KatsukiOishi/HikkiKomori/DOC/電子回路.png

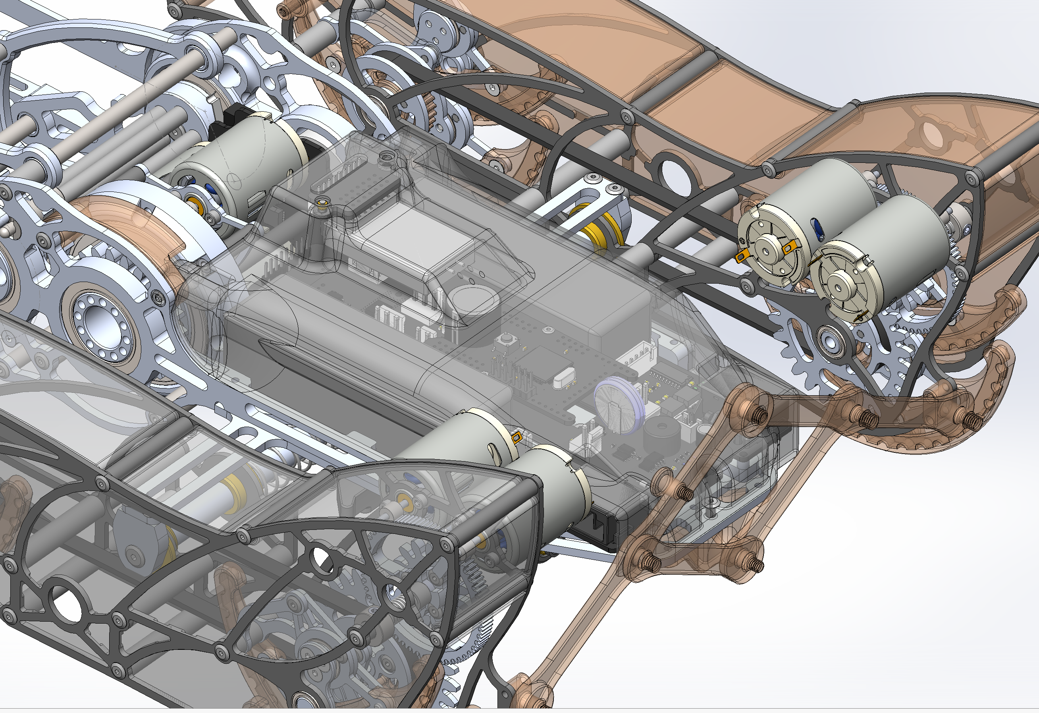
DOC/電子回路.png
