KatsukiOishi/HikkiKomori/DOC/裏面.png

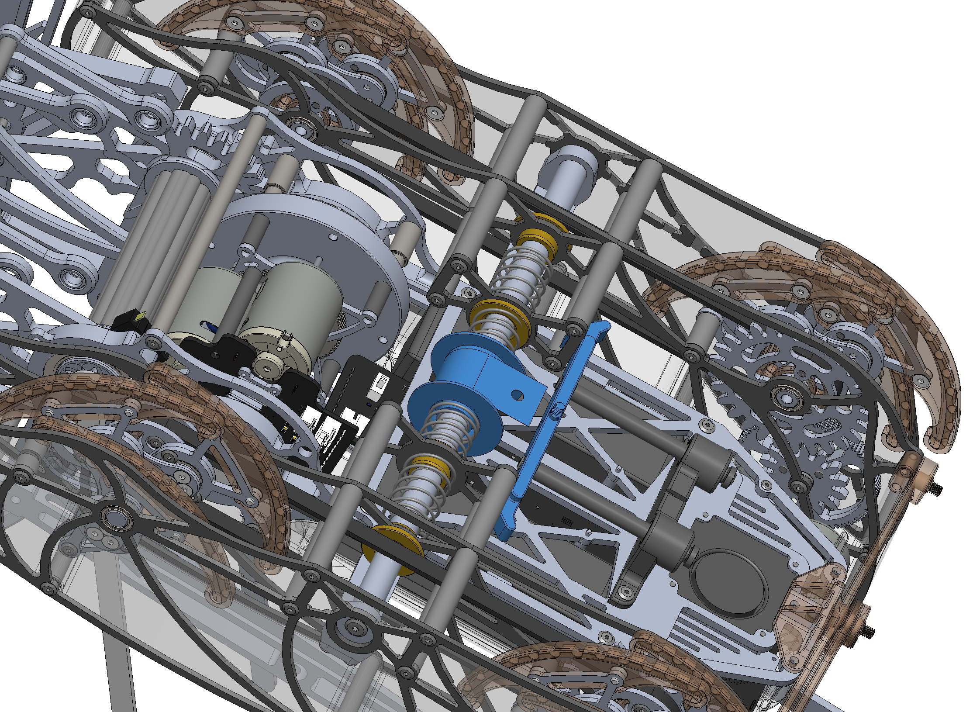
DOC/裏面.png
