KatsukiOishi/HikkiKomori/DOC/1.docx

1.ロボットの構造

ロボットは、”腕”を備えた「腕機構」、”動力源”たるバッテリー及び”通信機器”たる受信機及び制御回路を備えた「電装部」で構成される「中央ユニット」と、前記ユニットの左右それぞれに、移動のための”脚”が前後２つに搭載された「脚機構ユニット」が接続される構成となっている。“腕”の”駆動源”たるモーターは「腕機構」に３つ、”脚”の”駆動源”たるモーターは両側の「脚機構ユニット」にそれぞれ２つ搭載されており、ロボット全体では計７つ搭載される。モーターはいずれもタミヤ製「380スポーツチューンモーター」である。

2.ロボットの展開機構の動作概要

本機はスタート操作により、自動的に展開動作を開始する構造となっている。

1. 腕機構の作動 スタート時、「腕機構」に備えられた“アーム作動面”（ロングロッド）は、折りたたまれた状態で収納されている。スタート後に「腕機構」が作動することで、ロッド内に内蔵されたバネの反力によってロングロッドが前方へ大きく伸長する。
2. 脚機構ユニットの展開 「脚機構ユニット」の取付部には、「腕機構」と連動するワイヤが接続されており、このワイヤによりロック部品が解除される仕組みとなっている。ロック解除により、「脚機構ユニット」に内蔵された展開用バネが作動し、左右両側のユニットがそれぞれ外側に向かって展開される。

3.ロボットのサイズ

ロボットの初期状態は幅245mm、全長340mm、高さ200mmに収納されており、展開動作後は幅310mm、全長800mm、高さ560mm(最大アーム高さ)へと展開する。また、重量は3200gとなっている（設計時シュミレート）。

4.独自の動力電装系の実装

本機では、専用に開発された動力制御回路を電装部に搭載し、バッテリーの監視や、受信機からの信号を元に適切なモーターコントロールを行っている。
　バッテリーには近藤科学のLiFeバッテリーが２つ搭載されており、バッテリー及び回路保護のためのアクリルカバーが設けられている。
　”通信機器”たる受信機および送信機は双葉電子工業製のヘリ向けプロポを採用している。

5.脚機構

「脚機構ユニット」については1章にて述べた通り左右に２ユニット搭載されている。１ユニットにつき前後１つずつ”脚”が搭載されており、前後の”脚”はタイミングベルトによって同期駆動する。”駆動源”たるモーターは「脚機構ユニット」の後方上部に２つ搭載されており、前後の”脚”へ動力を供給する。

“脚”の構造にはヘッケンリンクを応用した四節リンク機構を採用しており、クランク軸を介して”駆動源”の動力が伝えられることで、120度ずつ位相をずらした３脚分の”脚機構”が駆動される。脚機構と床面の接触部となる”足裏”にはシリコンゴム製のパーツが取り付けられ、床面とのグリップ力を発揮する。

6.腕機構

「腕機構ユニット」については1章にて述べた通りスタート後に展開されるロングロッドを”アーム作動面”に有したリンク機構が”腕機構” として採用されている。

“腕機構”の構成としては、動力源となる「駆動節」と、敵機と接触する”アーム作動面”としての「従動節」、リンク機構を正しく動作させるために「従動節」の駆動を制限する「中間節」によって構成されており、「駆動節」を回転駆動させる回転動力は、”駆動源”たるモーター３基からの動力を、減速機を介して一つにまとめて供給する。

「駆動節」へ伝達された動力は、緑線にて示される「中間節」によって動きを制限されつつ、紫線によって図示される「従動節」へ伝達され、最終的に”アーム作動面”は左下図に示すような軌道を描きながら動作する。

回転動力となる「駆動節」は100度程度の角度範囲で動作し、無限回転はしない。

腕機構には随所に樹脂製のカバーを取り付け、駆動時の指巻き込みや機体巻き込みによる事故に配慮する構造となっている。
