KatsukiOishi/HikkiKomori/DOC/収納サイズ.png

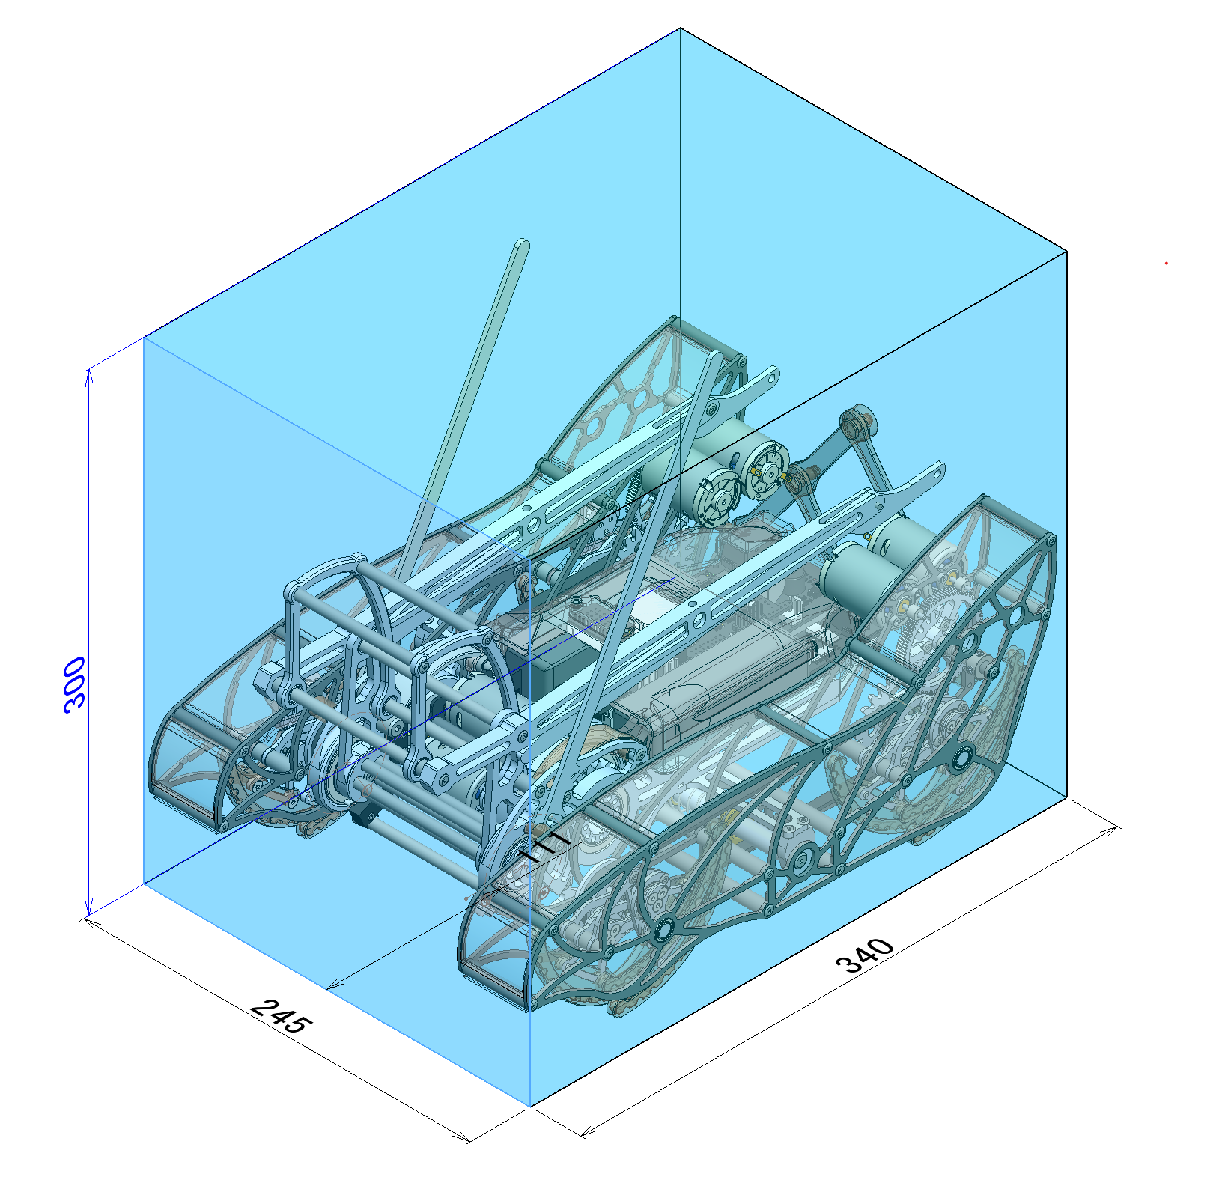
DOC/収納サイズ.png
