KatsukiOishi/HikkiKomori/DOC/展開サイズ.png

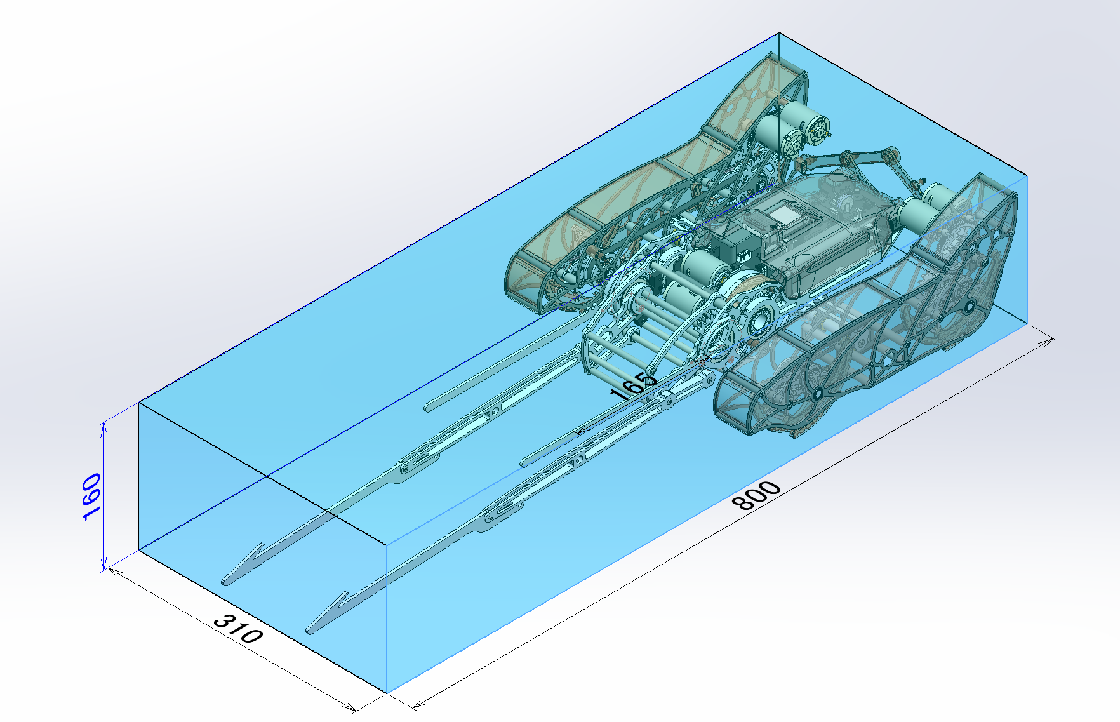
DOC/展開サイズ.png
