KatsukiOishi/HikkiKomori/DOC/腕機構１.png

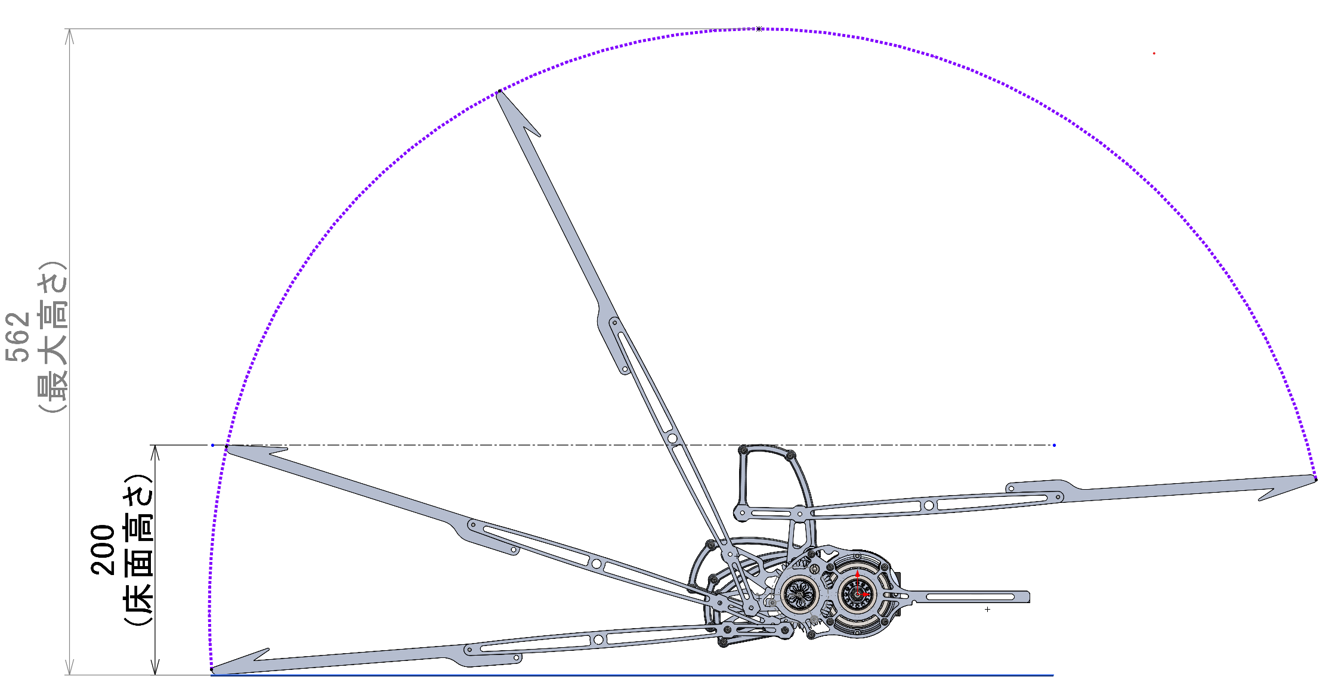
DOC/腕機構１.png
