KatsukiOishi/HikkiKomori/DOC/腕機構2.png

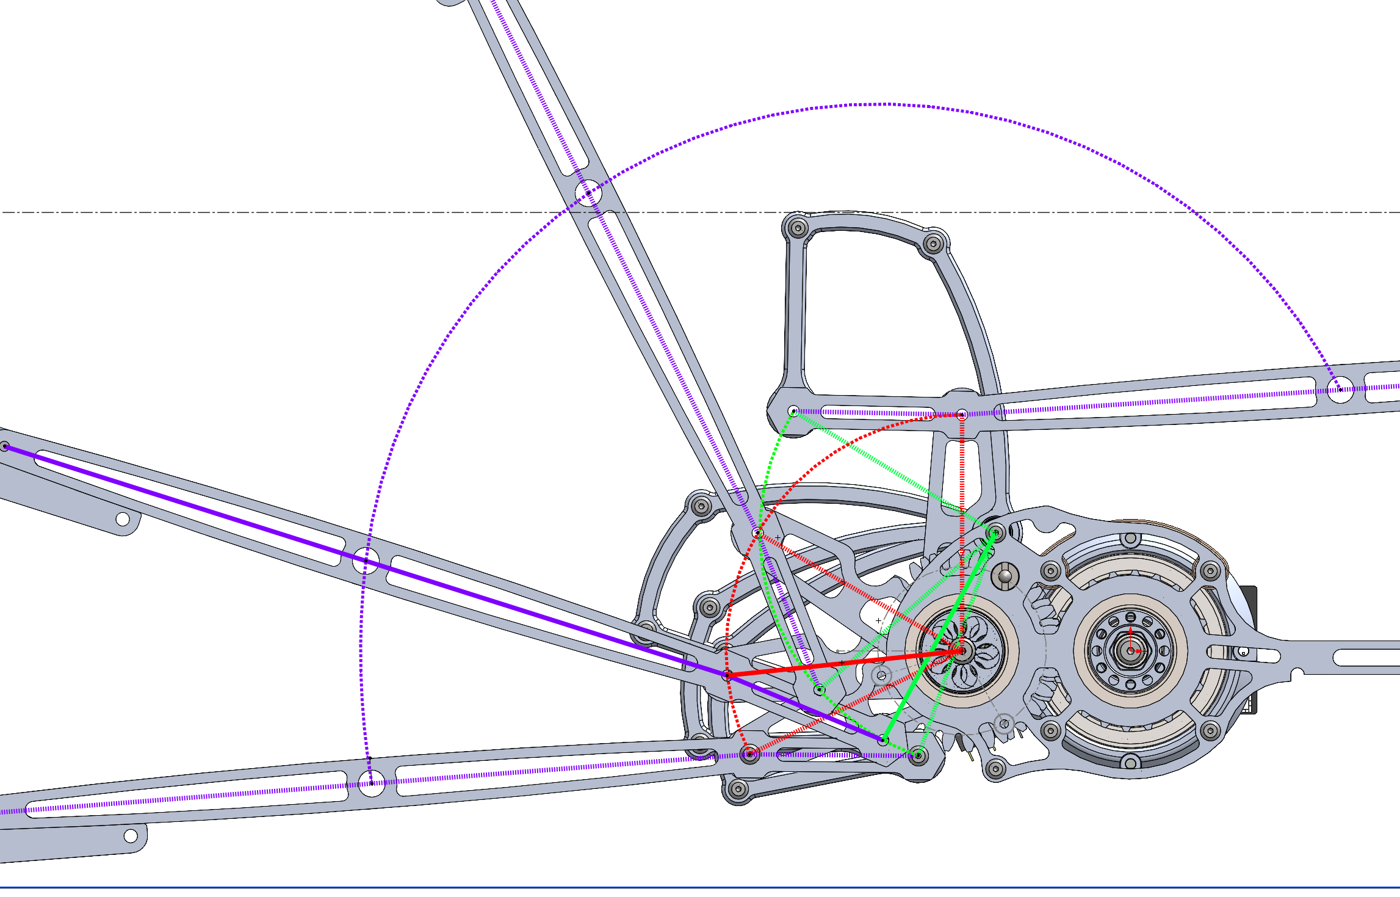
DOC/腕機構2.png
