KatsukiOishi/HikkiKomori/DOC/足機構.png

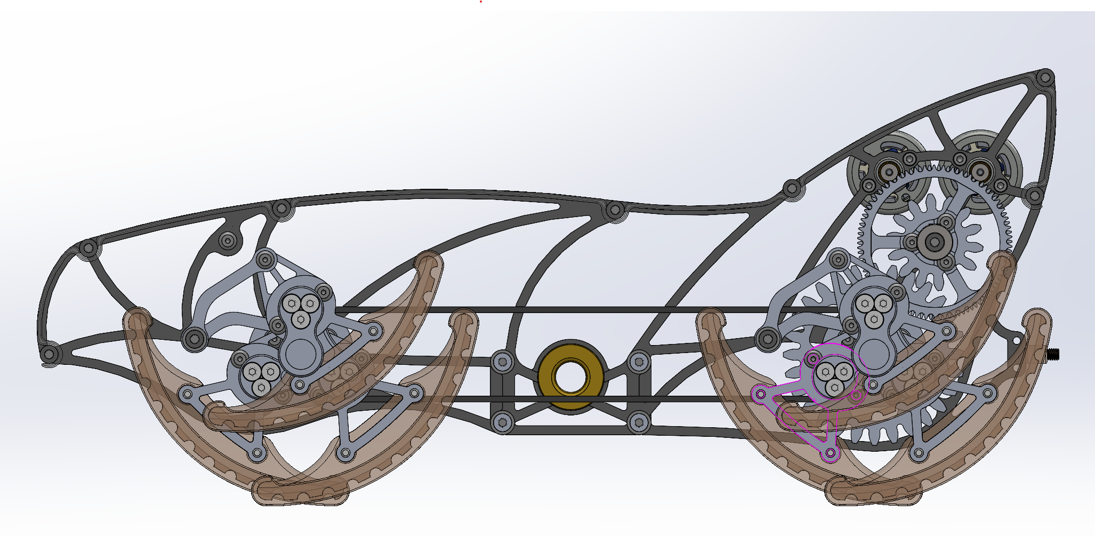
DOC/足機構.png
