KatsukiOishi/HikkiKomori/機械設計/_BOM/BOM.xlsx

Sheet: Sheet1
種類 | 部分 | 品番 | 手配先 | メーカー | 部品名 | 材料 | 個数 | 式 | 総個数 | 記 事 | 分類 | 出荷日 | 単価 | 表面処理 | 表面処理法 | 表面処理法補足 | 熱処理 | 熱処理法 | 硬度
組立品 | 0 | CU001 |  |  | 中央ユニット |  | 1 | 1 | 1 | 組立品(組図を参照) |  |  |  | 無 |  |  | 無
組立品 | 0 | RL001 |  |  | 左半身機構 |  | 1 | 1 | 1 | 組立品(組図を参照) |  |  |  | 無 |  |  | 無
組立品 | 0 | RR001 |  |  | 右半身機構 |  | 1 | 1 | 1 | 組立品(組図を参照) |  |  |  | 無 |  |  | 無
組立品 | CU001 | CU-SAS001 |  |  | 中央躯体 |  | 1 | 1 | 1 | 組立品(組図を参照) |  |  |  | 無 |  |  | 無
組立品 | CU001 | CU-SAS002 |  |  | 腕機構 |  | 1 | 1 | 1 | 組立品(組図を参照) |  |  |  | 無 |  |  | 無
組立品 | CU-SAS001 | CU-SAS003 |  |  | 展開機構 |  | 1 | 1 | 1 | 組立品(組図を参照) |  |  |  | 無 |  |  | 無
組立品 | CU-SAS002 | CGA75-RS380-4 |  |  | 腕機構減速機 |  | 1 | 1 | 1 | 組立品(組図を参照) |  |  |  | 無 |  |  | 無
組立品 | CU-SAS002 | CU-AAS001 |  |  | アームリンク中関節 |  | 1 | 1 | 1 | 組立品(組図を参照) |  |  |  | 無 |  |  | 無
組立品 | CU-SAS002 | CU-AAS002 |  |  | アームリンク駆動節 |  | 1 | 1 | 1 | 組立品(組図を参照) |  |  |  | 無 |  |  | 無
組立品 | CU-SAS002 | CU-AAS003L |  |  | ロングロッド左 |  | 1 | 1 | 1 | 組立品(組図を参照) |  |  |  | 無 |  |  | 無
組立品 | CU-SAS002 | CU-AAS003R |  |  | ロングロッド右 |  | 1 | 1 | 1 | 組立品(組図を参照) |  |  |  | 無 |  |  | 無
組立品 | RL001 | R-SA001 |  |  | 足中間歯車 |  | 1 | 1 | 1 | 組立品(組図を参照) |  |  |  | 無 |  |  | 無
組立品 | RL001 | RL-HL001 |  |  | ヘッケンリンク左半身後方 |  | 1 | 1 | 1 | 組立品(組図を参照) |  |  |  | 無 |  |  | 無
組立品 | RL001 | RL-HL002 |  |  | ヘッケンリンク左半身前方 |  | 1 | 1 | 1 | 組立品(組図を参照) |  |  |  | 無 |  |  | 無
組立品 | RL-HL001 | RL-HL-RAS001 |  |  | 足単体左半身側 |  | 3 | 1 | 3 | 組立品(組図を参照) |  |  |  | 無 |  |  | 無
組立品 | RL-HL002 | RL-HL-RAS001 |  |  | 足単体左半身側 |  | 3 | 1 | 3 | 組立品(組図を参照) |  |  |  | 無 |  |  | 無
組立品 | RR001 | R-SA001 |  |  | 足中間歯車 |  | 1 | 1 | 1 | 組立品(組図を参照) |  |  |  | 無 |  |  | 無
組立品 | RR001 | RR-HL001 |  |  | ヘッケンリンク右半身後方 |  | 1 | 1 | 1 | 組立品(組図を参照) |  |  |  | 無 |  |  | 無
組立品 | RR001 | RR-HL002 |  |  | ヘッケンリンク右半身前方 |  | 1 | 1 | 1 | 組立品(組図を参照) |  |  |  | 無 |  |  | 無
組立品 | RR-HL001 | RR-HL-RAS001 |  |  | 足単体右半身側 |  | 3 | 1 | 3 | 組立品(組図を参照) |  |  |  | 無 |  |  | 無
組立品 | RR-HL002 | RR-HL-RAS001 |  |  | 足単体右半身側 |  | 3 | 1 | 3 | 組立品(組図を参照) |  |  |  | 無 |  |  | 無
組立品 | R-SA001 | R-SA-GAS001 |  |  | 足中間歯車1 |  | 1 | 2 | 2 | 組立品(組図を参照) |  |  |  | 無 |  |  | 無
組立品 | CGA75-RS380-4 | CGA75 |  |  | 内接減速機構 |  | 1 | 1 | 1 | 組立品(組図を参照) |  |  |  | 無 |  |  | 無
社内加工品 | 0 | LS-P003 |  |  | リンクサス短辺 | AR-M2 | 2 | 1 | 2 |  |  |  |  | 無 |  |  | 無
社内加工品 | 0 | LS-P002 |  |  | リンクサス長辺 | AR-M2 | 2 | 1 | 2 |  |  |  |  | 無 |  |  | 無
社内加工品 | 0 | LS-P004 |  |  | リンクサス中央軸部 | AR-M2 | 1 | 1 | 1 |  |  |  |  | 無 | - | - | 無 | - | -
社内加工品 | 0 | LS-P005 |  |  | リンクサス節軸 | AR-M2 | 3 | 1 | 3 |  |  |  |  | 無 | - | - | 無 | - | -
社内加工品 | CU001 | CU-P001 |  |  | 中央ユニット後方カバー | AR-M2 | 1 | 1 | 1 |  |  |  |  | 無 | - | - | 無 | - | -
社内加工品 | CU-SAS001 | CU-P002 |  |  | 足駆動回路放熱板 | A2017 | 1 | 1 | 1 |  |  |  |  | 無 | - | - | 無 | - | -
社内加工品 | CU-SAS001 | CU-SAS001-P001 |  |  | 中央フレーム | A2017 | 1 | 1 | 1 |  |  |  |  | 無 |  |  | 無
社内加工品 | CU-SAS001 | CU-SAS001-P002 |  |  | 横展開抜止め | A2017 | 2 | 1 | 2 |  |  |  |  | 無 |  |  | 無
社内加工品 | CU-SAS001 | CU-SAS001-P003 |  |  | 中央ユニット主軸 | A2017 | 1 | 1 | 1 |  |  |  |  | 無 |  |  | 無
社内加工品 | CU-SAS002 | CU-AAS-P001 |  |  | カウンターアーム | A2017 | 1 | 1 | 1 |  |  |  |  | 無 | - | - | 無
社内加工品 | CU-SAS002 | CU-AAS-P002 |  |  | ﾐﾗｰカウンターアーム | A2017 | 1 | 1 | 1 |  |  |  |  | 無 | - | - | 無
社内加工品 | CU-SAS002 | CU-AAS-P003 |  |  | 腕機構カバー | AR-M2 | 1 | 1 | 1 |  |  |  |  | 無 | - | - | 無
社内加工品 | CU-SAS002 | CU-AAS-P004 |  |  | ﾐﾗｰ腕機構カバー | AR-M2 | 1 | 1 | 1 |  |  |  |  | 無 | - | - | 無
社内加工品 | CU-SAS002 | CU-SAS002-P001 |  |  | 最集段ピニオン | A2017 | 1 | 1 | 1 |  |  |  |  | 無 | - | - | 無
社内加工品 | CU-SAS002 | CU-SAS002-P002 |  |  | 腕機構内壁 | A2017 | 1 | 1 | 1 |  |  |  |  | 無 | - | - | 無
社内加工品 | CU-SAS002 | CU-SAS002-P003 |  |  | 腕機構内壁 | A2017 | 1 | 1 | 1 |  |  |  |  | 無 | - | - | 無
社内加工品 | CU-SAS003 | CU-SAS003-P001 |  |  | 抑制鍵 | AR-M2 | 1 | 1 | 1 |  |  |  |  | 無 |  |  | 無 | - | -
社内加工品 | CU-SAS003 | CU-SAS003-P002 |  |  | 展開機構ブロック | AR-M2 | 1 | 1 | 1 |  |  |  |  | 無 |  |  | 無 | - | -
社内加工品 | CU-AAS001 | CU-AAS001-P001 |  |  | 中関節 | A2017 | 2 | 1 | 2 |  |  |  |  | 無 |  |  | 無
社内加工品 | CU-AAS002 | CU-AAS002-P001 |  |  | 従動節根本軸 | A2017 | 2 | 1 | 2 |  |  |  |  | 無 |  |  | 無
社内加工品 | CU-AAS002 | CU-AAS002-P002 |  |  | 駆動節歯車付き | A2017 | 1 | 1 | 1 |  |  |  |  | 無 |  |  | 無
社内加工品 | CU-AAS002 | CU-AAS002-P003 |  |  | 駆動節 | A2017 | 1 | 1 | 1 |  |  |  |  | 無 |  |  | 無
社内加工品 | CU-AAS003L | CU-AAS003-P001 |  |  | ロッド先端 | A2017 | 1 | 1 | 1 |  |  |  |  | 無 | - | - | 無 | - | -
社内加工品 | CU-AAS003L | CU-AAS003L-P001 |  |  | 従動節左 | A2017 | 1 | 1 | 1 |  |  |  |  | 無 | - | - | 無 | - | -
社内加工品 | CU-AAS003R | CU-AAS003-P001 |  |  | ロッド先端 | A2017 | 1 | 1 | 1 |  |  |  |  | 無 | - | - | 無 | - | -
社内加工品 | CU-AAS003R | CU-AAS003R-P001 |  |  | 従動節右 | A2017 | 1 | 1 | 1 |  |  |  |  | 無 | - | - | 無 | - | -
社内加工品 | LS001 | LS001-P001 |  |  | リンクサス足側軸部 | AR-M2 | 1 | 0 | 0 |  |  |  |  | 無 | - | - | 無 | - | -
社内加工品 | RL001 | R-P001 |  |  | 足側板内側 | A2017 | 1 | 1 | 1 |  |  |  |  | 無 | - | - | 無 | - | -
社内加工品 | RL001 | R-P002 |  |  | 足機構固定板 | A2017 | 1 | 1 | 1 |  |  |  |  | 有 | アルマイト | 黒 | 無 | - | -
社内加工品 | RL001 | R-P003 |  |  | 足機構上面カバー | AR-M2 | 1 | 1 | 1 |  |  |  |  | 無 | - | - | 無 | - | -
社内加工品 | RL001 | R-P004 |  |  | 足機構主柱 | A2017 | 4 | 1 | 4 |  |  |  |  | 無 | - | - | 無 | - | -
社内加工品 | RL001 | R-P005 |  |  | カウンターアームロック | AR-M2 | 1 | 1 | 1 |  |  |  |  | 無 | - | - | 無 | - | -
社内加工品 | RL001 | RL-P001 |  |  | 足側板左外側 | A2017 | 1 | 1 | 1 |  |  |  |  | 無 | - | - | 無 | - | -
社内加工品 | RL001 | RL-P002 |  |  | 左足機構側面充填樹脂 | AR-M2 | 1 | 1 | 1 |  |  |  |  | 無 | - | - | 無 | - | -
社内加工品 | RL-HL001 | R-HL-P001 |  |  | 足曲軸長偏心体 | A2017 | 2 | 1 | 2 |  |  |  |  | 無 |  |  | 無
社内加工品 | RL-HL001 | R-HL-P002 |  |  | 足曲軸短偏心体 | A2017 | 1 | 1 | 1 |  |  |  |  | 無 |  |  | 無
社内加工品 | RL-HL001 | R-HL-P003 |  |  | 足プーリー中心軸 | A2017 | 1 | 1 | 1 |  |  |  |  | 無 | - | - | 無 | - | -
社内加工品 | RL-HL001 | R-HL-P004 |  |  | 足機構曲軸結合部 | A2017 | 1 | 1 | 1 |  |  |  |  | 無 |  |  | 無
社内加工品 | RL-HL001 | R-HL-P005 |  |  | ヘッケンリンク駆動プーリー | AR-M2 | 1 | 1 | 1 |  |  |  |  | 無 | - | - | 無 | - | -
社内加工品 | RL-HL001 | R-HL-P006 |  |  | 足プーリーフランジ | A2017 | 1 | 1 | 1 |  |  |  |  | 無 | - | - | 無 | - | -
社内加工品 | RL-HL001 | R-HL-P007 |  |  | 足レバー | A2017 | 3 | 1 | 3 |  |  |  |  | 無 | - | - | 無 | - | -
社内加工品 | RL-HL002 | R-HL-P001 |  |  | 足曲軸長偏心体 | A2017 | 2 | 1 | 2 |  |  |  |  | 無 |  |  | 無
社内加工品 | RL-HL002 | R-HL-P002 |  |  | 足曲軸短偏心体 | A2017 | 1 | 1 | 1 |  |  |  |  | 無 |  |  | 無
社内加工品 | RL-HL002 | R-HL-P003 |  |  | 足プーリー中心軸 | A2017 | 1 | 1 | 1 |  |  |  |  | 無 | - | - | 無 | - | -
社内加工品 | RL-HL002 | R-HL-P004 |  |  | 足機構曲軸結合部 | A2017 | 1 | 1 | 1 |  |  |  |  | 無 |  |  | 無
社内加工品 | RL-HL002 | R-HL-P005 |  |  | ヘッケンリンク駆動プーリー | AR-M2 | 1 | 1 | 1 |  |  |  |  | 無 | - | - | 無 | - | -
社内加工品 | RL-HL002 | R-HL-P006 |  |  | 足プーリーフランジ | A2017 | 1 | 1 | 1 |  |  |  |  | 無 | - | - | 無 | - | -
社内加工品 | RL-HL001 | R-HL-P007 |  |  | 足レバー | A2017 | 3 | 1 | 3 |  |  |  |  | 無 | - | - | 無 | - | -
社内加工品 | RL-HL-RAS001 | R-HL-RAS-P001 |  |  | 足上部 | A2017 | 1 | 6 | 6 |  |  |  |  | 無 |  |  | 無
社内加工品 | RL-HL-RAS001 | R-HL-RAS-P002 |  |  | 足下部 | A2017 | 1 | 6 | 6 |  |  |  |  | 無 |  |  | 無
社内加工品 | RL-HL-RAS001 | R-HL-RAS-P003 |  |  | 足ゴム | AR-M2 | 1 | 6 | 6 |  |  |  |  | 無 |  |  | 無
社内加工品 | RL-HL-RAS001 | RR-HL-RAS-P001 |  |  | 前足底左半身側 | AR-M2 | 1 | 6 | 6 |  |  |  |  | 無 |  |  | 無
社内加工品 | RR001 | LS001-P001 |  |  | リンクサス足側軸部 | AR-M2 | 1 | 1 | 1 |  |  |  |  | 無 | - | - | 無 | - | -
社内加工品 | RR001 | R-P001 |  |  | 足側板内側 | A2017 | 1 | 1 | 1 |  |  |  |  | 無 | - | - | 無 | - | -
社内加工品 | RR001 | R-P002 |  |  | 足機構固定板 | A2017 | 1 | 1 | 1 |  |  |  |  | 有 | アルマイト | 黒 | 無 | - | -
社内加工品 | RR001 | R-P003 |  |  | 足機構上面カバー | AR-M2 | 1 | 1 | 1 |  |  |  |  | 無 | - | - | 無 | - | -
社内加工品 | RR001 | R-P004 |  |  | 足機構主柱 | A2017 | 4 | 1 | 4 |  |  |  |  | 無 | - | - | 無 | - | -
社内加工品 | RR001 | R-P005 |  |  | カウンターアームロック | AR-M2 | 1 | 1 | 1 |  |  |  |  | 無 | - | - | 無 | - | -
社内加工品 | RR001 | RR-P001 |  |  | 足側板右外側 | A2017 | 1 | 1 | 1 |  |  |  |  | 無 | - | - | 無 | - | -
社内加工品 | RR001 | RR-P002 |  |  | 右足機構側面充填樹脂 | ｴﾎﾟｷｼ樹脂(充填剤なし) | 1 | 1 | 1 |  |  |  |  | 無 | - | - | 無 | - | -
社内加工品 | RR-HL001 | R-HL-P001 |  |  | 足曲軸長偏心体 | A2017 | 2 | 1 | 2 |  |  |  |  | 無 |  |  | 無
社内加工品 | RR-HL001 | R-HL-P002 |  |  | 足曲軸短偏心体 | A2017 | 1 | 1 | 1 |  |  |  |  | 無 |  |  | 無
社内加工品 | RR-HL001 | R-HL-P003 |  |  | 足プーリー中心軸 | A2017 | 1 | 1 | 1 |  |  |  |  | 無 | - | - | 無 | - | -
社内加工品 | RR-HL001 | R-HL-P004 |  |  | 足機構曲軸結合部 | A2017 | 1 | 1 | 1 |  |  |  |  | 無 |  |  | 無
社内加工品 | RR-HL001 | R-HL-P005 |  |  | ヘッケンリンク駆動プーリー | AR-M2 | 1 | 1 | 1 |  |  |  |  | 無 | - | - | 無 | - | -
社内加工品 | RR-HL001 | R-HL-P006 |  |  | 足プーリーフランジ | A2017 | 1 | 1 | 1 |  |  |  |  | 無 | - | - | 無 | - | -
社内加工品 | RR-HL001 | R-HL-P007 |  |  | 足レバー | A2017 | 3 | 1 | 3 |  |  |  |  | 無 | - | - | 無 | - | -
社内加工品 | RR-HL002 | R-HL-P001 |  |  | 足曲軸長偏心体 | A2017 | 2 | 1 | 2 |  |  |  |  | 無 |  |  | 無
社内加工品 | RR-HL002 | R-HL-P002 |  |  | 足曲軸短偏心体 | A2017 | 1 | 1 | 1 |  |  |  |  | 無 |  |  | 無
社内加工品 | RR-HL002 | R-HL-P003 |  |  | 足プーリー中心軸 | A2017 | 1 | 1 | 1 |  |  |  |  | 無 | - | - | 無 | - | -
社内加工品 | RR-HL002 | R-HL-P004 |  |  | 足機構曲軸結合部 | A2017 | 1 | 1 | 1 |  |  |  |  | 無 |  |  | 無
社内加工品 | RR-HL002 | R-HL-P005 |  |  | ヘッケンリンク駆動プーリー | AR-M2 | 1 | 1 | 1 |  |  |  |  | 無 | - | - | 無 | - | -
社内加工品 | RR-HL002 | R-HL-P006 |  |  | 足プーリーフランジ | A2017 | 1 | 1 | 1 |  |  |  |  | 無 | - | - | 無 | - | -
社内加工品 | RR-HL002 | R-HL-P007 |  |  | 足レバー | A2017 | 3 | 1 | 3 |  |  |  |  | 無 | - | - | 無 | - | -
社内加工品 | RR-HL-RAS001 | R-HL-RAS-P001 |  |  | 足上部 | A2017 | 1 | 6 | 6 |  |  |  |  | 無 |  |  | 無
社内加工品 | RR-HL-RAS001 | R-HL-RAS-P002 |  |  | 足下部 | A2017 | 1 | 6 | 6 |  |  |  |  | 無 |  |  | 無
社内加工品 | RR-HL-RAS001 | R-HL-RAS-P003 |  |  | 足ゴム | AR-M2 | 1 | 6 | 6 |  |  |  |  | 無 |  |  | 無
社内加工品 | RR-HL-RAS001 | RR-HL-RAS-P001 |  |  | 前足底右半身側 | AR-M2 | 1 | 6 | 6 |  |  |  |  | 無 |  |  | 無
社内加工品 | R-SA001 | R-SA001-P003 |  |  | 足中間歯車2 | A2017 | 1 | 2 | 2 |  |  |  |  | 無 | - | - | 無 | - | -
社内加工品 | R-SA001 | R-SA001-P001 |  |  | 足中間歯車1A | A2017 | 1 | 2 | 2 |  |  |  |  | 無 | - | - | 無 | - | -
社内加工品 | R-SA001 | R-SA001-P002 |  |  | 足中間歯車1B | A2017 | 1 | 2 | 2 |  |  |  |  | 無 | - | - | 無 | - | -
社内加工品 | CGA75-RS380-4 | CGA75-RS380-4-P001 |  |  | 腕電動機取付板 | A2017 | 1 | 1 | 1 |  |  |  |  | 無 | - | - | 無 | - | -
社内加工品 | CGA75-RS380-4 | CGA75-RS380-4-P002 |  |  | 腕機構回路放熱板 | A2017 | 1 | 1 | 1 |  |  |  |  | 無 | - | - | 無 | - | -
社内加工品 | CGA75 | CGA75-P001 |  |  | 内接歯車機構躯体 | A2017 | 1 | 1 | 1 | A2017 |  |  |  | 無 |  |  | 無
社内加工品 | CGA75 | CGA75-P002 |  |  | 出力板 | A2017 | 1 | 1 | 1 | A2017 |  |  |  | 無 |  |  | 無
社内加工品 | CGA75 | CGA75-P003 |  |  | 内歯車 | A2017 | 1 | 1 | 1 | A2017 |  |  |  | 無 |  |  | 無
社内加工品 | CGA75 | CGA75-P004 |  |  | 曲軸(歯車付き) | S45C | 1 | 1 | 1 | S50C |  |  |  | 有 | 黒染 |  | 無
自社製品 | CU001 | レシーバ v1 |  |  | レシーバ v1 |  | 1 | 1 | 1 |  |  |  |  | 無 | - | - | 無 | - | -
自社製品 | CU-SAS001 | 右足駆動回路v2 |  |  | 右足駆動回路v2 |  | 1 | 1 | 1 |  |  |  |  | 無 | - | - | 無 | - | -
自社製品 | CU-SAS001 | 左足駆動回路v2 |  |  | 左足駆動回路v2 |  | 1 | 1 | 1 |  |  |  |  | 無 | - | - | 無 | - | -
自社製品 | CU-SAS001 | 電子回路ユニット |  |  | 電子回路ユニット |  | 1 | 1 | 1 | 組立品(組図を参照) |  |  |  | 無 |  |  | 無
自社製品 | CGA75-RS380-4 | 腕駆動回路v2 |  |  | 腕駆動回路v2 | 電力回路基板 | 1 | 1 | 1 |  |  |  |  | 無 | - | - | 無 | - | -
購入品 | CU001 | F3-2100 | 近藤科学 | 近藤科学 | F3-2100 |  | 2 | 1 | 2 |  | バッテリー |  |  | 無 |  |  | 無
購入品 | CU001 | MBIS2-3-2 |  | MISUMI | MBIS2-3-2 | 黄銅 | 2 | 1 | 2 |  | ﾈｼﾞｲﾝｻｰﾄ | 1日目 | 64 | 無 |  |  | 無
購入品 | CU001 | CBSTBR2-5 |  | MISUMI | CBSTBR2-5 | SCM435 | 2 | 1 | 2 |  | 超極低頭ﾎﾞﾙﾄ | 1日目 | 260 | 無 |  |  | 無
購入品 | CU001 | CBSTBR3-10 |  | MISUMI | CBSTBR3-10 | SCM435 | 5 | 1 | 5 |  | 超極低頭ﾎﾞﾙﾄ | 1日目 | 280 | 無 |  |  | 無
購入品 | CU-SAS001 | BRL-2011SBE | 廣杉計器 | 廣杉計器 | BRL-2011SBE | A2017 | 4 | 1 | 4 |  | スペーサー |  |  | 無 | - | - | 無 | - | -
購入品 | CU-SAS001 | BRL-311SBE | 廣杉計器 | 廣杉計器 | BRL-311SBE | A2017 | 1 | 1 | 1 |  | スペーサー |  |  | 無 | - | - | 無 | - | -
購入品 | CU-SAS001 | VUY10-55 |  | MISUMI | VUY10-55 | SUS304-WPB | 2 | 1 | 2 |  | 丸線ｺｲﾙｽﾌﾟﾘﾝｸﾞ | 1日目 | 899 | 無 |  |  | 無
購入品 | CU-SAS001 | VUR16-55 |  | MISUMI | VUR16-55 | SUS304-WPB | 2 | 1 | 2 |  | 丸線ｺｲﾙｽﾌﾟﾘﾝｸﾞ | 1日目 | 535 | 無 |  |  | 無
購入品 | CU-SAS001 | 小型ファン | Amazon | Amazon | 小型ファン | ABS | 1 | 1 | 1 |  | 小型ファン |  |  | 無 | - | - | 無 | - | -
購入品 | CU-SAS001 | CFS0.4 |  | MISUMI | CFS0.4 |  | 1 | 1 | 1 |  | 定荷重ばね | 1日目 | 1880 | 無 |  |  | 無
購入品 | CU-SAS001 | CBSTBR3-6 |  | MISUMI | CBSTBR3-6 | SCM435 | 6 | 1 | 6 |  | 超極低頭ﾎﾞﾙﾄ | 1日目 | 280 | 無 |  |  | 無
購入品 | CU-SAS001 | CBSTBR2-5 |  | MISUMI | CBSTBR2-5 | SCM435 | 8 | 1 | 8 |  | 超極低頭ﾎﾞﾙﾄ | 1日目 | 260 | 無 |  |  | 無
購入品 | CU-SAS001 | CBSTBR3-10 |  | MISUMI | CBSTBR3-10 | SCM435 | 2 | 1 | 2 |  | 超極低頭ﾎﾞﾙﾄ | 1日目 | 280 | 無 |  |  | 無
購入品 | CU-SAS001 | CBSTSR4-8 |  | MISUMI | CBSTSR4-8 | SUS304相当 | 2 | 1 | 2 |  | 超極低頭ﾎﾞﾙﾄ | 1日目 | 280 | 無 |  |  | 無
購入品 | CU-SAS002 | DP-C3X20 | MISUMI | 大喜多 | DP-C3X20 | ダウエルピン | 6 | 1 | 6 | ダウエルピン 大喜多A種 (φ3 x 20) | ダウエルピン
購入品 | CU-SAS002 | SS_10GL13 | 秋月電子 | 秋月電子 | SS_10GL13 | スイッチ | 2 | 1 | 2 |  | スイッチ |  |  | 無 |  |  | 無
購入品 | CU-SAS002 | PJLS10-5 | MISUMI | MISUMI | PJLS10-5 | S45C | 2 | 1 | 2 | PART--DESC | プランジャ |  |  | 無 | - | - | 無
購入品 | CU-SAS002 | CLJW6-8-12.0 |  | MISUMI | CLJW6-8-12.0 | MCナイロン | 2 | 1 | 2 |  | 樹脂ｶﾗｰ | 2日目 | 260 | 無 |  |  | 無
購入品 | CU-SAS002 | YDH3007C05F | 秋月電子 | 秋月電子 | YDH3007C05F |  | 1 | 1 | 1 |  | 小型ファン |  |  | 無 | - | - | 無
購入品 | CU-SAS002 | FWSJW-D8-V6-T6.0 |  | MISUMI | FWSJW-D8-V6-T6.0 | MCナイロン | 2 | 1 | 2 |  | 樹脂ﾜｯｼｬ | 2日目 | 330 | 無 |  |  | 無
購入品 | CU-SAS002 | B6805ZZ |  | MISUMI | B6805ZZ | SUJ2 | 3 | 1 | 3 |  | 玉軸受 | 1日目 | 510 | 無 |  |  | 無
購入品 | CU-SAS002 | CBSTBR3-10 |  | MISUMI | CBSTBR3-10 | SCM435 | 4 | 1 | 4 |  | 超極低頭ﾎﾞﾙﾄ | 1日目 | 280 | 無 |  |  | 無
購入品 | CU-SAS002 | CBSTBR3-6 |  | MISUMI | CBSTBR3-6 | SCM435 | 10 | 1 | 10 |  | 超極低頭ﾎﾞﾙﾄ | 1日目 | 280 | 無 |  |  | 無
購入品 | CU-SAS002 | CBSTBR2-10 |  | MISUMI | CBSTBR2-10 | SCM435 | 4 | 1 | 4 |  | 超極低頭ﾎﾞﾙﾄ | 1日目 | 260 | 無 |  |  | 無
購入品 | CU-SAS002 | SFHRW6-103.0-M3-N3 |  |  | SFHRW6-103.0-M3-N3 |  | 2 | 1 | 2 |  | 回転軸 |  |  | 無 |  |  | 無
購入品 | CU-SAS002 | SFRHH6-109.0-F2.5-P5-T2.5-M3 |  |  | SFRHH6-109.0-F2.5-P5-T2.5-M3 |  | 2 | 1 | 2 |  | 回転軸 |  |  | 無 |  |  | 無
購入品 | CU-SAS002 | SFRMGH8-15.0-F2.8-P6-T4.9-M3 |  | MISUMI | SFRMGH8-15.0-F2.8-P6-T4.9-M3 |  | 6 | 1 | 6 |  | 回転軸 | 2日目 | 580 | 無 |  |  | 無
購入品 | CU-SAS003 | ARL-360BE | 廣杉計器 | 廣杉計器 | ARL-360BE | KS26 | 2 | 1 | 2 |  | スペーサー |  |  | 有 | アルマイト | 黒 | 無 | - | -
購入品 | CU-SAS003 | WSJK8-3-2 |  | MISUMI | WSJK8-3-2 | ポリアセタール | 2 | 1 | 2 |  | 樹脂ﾜｯｼｬ | 1日目 | 80 | 無 |  |  | 無
購入品 | CU-SAS003 | CBSTBR3-10 |  | MISUMI | CBSTBR3-10 | SCM435 | 2 | 1 | 2 |  | 超極低頭ﾎﾞﾙﾄ | 1日目 | 280 | 無 |  |  | 無
購入品 | CU-SAS003 | CBSTBR3-6 |  | MISUMI | CBSTBR3-6 | SCM435 | 2 | 1 | 2 |  | 超極低頭ﾎﾞﾙﾄ | 1日目 | 280 | 無 |  |  | 無
購入品 | CU-SAS003 | MPBZ6-15 |  | MISUMI | MPBZ6-15 | 黄銅 | 2 | 1 | 2 |  | 無給油ﾌﾞｯｼｭ | 1日目 | 490 | 無 |  |  | 無
購入品 | CU-AAS001 | ABETTF6-75.0-M3-N3 | MISUMI | MISUMI | ABETTF6-75.0-M3-N3 | A2017-T4 | 2 | 1 | 2 |  | 円形支柱 | 5日目 | 710 | 無 |  |  | 無
購入品 | CU-AAS001 | CBSTBR3-10 |  | MISUMI | CBSTBR3-10 | SCM435 | 4 | 1 | 4 |  | 超極低頭ﾎﾞﾙﾄ | 1日目 | 280 | 無 |  |  | 無
購入品 | CU-AAS001 | BFLB6-5 |  | MISUMI | BFLB6-5 | A2017 | 4 | 1 | 4 |  | 無給油ﾌﾞｯｼｭ | 1日目 | 1190 | 無 |  |  | 無
購入品 | CU-AAS002 | DPS-C6X20 | MISUMI | 大喜多 | DPS-C6X20 | S45C | 2 | 1 | 2 |  | ダウエルピン |  |  | 無 | - | - | 無 | - | -
購入品 | CU-AAS002 | ABETTF6-90.0-M3-N3 |  | MISUMI | ABETTF6-90.0-M3-N3 | A2017-T4 | 5 | 1 | 5 |  | 円形支柱 | 5日目 | 710 | 無 |  |  | 無
購入品 | CU-AAS002 | BFLB6-5 |  | MISUMI | BFLB6-5 | A2017 | 2 | 1 | 2 |  | 無給油ﾌﾞｯｼｭ | 1日目 | 1190 | 無 |  |  | 無
購入品 | CU-AAS002 | CBSTBR3-10 |  | MISUMI | CBSTBR3-10 | SCM435 | 10 | 1 | 10 |  | 超極低頭ﾎﾞﾙﾄ | 1日目 | 280 | 無 |  |  | 無
購入品 | CU-AAS002 | CBSTSR4-8 |  | MISUMI | CBSTSR4-8 | SUS304相当 | 4 | 1 | 4 |  | 超極低頭ﾎﾞﾙﾄ | 1日目 | 280 | 無 |  |  | 無
購入品 | CU-AAS003L | CL-306E | 廣杉計器 | 廣杉計器 | CL-306E | KS26 | 1 | 1 | 1 |  | スペーサー |  |  | 無 | - | - | 無 | - | -
購入品 | CU-AAS003L | CBSTBR3-10 |  | MISUMI | CBSTBR3-10 | SCM435 | 1 | 1 | 1 |  | 超極低頭ﾎﾞﾙﾄ | 1日目 | 280 | 無 |  |  | 無
購入品 | CU-AAS003R | CL-306E | 廣杉計器 | 廣杉計器 | CL-306E | KS26 | 1 | 1 | 1 |  | スペーサー |  |  | 無 | - | - | 無 | - | -
購入品 | CU-AAS003R | CBSTBR3-10 |  | MISUMI | CBSTBR3-10 | SCM435 | 1 | 1 | 1 |  | 超極低頭ﾎﾞﾙﾄ | 1日目 | 280 | 無 |  |  | 無
購入品 | RL001 | ARL-340BE | 廣杉計器 | 廣杉計器 | ARL-340BE | KS26 | 7 | 1 | 7 |  | スペーサー |  |  | 有 | アルマイト | 黒 | 無 | - | -
購入品 | RL001 | HTBN474S3M-60 | MISUMI | MISUMI | HTBN474S3M-60 | ﾆﾄﾘﾙｺﾞﾑ(NBR) | 1 | 1 | 1 |  | タイミングベルト |  |  | 無 | - | - | 無 | - | -
購入品 | RL001 | CBSTBR3-6 |  | MISUMI | CBSTBR3-6 | SCM435 | 28 | 1 | 28 |  | 超極低頭ﾎﾞﾙﾄ | 1日目 | 280 | 無 |  |  | 無
購入品 | RL001 | CBSTBR3-10 |  | MISUMI | CBSTBR3-10 | SCM435 | 1 | 1 | 1 |  | 超極低頭ﾎﾞﾙﾄ | 1日目 | 280 | 無 |  |  | 無
購入品 | RL001 | MPFZ10-8 |  | MISUMI | MPFZ10-8 | 黄銅 | 2 | 1 | 2 |  | 無給油ﾌﾞｯｼｭ | 1日目 | 500 | 無 |  |  | 無
購入品 | RL001 | CB2.6-5 |  | MISUMI | CB2.6-5 | SCM435 | 4 | 1 | 4 |  | 六角穴付ﾎﾞﾙﾄ | 1日目 | 642 | 無 |  |  | 無
購入品 | RL001 | RS380-PH | Amazon | マブチ | RS380-PH | 材料 <指定なし> | 2 | 1 | 2 | 馬渕モータ RS380PH | 電動機 |  |  | 無 |  |  | 無
購入品 | RL001 | SS0.5-10 | KHK | KHK | SS0.5-10 | S45C | 2 | 1 | 2 |  | 平歯車 |  | 150 | 無 | - | - | 無 | - | -
購入品 | RL001 | CLJW6-8-40.0 |  | MISUMI | CLJW6-8-40.0 | MCナイロン | 4 | 1 | 4 |  | 樹脂ｶﾗｰ | 2日目 | 300 | 無 |  |  | 無
購入品 | RL001 | CLJW6-8-38.0 |  | MISUMI | CLJW6-8-38.0 | MCナイロン | 4 | 1 | 4 |  | 樹脂ｶﾗｰ | 2日目 | 300 | 無 |  |  | 無
購入品 | RL-HL001 | ARL-340BE |  |  | ARL-340BE | KS26 | 1 | 1 | 1 |  | スペーサー |  |  | 有 | アルマイト | 黒 | 無 | - | -
購入品 | RL-HL001 | CLJW6-8-15.5 |  | MISUMI | CLJW6-8-15.5 | MCナイロン | 1 | 1 | 1 |  | 樹脂ｶﾗｰ | 2日目 | 260 | 無 |  |  | 無
購入品 | RL-HL001 | FWSJW-D8-V6-T6.0 |  | MISUMI | FWSJW-D8-V6-T6.0 | MCナイロン | 2 | 1 | 2 |  | 樹脂ﾜｯｼｬ | 2日目 | 330 | 無 |  |  | 無
購入品 | RL-HL001 | FWSJW-D8-V6-T5.5 |  | MISUMI | FWSJW-D8-V6-T5.5 | MCナイロン | 1 | 1 | 1 |  | 樹脂ﾜｯｼｬ | 2日目 | 330 | 無 |  |  | 無
購入品 | RL-HL001 | FL678ZZ |  | MISUMI | FL678ZZ | SUJ2 | 2 | 1 | 2 |  | 玉軸受 | 1日目 | 510 | 無 |  |  | 無
購入品 | RL-HL001 | SFB3-10 | MISUMI | MISUMI | SFB3-10 | SUS304相当 | 9 | 1 | 9 |  | 皿ねじ |  |  | 無 |  |  | 無
購入品 | RL-HL001 | CBSTBR3-10 |  | MISUMI | CBSTBR3-10 | SCM435 | 3 | 1 | 3 |  | 超極低頭ﾎﾞﾙﾄ | 1日目 | 280 | 無 |  |  | 無
購入品 | RL-HL002 | ARL-340BE |  |  | ARL-340BE | KS26 | 1 | 1 | 1 |  | スペーサー |  |  | 有 | アルマイト | 黒 | 無 | - | -
購入品 | RL-HL002 | CLJW6-8-15.5 |  | MISUMI | CLJW6-8-15.5 | MCナイロン | 1 | 1 | 1 |  | 樹脂ｶﾗｰ | 2日目 | 260 | 無 |  |  | 無
購入品 | RL-HL002 | FWSJW-D8-V6-T6.0 |  | MISUMI | FWSJW-D8-V6-T6.0 | MCナイロン | 2 | 1 | 2 |  | 樹脂ﾜｯｼｬ | 2日目 | 330 | 無 |  |  | 無
購入品 | RL-HL002 | FWSJW-D8-V6-T5.5 |  | MISUMI | FWSJW-D8-V6-T5.5 | MCナイロン | 1 | 1 | 1 |  | 樹脂ﾜｯｼｬ | 2日目 | 330 | 無 |  |  | 無
購入品 | RL-HL002 | FL678ZZ |  | MISUMI | FL678ZZ | SUJ2 | 2 | 1 | 2 |  | 玉軸受 | 1日目 | 510 | 無 |  |  | 無
購入品 | RL-HL002 | SFB3-10 | MISUMI | MISUMI | SFB3-10 | SUS304相当 | 9 | 1 | 9 |  | 皿ねじ |  |  | 無 |  |  | 無
購入品 | RL-HL002 | CBSTBR3-10 |  | MISUMI | CBSTBR3-10 | SCM435 | 3 | 1 | 3 |  | 超極低頭ﾎﾞﾙﾄ | 1日目 | 280 | 無 |  |  | 無
購入品 | RL-HL-RAS001 | B6700ZZ |  | MISUMI | B6700ZZ | SUJ2 | 1 | 6 | 6 |  | 玉軸受 | 1日目 | 710 | 無 |  |  | 無
購入品 | RL-HL-RAS001 | SFB3-5 | MISUMI | MISUMI | SFB3-5 | SUS304相当 | 2 | 6 | 12 |  | 皿ねじ |  |  | 無 |  |  | 無
購入品 | RL-HL-RAS001 | CBSTBR3-4 |  | MISUMI | CBSTBR3-4 | SCM435 | 3 | 6 | 18 |  | 超極低頭ﾎﾞﾙﾄ | 1日目 | 280 | 無 |  |  | 無
購入品 | RL-HL-RAS001 | WSSB5-3-2 |  | MISUMI | WSSB5-3-2 | S45C相当 | 1 | 6 | 6 |  | 金属ﾜｯｼｬ | 1日目 | 160 | 無 |  |  | 無
購入品 | RR001 | ARL-340BE | 廣杉計器 | 廣杉計器 | ARL-340BE | KS26 | 7 | 1 | 7 |  | スペーサー |  |  | 有 | アルマイト | 黒 | 無 | - | -
購入品 | RR001 | HTBN474S3M-60 | MISUMI | MISUMI | HTBN474S3M-60 | ﾆﾄﾘﾙｺﾞﾑ(NBR) | 1 | 1 | 1 |  | タイミングベルト |  |  | 無 | - | - | 無 | - | -
購入品 | RR001 | CBSTBR3-6 |  | MISUMI | CBSTBR3-6 | SCM435 | 28 | 1 | 28 |  | 超極低頭ﾎﾞﾙﾄ | 1日目 | 280 | 無 |  |  | 無
購入品 | RR001 | CBSTBR3-10 |  | MISUMI | CBSTBR3-10 | SCM435 | 1 | 1 | 1 |  | 超極低頭ﾎﾞﾙﾄ | 1日目 | 280 | 無 |  |  | 無
購入品 | RR001 | MPFZ10-8 |  | MISUMI | MPFZ10-8 | 黄銅 | 2 | 1 | 2 |  | 無給油ﾌﾞｯｼｭ | 1日目 | 500 | 無 |  |  | 無
購入品 | RR001 | CB2.6-5 |  | MISUMI | CB2.6-5 | SCM435 | 4 | 1 | 4 |  | 六角穴付ﾎﾞﾙﾄ | 1日目 | 642 | 無 |  |  | 無
購入品 | RR001 | CLJW6-8-40.0 |  | MISUMI | CLJW6-8-40.0 | MCナイロン | 4 | 1 | 4 |  | 樹脂ｶﾗｰ | 2日目 | 300 | 無 |  |  | 無
購入品 | RR001 | CLJW6-8-38.0 |  | MISUMI | CLJW6-8-38.0 | MCナイロン | 4 | 1 | 4 |  | 樹脂ｶﾗｰ | 2日目 | 300 | 無 |  |  | 無
購入品 | RR001 | RS380-PH | Amazon | マブチ | RS380-PH | 材料 <指定なし> | 2 | 1 | 2 | 馬渕モータ RS380PH | 電動機 |  |  | 無 |  |  | 無
購入品 | RR001 | SS0.5-10 | KHK | KHK | SS0.5-10 | S45C | 2 | 1 | 2 |  | 平歯車 |  | 150 | 無 | - | - | 無 | - | -
購入品 | RR-HL001 | ARL-340BE |  |  | ARL-340BE | KS26 | 1 | 1 | 1 |  |  |  |  | 有 | アルマイト | 黒 | 無 | - | -
購入品 | RR-HL001 | CLJW6-8-15.5 |  | MISUMI | CLJW6-8-15.5 | MCナイロン | 1 | 1 | 1 |  | 樹脂ｶﾗｰ | 2日目 | 260 | 無 |  |  | 無
購入品 | RR-HL001 | FWSJW-D8-V6-T6.0 |  | MISUMI | FWSJW-D8-V6-T6.0 | MCナイロン | 2 | 1 | 2 |  | 樹脂ﾜｯｼｬ | 2日目 | 330 | 無 |  |  | 無
購入品 | RR-HL001 | FWSJW-D8-V6-T5.5 |  | MISUMI | FWSJW-D8-V6-T5.5 | MCナイロン | 1 | 1 | 1 |  | 樹脂ﾜｯｼｬ | 2日目 | 330 | 無 |  |  | 無
購入品 | RR-HL001 | FL678ZZ |  | MISUMI | FL678ZZ | SUJ2 | 2 | 1 | 2 |  | 玉軸受 | 1日目 | 510 | 無 |  |  | 無
購入品 | RR-HL001 | SFB3-10 | MISUMI | MISUMI | SFB3-10 | SUS304相当 | 9 | 1 | 9 |  | 皿ねじ |  |  | 無 |  |  | 無
購入品 | RR-HL001 | CBSTBR3-10 |  | MISUMI | CBSTBR3-10 | SCM435 | 3 | 1 | 3 |  | 超極低頭ﾎﾞﾙﾄ | 1日目 | 280 | 無 |  |  | 無
購入品 | RR-HL002 | ARL-340BE |  |  | ARL-340BE | KS26 | 1 | 1 | 1 |  |  |  |  | 有 | アルマイト | 黒 | 無 | - | -
購入品 | RR-HL002 | CLJW6-8-15.5 |  | MISUMI | CLJW6-8-15.5 | MCナイロン | 1 | 1 | 1 |  | 樹脂ｶﾗｰ | 2日目 | 260 | 無 |  |  | 無
購入品 | RR-HL002 | FWSJW-D8-V6-T6.0 |  | MISUMI | FWSJW-D8-V6-T6.0 | MCナイロン | 2 | 1 | 2 |  | 樹脂ﾜｯｼｬ | 2日目 | 330 | 無 |  |  | 無
購入品 | RR-HL002 | FWSJW-D8-V6-T5.5 |  | MISUMI | FWSJW-D8-V6-T5.5 | MCナイロン | 1 | 1 | 1 |  | 樹脂ﾜｯｼｬ | 2日目 | 330 | 無 |  |  | 無
購入品 | RR-HL002 | FL678ZZ |  | MISUMI | FL678ZZ | SUJ2 | 2 | 1 | 2 |  | 玉軸受 | 1日目 | 510 | 無 |  |  | 無
購入品 | RR-HL002 | SFB3-10 | MISUMI | MISUMI | SFB3-10 | SUS304相当 | 9 | 1 | 9 |  | 皿ねじ |  |  | 無 |  |  | 無
購入品 | RR-HL002 | CBSTBR3-10 |  | MISUMI | CBSTBR3-10 | SCM435 | 3 | 1 | 3 |  | 超極低頭ﾎﾞﾙﾄ | 1日目 | 280 | 無 |  |  | 無
購入品 | RR-HL-RAS001 | B6700ZZ |  | MISUMI | B6700ZZ | SUJ2 | 1 | 6 | 6 |  | 玉軸受 | 1日目 | 710 | 無 |  |  | 無
購入品 | RR-HL-RAS001 | SFB3-5 | MISUMI | MISUMI | SFB3-5 | SUS304相当 | 2 | 6 | 12 |  | 皿ねじ |  |  | 無 |  |  | 無
購入品 | RR-HL-RAS001 | CBSTBR3-4 |  | MISUMI | CBSTBR3-4 | SCM435 | 3 | 6 | 18 |  | 超極低頭ﾎﾞﾙﾄ | 1日目 | 280 | 無 |  |  | 無
購入品 | RR-HL-RAS001 | WSSB5-3-2 |  | MISUMI | WSSB5-3-2 | S45C相当 | 1 | 6 | 6 |  | 金属ﾜｯｼｬ | 1日目 | 160 | 無 |  |  | 無
購入品 | R-SA001 | ARL-340BE | 廣杉計器 | 廣杉計器 | ARL-340BE | KS26 | 1 | 2 | 2 |  | スペーサー |  |  | 有 | アルマイト | 黒 | 無 | - | -
購入品 | R-SA001 | VUR6-20 |  | MISUMI | VUR6-20 | SUS304-WPB | 1 | 2 | 2 |  | 丸線ｺｲﾙｽﾌﾟﾘﾝｸﾞ | 1日目 | 268 | 無 |  |  | 無
購入品 | R-SA001 | CBSTBR3-6 |  | MISUMI | CBSTBR3-6 | SCM435 | 3 | 2 | 6 |  | 超極低頭ﾎﾞﾙﾄ | 1日目 | 280 | 無 |  |  | 無
購入品 | R-SA001 | SCCN6-6 |  | MISUMI | SCCN6-6 | 材料 <指定なし> | 1 | 2 | 2 |  | ｾｯﾄｶﾗｰ | 1日目 | 90 | 無 |  |  | 無
購入品 | R-SA001 | FWSJW-D8-V6-T5.5 |  | MISUMI | FWSJW-D8-V6-T5.5 | MCナイロン | 1 | 2 | 2 |  | 樹脂ﾜｯｼｬ | 2日目 | 330 | 無 |  |  | 無
購入品 | R-SA001 | MPBRU6-8 |  | MISUMI | MPBRU6-8 | 材料 <指定なし> | 1 | 2 | 2 |  | 無給油ﾌﾞｯｼｭ | 1日目 | 720 | 無 |  |  | 無
購入品 | R-SA001 | WSSB8-6-1.5 |  | MISUMI | WSSB8-6-1.5 | S45C相当 | 1 | 2 | 2 |  | 金属ﾜｯｼｬ | 1日目 | 160 | 無 |  |  | 無
購入品 | CGA75-RS380-4 | ARL-340BE | 廣杉計器 | 廣杉計器 | ARL-340BE | KS26 | 3 | 1 | 3 |  | スペーサー |  |  | 有 | アルマイト | 黒 | 無 | - | -
購入品 | CGA75-RS380-4 | CB2.6-5 |  | MISUMI | CB2.6-5 | SCM435 | 6 | 1 | 6 |  | 六角穴付ﾎﾞﾙﾄ | 1日目 | 642 | 無 |  |  | 無
購入品 | CGA75-RS380-4 | RS380-PH | Amazon | マブチ | RS380-PH | 材料 <指定なし> | 3 | 1 | 3 | 馬渕モータ RS380PH | 電動機 |  |  | 無 |  |  | 無
購入品 | CGA75-RS380-4 | SS0.5-10 | KHK | KHK | SS0.5-10 | S45C | 3 | 1 | 3 |  | 平歯車 |  | 150 | 無 | - | - | 無 | - | -
購入品 | CGA75-RS380-4 | CL-315BE | 廣杉計器 | 廣杉計器 | CL-315BE | KS26 | 4 | 1 | 4 |  | ｽﾍﾟｰｻｰ |  | 46 | 有 | アルマイト | 黒 | 無 | - | -
購入品 | CGA75 | DP-C4x12 | MISUMI | 大喜多 | DP-C4x12 | 炭素鋼(普通) | 8 | 1 | 8 | 大喜多規格ダウエルピンC型 | ダウエルピン |  |  | 無 |  |  | 無
購入品 | CGA75 | GEFHBB0.5-80-5-15-W0-LFC27-M6 |  | MISUMI | GEFHBB0.5-80-5-15-W0-LFC27-M6 | 材料 <指定なし> | 1 | 1 | 1 |  | 平歯車 | 5日目 | 3810 | 無 |  |  | 無
購入品 | CGA75 | BFLB4-5 |  | MISUMI | BFLB4-5 | 材料 <指定なし> | 8 | 1 | 8 |  | 無給油ﾌﾞｯｼｭ | 1日目 | 1280 | 無 |  |  | 無
購入品 | CGA75 | B6809ZZ |  | MISUMI | B6809ZZ | 炭素鋼(普通) | 1 | 1 | 1 |  | 玉軸受 | 1日目 | 1040 | 無 |  |  | 無
購入品 | CGA75 | B6700ZZ |  | MISUMI | B6700ZZ | SUJ2 | 1 | 1 | 1 |  | 玉軸受 | 1日目 | 710 | 無 |  |  | 無
購入品 | CGA75 | B676ZZ |  | MISUMI | B676ZZ | 炭素鋼(普通) | 1 | 1 | 1 |  | 玉軸受 | 1日目 | 280 | 無 |  |  | 無
購入品 | CGA75 | B6800ZZ |  | MISUMI | B6800ZZ | 炭素鋼(普通) | 1 | 1 | 1 |  | 玉軸受 | 1日目 | 380 | 無 |  |  | 無
購入品 | CGA75 | B6802ZZ |  | MISUMI | B6802ZZ | 炭素鋼(普通) | 1 | 1 | 1 |  | 玉軸受 | 1日目 | 430 | 無 |  |  | 無
購入品 | CGA75 | CBSTSR4-8 |  | MISUMI | CBSTSR4-8 | SUS304相当 | 1 | 1 | 1 |  | 超極低頭ﾎﾞﾙﾄ | 1日目 | 280 | 無 |  |  | 無
購入品 | CGA75-RS380-4 | PWF3 |  |  | PWF3 | スチール | 7 | 1 | 7 |  | 平座金
購入品 | CGA75-RS380-4 | SLW3 |  |  | SLW3 | スチール | 7 | 1 | 7 |  | ばね座金
購入品 | CGA75-RS380-4 | CB3-30 |  |  | CB3-30 | 材料 <指定なし> | 4 | 1 | 4 |  | 六角穴付きボルト
購入品 | CGA75-RS380-4 | CB3-45 |  |  | CB3-45 | 材料 <指定なし> | 3 | 1 | 3 |  | 六角穴付きボルト

Sheet: Sheet2
種類 | 品番 | 個数
組立品 | CU001 | 1
組立品 | RL001 | 1
組立品 | RR001 | 1
組立品 | CU-SAS001 | 1
組立品 | CU-SAS002 | 1
組立品 | CU-SAS003 | 1
組立品 | CGA75-RS380-4 | 1
組立品 | CU-AAS001 | 1
組立品 | CU-AAS002 | 1
組立品 | CU-AAS003L | 1
組立品 | CU-AAS003R | 1
組立品 | R-SA001 | 2
組立品 | RL-HL001 | 1
組立品 | RL-HL002 | 1
組立品 | RL-HL-RAS001 | 6
組立品 | RR-HL001 | 1
組立品 | RR-HL002 | 1
組立品 | RR-HL-RAS001 | 6
組立品 | R-SA-GAS001 | 2
組立品 | CGA75 | 1
社内加工品 | LS-P003 | 2
社内加工品 | LS-P002 | 2
社内加工品 | LS-P004 | 1
社内加工品 | LS-P005 | 3
社内加工品 | CU-P001 | 1
社内加工品 | CU-P002 | 1
社内加工品 | CU-SAS001-P001 | 1
社内加工品 | CU-SAS001-P002 | 2
社内加工品 | CU-SAS001-P003 | 1
社内加工品 | CU-AAS-P001 | 1
社内加工品 | CU-AAS-P002 | 1
社内加工品 | CU-AAS-P003 | 1
社内加工品 | CU-AAS-P004 | 1
社内加工品 | CU-SAS002-P001 | 1
社内加工品 | CU-SAS002-P002 | 1
社内加工品 | CU-SAS002-P003 | 1
社内加工品 | CU-SAS003-P001 | 1
社内加工品 | CU-SAS003-P002 | 1
社内加工品 | CU-AAS001-P001 | 2
社内加工品 | CU-AAS002-P001 | 2
社内加工品 | CU-AAS002-P002 | 1
社内加工品 | CU-AAS002-P003 | 1
社内加工品 | CU-AAS003-P001 | 2
社内加工品 | CU-AAS003L-P001 | 1
社内加工品 | CU-AAS003R-P001 | 1
社内加工品 | LS001-P001 | 1
社内加工品 | R-P001 | 2
社内加工品 | R-P002 | 2
社内加工品 | R-P003 | 2
社内加工品 | R-P004 | 8
社内加工品 | R-P005 | 2
社内加工品 | RL-P001 | 1
社内加工品 | RL-P002 | 1
社内加工品 | R-HL-P001 | 8
社内加工品 | R-HL-P002 | 4
社内加工品 | R-HL-P003 | 4
社内加工品 | R-HL-P004 | 4
社内加工品 | R-HL-P005 | 4
社内加工品 | R-HL-P006 | 4
社内加工品 | R-HL-P007 | 12
社内加工品 | R-HL-RAS-P001 | 12
社内加工品 | R-HL-RAS-P002 | 12
社内加工品 | R-HL-RAS-P003 | 12
社内加工品 | RR-HL-RAS-P001 | 12
社内加工品 | RR-P001 | 1
社内加工品 | RR-P002 | 1
社内加工品 | R-SA001-P003 | 2
社内加工品 | R-SA001-P001 | 2
社内加工品 | R-SA001-P002 | 2
社内加工品 | CGA75-RS380-4-P001 | 1
社内加工品 | CGA75-RS380-4-P002 | 1
社内加工品 | CGA75-P001 | 1
社内加工品 | CGA75-P002 | 1
社内加工品 | CGA75-P003 | 1
社内加工品 | CGA75-P004 | 1
自社製品 | レシーバ v1 | 1
自社製品 | 右足駆動回路v2 | 1
自社製品 | 左足駆動回路v2 | 1
自社製品 | 電子回路ユニット | 1
自社製品 | 腕駆動回路v2 | 1
購入品 | F3-2100 | 2
購入品 | MBIS2-3-2 | 2
購入品 | CBSTBR2-5 | 10
購入品 | CBSTBR3-10 | 43
購入品 | BRL-2011SBE | 4
購入品 | BRL-311SBE | 1
購入品 | VUY10-55 | 2
購入品 | VUR16-55 | 2
購入品 | 小型ファン | 1
購入品 | CFS0.4 | 1
購入品 | CBSTBR3-6 | 80
購入品 | CBSTSR4-8 | 7
購入品 | DP-C3X20 | 6
購入品 | SS_10GL13 | 2
購入品 | PJLS10-5 | 2
購入品 | CLJW6-8-12.0 | 2
購入品 | YDH3007C05F | 1
購入品 | FWSJW-D8-V6-T6.0 | 10
購入品 | B6805ZZ | 3
購入品 | CBSTBR2-10 | 4
購入品 | SFHRW6-103.0-M3-N3 | 2
購入品 | SFRHH6-109.0-F2.5-P5-T2.5-M3 | 2
購入品 | SFRMGH8-15.0-F2.8-P6-T4.9-M3 | 6
購入品 | ARL-360BE | 2
購入品 | WSJK8-3-2 | 2
購入品 | MPBZ6-15 | 2
購入品 | ABETTF6-75.0-M3-N3 | 2
購入品 | BFLB6-5 | 6
購入品 | DPS-C6X20 | 2
購入品 | ABETTF6-90.0-M3-N3 | 5
購入品 | CL-306E | 2
購入品 | ARL-340BE | 23
購入品 | HTBN474S3M-60 | 2
購入品 | MPFZ10-8 | 4
購入品 | CB2.6-5 | 14
購入品 | RS380-PH | 7
購入品 | SS0.5-10 | 7
購入品 | CLJW6-8-40.0 | 8
購入品 | CLJW6-8-38.0 | 8
購入品 | CLJW6-8-15.5 | 4
購入品 | FWSJW-D8-V6-T5.5 | 6
購入品 | FL678ZZ | 8
購入品 | SFB3-10 | 36
購入品 | B6700ZZ | 13
購入品 | SFB3-5 | 24
購入品 | CBSTBR3-4 | 36
購入品 | WSSB5-3-2 | 12
購入品 | VUR6-20 | 2
購入品 | SCCN6-6 | 2
購入品 | MPBRU6-8 | 2
購入品 | WSSB8-6-1.5 | 2
購入品 | CL-315BE | 4
購入品 | DP-C4x12 | 8
購入品 | GEFHBB0.5-80-5-15-W0-LFC27-M6 | 1
購入品 | BFLB4-5 | 8
購入品 | B6809ZZ | 1
購入品 | B676ZZ | 1
購入品 | B6800ZZ | 1
購入品 | B6802ZZ | 1
購入品 | PWF3 | 7
購入品 | SLW3 | 7
購入品 | CB3-30 | 4
 | CB3-45

Sheet: Sheet3
ABETTF6-75.0-M3-N3 | 円形支柱 | 2
ABETTF6-90.0-M3-N3 | 円形支柱 | 5
ARL-340BE | スペーサー | 23
ARL-360BE | スペーサー | 2
B6700ZZ | 玉軸受 | 13
B676ZZ | 玉軸受 | 1
B6800ZZ | 玉軸受 | 1
B6802ZZ | 玉軸受 | 1
B6805ZZ | 玉軸受 | 3
B6809ZZ | 玉軸受 | 1
BFLB4-5 | 無給油ﾌﾞｯｼｭ | 8
BFLB6-5 | 無給油ﾌﾞｯｼｭ | 6
BRL-2011SBE | スペーサー | 4
BRL-311SBE | スペーサー | 1
CB2.6-5 | 六角穴付ﾎﾞﾙﾄ | 14
CB3-30 | 六角穴付きボルト | 4
CBSTBR2-10 | 超極低頭ﾎﾞﾙﾄ | 4
CBSTBR2-5 | 超極低頭ﾎﾞﾙﾄ | 10
CBSTBR3-10 | 超極低頭ﾎﾞﾙﾄ | 43
CBSTBR3-4 | 超極低頭ﾎﾞﾙﾄ | 36
CBSTBR3-6 | 超極低頭ﾎﾞﾙﾄ | 80
CBSTSR4-8 | 超極低頭ﾎﾞﾙﾄ | 7
CFS0.4 | 定荷重ばね | 1
CL-306E | スペーサー | 2
CL-315BE | ｽﾍﾟｰｻｰ | 4
CLJW6-8-12.0 | 樹脂ｶﾗｰ | 2
CLJW6-8-15.5 | 樹脂ｶﾗｰ | 4
CLJW6-8-38.0 | 樹脂ｶﾗｰ | 8
CLJW6-8-40.0 | 樹脂ｶﾗｰ | 8
DP-C3X20 | ダウエルピン | 6
DP-C4x12 | ダウエルピン | 8
DPS-C6X20 | ダウエルピン | 2
F3-2100 | バッテリー | 2
FL678ZZ | 玉軸受 | 8
FWSJW-D8-V6-T5.5 | 樹脂ﾜｯｼｬ | 6
FWSJW-D8-V6-T6.0 | 樹脂ﾜｯｼｬ | 10
GEFHBB0.5-80-5-15-W0-LFC27-M6 | 平歯車 | 1
HTBN474S3M-60 | タイミングベルト | 2
MBIS2-3-2 | ﾈｼﾞｲﾝｻｰﾄ | 2
MPBRU6-8 | 無給油ﾌﾞｯｼｭ | 2
MPBZ6-15 | 無給油ﾌﾞｯｼｭ | 2
MPFZ10-8 | 無給油ﾌﾞｯｼｭ | 4
PJLS10-5 | プランジャ | 2
PWF3 | 平座金 | 7
RS380-PH | 電動機 | 7
SCCN6-6 | ｾｯﾄｶﾗｰ | 2
SFB3-10 | 皿ねじ | 36
SFB3-5 | 皿ねじ | 24
SFHRW6-103.0-M3-N3 | 回転軸 | 2
SFRHH6-109.0-F2.5-P5-T2.5-M3 | 回転軸 | 2
SFRMGH8-15.0-F2.8-P6-T4.9-M3 | 回転軸 | 6
SLW3 | ばね座金 | 7
SS_10GL13 | スイッチ | 2
SS0.5-10 | 平歯車 | 7
VUR16-55 | 丸線ｺｲﾙｽﾌﾟﾘﾝｸﾞ | 2
VUR6-20 | 丸線ｺｲﾙｽﾌﾟﾘﾝｸﾞ | 2
VUY10-55 | 丸線ｺｲﾙｽﾌﾟﾘﾝｸﾞ | 2
WSJK8-3-2 | 樹脂ﾜｯｼｬ | 2
WSSB5-3-2 | 金属ﾜｯｼｬ | 12
WSSB8-6-1.5 | 金属ﾜｯｼｬ | 2
YDH3007C05F | 小型ファン | 1
小型ファン | 小型ファン | 1
電子回路ユニット | 0 | 1
腕駆動回路v2 | 0 | 1

Sheet: Sheet4
品番 | 部品名 | 個数 | 材質 | 材料型式 | 主材 | CAM | 材料発注 | 加工
CGA75-P001 | 内接歯車機構躯体 | 1 | A2017 |  | φ75 t19 | CAM_CGA75-P001
CGA75-P002 | 出力板 | 1 | A2017 |  | φ45 t7 | CAM_T8_1
CGA75-P003 | 内歯車 | 1 | A2017 |  | φ27.5 t5 | CAM_T5_1
CGA75-P004 | 曲軸(歯車付き) | 1 | S45C
CGA75-RS380-4-P001 | 腕電動機取付板 | 1 | A2017 |  | 60x60xt2 | CAM_T2_1
CGA75-RS380-4-P002 | 腕機構回路放熱板 | 1 | A2017 |  | 16x40xt8 | CAM_T8_1
CU-AAS001-P001 | 中関節 | 2 | A2017 |  | t5 | CAM_T5_1
CU-AAS002-P001 | 従動節根本軸 | 2 | A2017 |  | φ27.5 t10 | CAM_CU-AAS002-P001
CU-AAS002-P002 | 駆動節歯車付き | 1 | A2017 |  | 110x50xt7 | CAM_T8_1
CU-AAS002-P003 | 駆動節 | 1 | A2017 |  | 110x50xt7 | CAM_T8_1
CU-AAS003L-P001 | 従動節左 | 1 | A2017 |  | 110x50xt7 | CAM_T8_1
CU-AAS003-P001 | ロッド先端 | 2 | A2017 |  | t3 | CAM_T3_1
CU-AAS003R-P001 | 従動節右 | 1 | A2017 |  | 110x50xt7 | CAM_T8_1
CU-AAS-P001 | カウンターアーム | 1 | A2017 |  | t5 | CAM_T5_1
CU-AAS-P002 | ﾐﾗｰカウンターアーム | 1 | A2017 |  | t5 | CAM_T5_1
CU-AAS-P003 | 腕機構カバー | 1 | AR-M2 |  |  | AGILISTA
CU-AAS-P004 | ﾐﾗｰ腕機構カバー | 1 | AR-M2 |  |  | AGILISTA
CU-P001 | 中央ユニット後方カバー | 1 | AR-M2 |  |  | AGILISTA
CU-P002 | 足駆動回路放熱板 | 1 | A2017 |  | t8 | CAM_T8_1
CU-SAS001-P001 | 中央フレーム | 1 | A2017 | A2017P-KQ3-240-170-3 | t3 | CAM_T3_2
CU-SAS001-P002 | 横展開抜止め | 2 | A2017 |  | t5 | CAM_T5_1
CU-SAS001-P003 | 中央ユニット主軸 | 1 | A2017 |  |  | 手加工
CU-SAS002-P001 | 最集段ピニオン | 1 | A2017 | A2017-BP-50-100 | φ48 t17 | CAM_CU-SAS002-P001
CU-SAS002-P002 | 腕機構内壁 | 1 | A2017 |  | t8 | CAM_T8_1
CU-SAS002-P003 | 腕機構内壁 | 1 | A2017 |  | t8 | CAM_T8_1
CU-SAS003-P001 | 抑制鍵 | 1 | AR-M2 |  |  | AGILISTA
CU-SAS003-P002 | 展開機構ブロック | 1 | AR-M2 |  |  | AGILISTA
LS001-P001 | リンクサス足側軸部 | 1 | AR-M2 |  |  | AGILISTA
LS-P002 | リンクサス長辺 | 2 | AR-M2 |  |  | AGILISTA
LS-P003 | リンクサス短辺 | 2 | AR-M2 |  |  | AGILISTA
LS-P004 | リンクサス中央軸部 | 1 | AR-M2 |  |  | AGILISTA
LS-P005 | リンクサス節軸 | 3 | AR-M2 |  |  | AGILISTA
R-HL-P001 | 足曲軸長偏心体 | 8 | A2017 |  | t10 | CAM_T12_1
R-HL-P002 | 足曲軸短偏心体 | 4 | A2017 |  | t12 | CAM_T12_1
R-HL-P003 | 足プーリー中心軸 | 4 | A2017 |  |  | 手加工
R-HL-P004 | 足機構曲軸結合部 | 4 | A2017 |  | t3 | CAM_T3_2
R-HL-P005 | ヘッケンリンク駆動プーリー | 4 | AR-M2 |  |  | AGILISTA
R-HL-P006 | 足プーリーフランジ | 4 | A2017 | A2017P-KQ3-240-170-3 | t3 | CAM_T3_2
R-HL-P007 | 足レバー | 12 | A2017 |  | t2 | CAM_T2_1
R-HL-RAS-P001 | 足上部 | 12 | A2017 |  | t2 | CAM_T2_1
R-HL-RAS-P002 | 足下部 | 12 | A2017 |  | t2 | CAM_T2_1
R-HL-RAS-P003 | 足ゴム | 12 | AR-M2 |  |  | AGILISTA
RL-P001 | 足側板左外側 | 1 | A2017 | A5052P-KQ2-350-200-2 | 340x130xt2 | CAM_T2_2
RL-P002 | 左足機構側面充填樹脂 | 1 | AR-M2 |  |  | AGILISTA
R-P001 | 足側板内側 | 2 | A2017 | A5052P-KQ2-350-200-2 | 340x130xt2 | CAM_T2_3
R-P002 | 足機構固定板 | 2 | A2017 |  |  | CAM_T2_1
R-P003 | 足機構上面カバー | 2 | AR-M2 |  |  | AGILISTA
R-P004 | 足機構主柱 | 8 | A2017 |  |  | 手加工
R-P005 | カウンターアームロック | 2 | AR-M2 |  |  | AGILISTA
RR-HL-RAS-P001 | 前足底左半身側 | 12 | AR-M2 |  |  | AGILISTA
RR-P001 | 足側板右外側 | 1 | A2017 | A5052P-KQ2-350-200-2 | 340x130xt2 | CAM_T2_2
RR-P002 | 右足機構側面充填樹脂 | 1 | ｴﾎﾟｷｼ樹脂(充填剤なし) |  |  | AGILISTA
R-SA001-P001 | 足中間歯車1A | 2 | A2017 |  |  | CAM_T5_1
R-SA001-P002 | 足中間歯車1B | 2 | A2017 |  |  | CAM_T5_1
R-SA001-P003 | 足中間歯車2 | 2 | A2017 | A2017P-KQ3-240-170-3 | t3 | CAM_T3_2
レシーバ v1 | レシーバ v1 | 1 | 0
右足駆動回路v2 | 右足駆動回路v2 | 1 | 0
左足駆動回路v2 | 左足駆動回路v2 | 1 | 0

Sheet: Sheet5
CAM_CGA75-P001 | A2017-BP-80-25 | A2017-BP-46-20 | 1
CAM_CU-AAS002-P001 | A2017-BP-46-20 | A2017P-KQ12-150-100-12 | 1
CAM_CU-SAS002-P001 | A2017-BP-50-100 | A2017P-KQ5-300-180-5 | 1
CAM_T2_1 | A5052P-KQ2-200-200-2 | A2017P-KQ8-400-200-8 | 1
CAM_T2_2 | A5052P-KQ2-350-200-2 | A5052P-KQ2-200-200-2 | 1
CAM_T2_3 | A5052P-KQ2-350-200-2 | A5052P-KQ2-350-200-2 | 2
CAM_T3_2 | A2017P-KQ3-240-170-3 | A2017-BP-50-100 | 1
CAM_T5_1 | A2017P-KQ5-300-180-5 | A2017-BP-80-25 | 1
CAM_T8_1 | A2017P-KQ8-400-200-8 | A2017P-KQ3-240-170-3 | 1
CAM_T12_1 | A2017P-KQ12-150-100-12
