KatsukiOishi/HikkiKomori/機械設計/_BOM/CGA75-RS380-4.xlsx

種類 | 部分 | 品番 | 手配先 | メーカー | 部品名 | 材料 | 個数 | 個数 | 記 事 | 分類 | 出荷日 | 単価 | 表面処理 | 表面処理法 | 表面処理法補足 | 熱処理 | 熱処理法 | 硬度
社内加工品 | CGA75-RS380 | CGA75-RS380-4-P001 |  |  | 腕電動機取付板 | A2017 | 1 | 1 |  |  |  |  | 無 | - | - | 無 | - | -
社内加工品 | CGA75-RS380-4 | CGA75-RS380-4-P002 |  |  | 腕機構回路放熱板 | A2017 | 1 | 1 |  |  |  |  | 無 | - | - | 無 | - | -
組立品 | CGA75-RS380-4 | CGA75 |  |  | 内接減速機構 | 材料 <指定なし> | 1 | 1 |  |  |  |  | 無 |  |  | 無
自社製品 |  |  |  |  | 腕駆動回路v2 | 電力回路基板 | 1 |  |  |  |  |  | 無 | - | - | 無 | - | -
購入品 |  |  | 廣杉計器 | 廣杉計器 | ARL-340BE | KS26 | 3 |  |  | スペーサー |  |  | 有 | アルマイト | 黒 | 無 | - | -
購入品 |  |  |  | MISUMI | CB2.6-5 | SCM435 | 6 |  |  | 六角穴付ﾎﾞﾙﾄ | 1日目 | 642 | 無 |  |  | 無
購入品 |  |  | Amazon | マブチ | RS380-PH | 材料 <指定なし> | 3 |  | 馬渕モータ RS380PH | 電動機 |  |  | 無 |  |  | 無
購入品 |  |  | KHK | KHK | SS0.5-10 | S45C | 3 |  |  | 平歯車 |  | 150 | 無 | - | - | 無 | - | -
購入品 |  |  | 廣杉計器 | 廣杉計器 | CL-315BE | KS26 | 4 |  |  | ｽﾍﾟｰｻｰ |  | 46 | 有 | アルマイト | 黒 | 無 | - | -
ボルト類 |  |  |  |  | 六角穴付きボルト M3x30 | 材料 <指定なし> | 4
ボルト類 |  |  |  |  | 六角穴付きボルト M3x45(ネジ部20) | 材料 <指定なし> | 3
ワッシャ類 |  |  |  |  | 平座金 M3 | スチール | 7
ワッシャ類 |  |  |  |  | ばね座金 M3 | スチール | 7
