KatsukiOishi/HikkiKomori/機械設計/_BOM/CU-AAS001.xlsx

種類 | 部分 | 品番 | 手配先 | メーカー | 部品名 | 材料 | 個数 | 個数 | 記 事 | 分類 | 出荷日 | 単価 | 表面処理 | 表面処理法 | 表面処理法補足 | 熱処理 | 熱処理法 | 硬度
社内加工品 | CU-AAS001 | CU-AAS001-P001 |  |  | 中関節 | A2017 | 2 | 2 |  |  |  |  | 無 |  |  | 無
購入品 |  |  | MISUMI | MISUMI | ABETTF6-75.0-M3-N3 | A2017-T4 | 2 |  |  | 円形支柱 | 5日目 | 710 | 無 |  |  | 無
購入品 |  |  |  | MISUMI | CBSTBR3-10 | SCM435 | 4 |  |  | 超極低頭ﾎﾞﾙﾄ | 1日目 | 280 | 無 |  |  | 無
購入品 |  |  |  | MISUMI | BFLB6-5 | A2017 | 4 |  |  | 無給油ﾌﾞｯｼｭ | 1日目 | 1190 | 無 |  |  | 無
