KatsukiOishi/HikkiKomori/機械設計/_BOM/CU-AAS003L.xlsx

種類 | 部分 | 品番 | 手配先 | メーカー | 部品名 | 材料 | 個数 | 個数 | 記 事 | 分類 | 出荷日 | 単価 | 表面処理 | 表面処理法 | 表面処理法補足 | 熱処理 | 熱処理法 | 硬度
社内加工品 | CU-AAS003L/R | CU-AAS003-P001 |  |  | ロッド先端 | A2017 | 1 | 1 |  |  |  |  | 無 | - | - | 無 | - | -
社内加工品 | CU-AAS003L | CU-AAS003L-P001 |  |  | 従動節左 | A2017 | 1 | 1 |  |  |  |  | 無 | - | - | 無 | - | -
購入品 |  |  | 廣杉計器 | 廣杉計器 | CL-306E | KS26 | 1 |  |  | スペーサー |  |  | 無 | - | - | 無 | - | -
購入品 |  |  |  | MISUMI | CBSTBR3-10 | SCM435 | 1 |  |  | 超極低頭ﾎﾞﾙﾄ | 1日目 | 280 | 無 |  |  | 無
