KatsukiOishi/HikkiKomori/機械設計/_BOM/CU-SAS001.xlsx

種類 | 部分 | 品番 | 手配先 | メーカー | 部品名 | 材料 | 個数 | 個数 | 記 事 | 分類 | 出荷日 | 単価 | 表面処理 | 表面処理法 | 表面処理法補足 | 熱処理 | 熱処理法 | 硬度
社内加工品 | CU | CU-P002 |  |  | 足駆動回路放熱板 | A2017 | 1 | 1 |  |  |  |  | 無 | - | - | 無 | - | -
社内加工品 | CU-SAS001 | CU-SAS001-P001 |  |  | 中央フレーム | A2017 | 1 | 1 |  |  |  |  | 無 |  |  | 無
社内加工品 | CU-SAS001 | CU-SAS001-P002 |  |  | 横展開抜止め | A2017 | 2 | 2 |  |  |  |  | 無 |  |  | 無
社内加工品 | CU-SAS001 | CU-SAS001-P003 |  |  | 中央ユニット主軸 | A2017 | 1 | 1 |  |  |  |  | 無 |  |  | 無
自社製品 |  |  |  |  | 右足駆動回路v2 | 未指定 | 1 | 1 |  |  |  |  | 無 | - | - | 無 | - | -
自社製品 |  |  |  |  | 左足駆動回路v2 | 未指定 | 1 | 1 |  |  |  |  | 無 | - | - | 無 | - | -
自社製品 |  |  |  |  | 電子回路ユニット | 材料 <指定なし> | 1 |  | 組立品(組図を参照) |  |  |  | 無 |  |  | 無
購入品 |  |  | 廣杉計器 | 廣杉計器 | BRL-2011SBE | A2017 | 4 |  |  | スペーサー |  |  | 無 | - | - | 無 | - | -
購入品 |  |  | 廣杉計器 | 廣杉計器 | BRL-311SBE | A2017 | 1 |  |  | スペーサー |  |  | 無 | - | - | 無 | - | -
購入品 |  |  |  | MISUMI | VUY10-55 | SUS304-WPB | 2 |  |  | 丸線ｺｲﾙｽﾌﾟﾘﾝｸﾞ | 1日目 | 899 | 無 |  |  | 無
購入品 |  |  |  | MISUMI | VUR16-55 | SUS304-WPB | 2 | 2 |  | 丸線ｺｲﾙｽﾌﾟﾘﾝｸﾞ | 1日目 | 535 | 無 |  |  | 無
購入品 |  |  | Amazon | Amazon | 小型ファン | ABS | 1 |  |  | 小型ファン |  |  | 無 | - | - | 無 | - | -
購入品 |  |  |  | MISUMI | CFS0.4 | 材料 <指定なし> | 1 |  |  | 定荷重ばね | 1日目 | 1880 | 無 |  |  | 無
購入品 |  |  |  | MISUMI | CBSTBR3-6 | SCM435 | 6 |  |  | 超極低頭ﾎﾞﾙﾄ | 1日目 | 280 | 無 |  |  | 無
購入品 |  |  |  | MISUMI | CBSTBR2-5 | SCM435 | 8 |  |  | 超極低頭ﾎﾞﾙﾄ | 1日目 | 260 | 無 |  |  | 無
購入品 |  |  |  | MISUMI | CBSTBR3-10 | SCM435 | 2 |  |  | 超極低頭ﾎﾞﾙﾄ | 1日目 | 280 | 無 |  |  | 無
購入品 |  |  |  | MISUMI | CBSTSR4-8 | SUS304相当 | 2 |  |  | 超極低頭ﾎﾞﾙﾄ | 1日目 | 280 | 無 |  |  | 無
組立品 | CU001 | CU-SAS003 |  |  | 展開機構 | 材料 <指定なし> | 1 | 1 | 組立品(組図を参照) |  |  |  | 無 |  |  | 無
