KatsukiOishi/HikkiKomori/機械設計/_BOM/CU-SAS002.xlsx

種類 | 部分 | 品番 | 手配先 | メーカー | 部品名 | 材料 | 個数 | 個数 | 記 事 | 分類 | 出荷日 | 単価 | 表面処理 | 表面処理法 | 表面処理法補足 | 熱処理 | 熱処理法 | 硬度
社内加工品 | CU-AAS | CU-AAS-P001 |  |  | カウンターアーム | A2017 | 2 | 2 |  |  |  |  | 無 | - | - | 無 | - | -
社内加工品 | CU-AAS | CU-AAS-P002 |  |  | ﾐﾗｰカウンターアーム | A2017 | 1 | 1 |  |  |  |  | 無 | - | - | 無 | - | -
社内加工品 | CU-AAS | CU-AAS-P003 |  |  | 腕機構カバー | AR-M2 | 1 | 1 |  |  |  |  | 無 | - | - | 無 | - | -
社内加工品 | CU-AAS | CU-AAS-P004 |  |  | ﾐﾗｰ腕機構カバー | AR-M2 | 1 | 1 |  |  |  |  | 無 | - | - | 無 | - | -
社内加工品 | CU-SAS002 | CU-SAS002-P001 |  |  | 最集段ピニオン | A2017 | 1 | 1 |  |  |  |  | 無 | - | - | 無 | - | -
社内加工品 | CU-SAS002 | CU-SAS002-P002 |  |  | 腕機構内壁 | A2017 | 1 | 1 |  |  |  |  | 無 | - | - | 無 | - | -
社内加工品 | CU-SAS002 | CU-SAS002-P003 |  |  | 腕機構内壁 | A2017 | 1 | 1 |  |  |  |  | 無 | - | - | 無 | - | -
購入品 |  |  | MISUMI | 大喜多 | DP-A3X20 |  | 6 |  | ダウエルピン 大喜多A種 (φ3 x 20)
購入品 |  |  | 秋月電子 | 秋月電子 | SS_10GL13 | 材料 <指定なし> | 2 |  |  | スイッチ |  |  | 無 |  |  | 無
購入品 |  |  | MISUMI | MISUMI | PJLS10-5 | S45C | 2 |  | PART--DESC | プランジャ |  |  | 無 | - | - | 無 | - | -
購入品 |  |  |  | MISUMI | CLJW6-8-12.0 | MCナイロン | 2 |  |  | 樹脂ｶﾗｰ | 2日目 | 260 | 無 |  |  | 無
購入品 |  |  | 秋月電子 | 秋月電子 | YDH3007C05F | 未指定 | 1 |  |  | 小型ファン |  |  | 無 | - | - | 無 | - | -
購入品 |  |  |  | MISUMI | FWSJW-D8-V6-T6.0 | MCナイロン | 2 |  |  | 樹脂ﾜｯｼｬ | 2日目 | 330 | 無 |  |  | 無
購入品 |  |  |  | MISUMI | B6805ZZ | SUJ2 | 3 |  |  | 玉軸受 | 1日目 | 510 | 無 |  |  | 無
購入品 |  |  |  | MISUMI | CBSTBR3-10 | SCM435 | 4 |  |  | 超極低頭ﾎﾞﾙﾄ | 1日目 | 280 | 無 |  |  | 無
購入品 |  |  |  | MISUMI | CBSTBR3-6 | SCM435 | 10 |  |  | 超極低頭ﾎﾞﾙﾄ | 1日目 | 280 | 無 |  |  | 無
購入品 |  |  |  | MISUMI | CBSTBR2-10 | SCM435 | 4 |  |  | 超極低頭ﾎﾞﾙﾄ | 1日目 | 260 | 無 |  |  | 無
購入品 | CU-AAS |  |  |  | SFHRW6-103.0-M3-N3 | 材料 <指定なし> | 2 | 2 |  |  |  |  | 無 |  |  | 無
購入品 | CU-AAS |  |  |  | SFRHH6-109.0-F2.5-P5-T2.5-M3 | 材料 <指定なし> | 2 | 2 |  |  |  |  | 無 |  |  | 無
購入品 |  |  |  | MISUMI | SFRMGH8-15.0-F2.8-P6-T4.9-M3 | 材料 <指定なし> | 6 | 4 |  | 回転軸 | 2日目 | 580 | 無 |  |  | 無
組立品 |  |  |  |  | 腕機構減速機 | 材料 <指定なし> | 1 | 1 |  |  |  |  | 無 |  |  | 無
組立品 |  |  |  |  | アームリンク中関節 | 材料 <指定なし> | 1 | 1 | 組立品(組図を参照) |  |  |  | 無 |  |  | 無
組立品 |  |  |  |  | アームリンク駆動節 | 材料 <指定なし> | 1 | 1 |  |  |  |  | 無 |  |  | 無
組立品 |  |  |  |  | ロングロッド左 | 材料 <指定なし> | 1 | 1 | 組立品(組図を参照) |  |  |  | 無 |  |  | 無
組立品 |  |  |  |  | ロングロッド右 | 材料 <指定なし> | 1 | 1 | 組立品(組図を参照) |  |  |  | 無 |  |  | 無
ボルト類 |  |  |  |  | 六角穴付きボルト M3x5 | スチール | 2
