KatsukiOishi/HikkiKomori/機械設計/_BOM/CU001.xlsx

種類 | 部分 | 品番 | 手配先 | メーカー | 部品名 | 材料 | 個数 | 個数 | 記 事 | 分類 | 出荷日 | 単価 | 表面処理 | 表面処理法 | 表面処理法補足 | 熱処理 | 熱処理法 | 硬度
社内加工品 | CU | CU-P001 |  |  | 中央ユニット後方カバー | AR-M2 | 1 | 1 |  |  |  |  | 無 | - | - | 無 | - | -
組立品 | CU001 | CU-SAS001 |  |  | 中央躯体 | 材料 <指定なし> | 1 | 1 | 組立品(組図を参照) |  |  |  | 無 |  |  | 無
組立品 | CU001 | CU-SAS002 |  |  | 腕機構 | 材料 <指定なし> | 1 | 1 | 組立品(組図を参照) |  |  |  | 無 |  |  | 無
自社製品 |  |  |  |  | レシーバ v1 | 未指定 | 1 |  |  |  |  |  | 無 | - | - | 無 | - | -
購入品 |  |  | 近藤科学 | 近藤科学 | F3-2100 | 材料 <指定なし> | 2 |  |  | バッテリー |  |  | 無 |  |  | 無
購入品 |  |  |  | MISUMI | MBIS2-3-2 | 黄銅 | 2 |  |  | ﾈｼﾞｲﾝｻｰﾄ | 1日目 | 64 | 無 |  |  | 無
購入品 |  |  |  | MISUMI | CBSTBR2-5 | SCM435 | 2 |  |  | 超極低頭ﾎﾞﾙﾄ | 1日目 | 260 | 無 |  |  | 無
購入品 |  |  |  | MISUMI | CBSTBR3-10 | SCM435 | 5 |  |  | 超極低頭ﾎﾞﾙﾄ | 1日目 | 280 | 無 |  |  | 無
