KatsukiOishi/HikkiKomori/機械設計/_BOM/R-SA-GAS001.xlsx

種類 | 部分 | 品番 | 手配先 | メーカー | 部品名 | 材料 | 個数 | 個数 | 記 事 | 分類 | 出荷日 | 単価 | 表面処理 | 表面処理法 | 表面処理法補足 | 熱処理 | 熱処理法 | 硬度
社内加工品 | R-SA001 | R-SA001-P001 |  |  | 足中間歯車1A | A2017 | 1 | 1 |  |  |  |  | 無 | - | - | 無 | - | -
社内加工品 | R-SA001 | R-SA001-P002 |  |  | 足中間歯車1B | A2017 | 1 | 1 |  |  |  |  | 無 | - | - | 無 | - | -
