KatsukiOishi/HikkiKomori/機械設計/00既製品/GEFHBB0.5-80-5-15-W0-LFC27-M6/GEFHBB0.5-80-5-15-W0-LFC27-M6.SLDASM

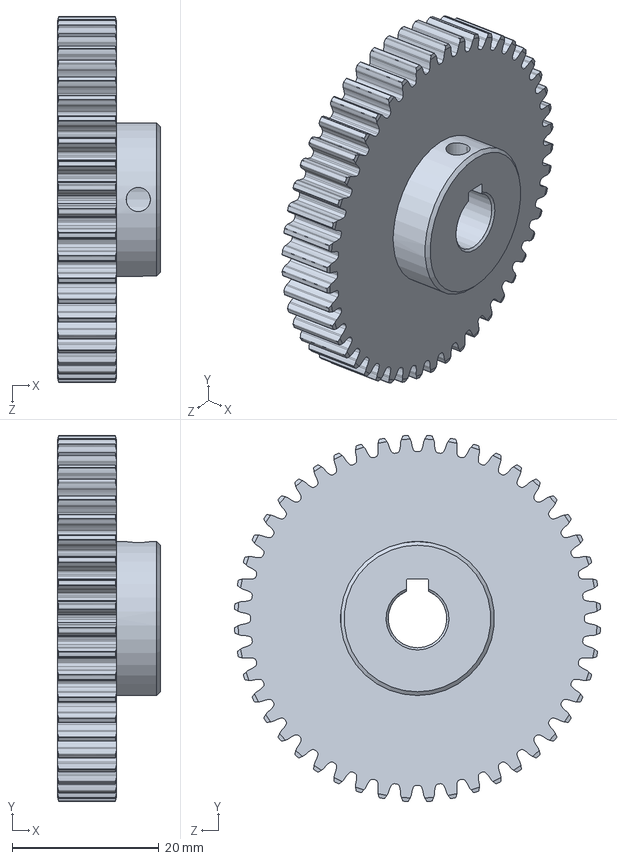
[picture p11: CAD file, 2025-05-29]
機械設計/00既製品/GEFHBB0.5-80-5-15-W0-LFC27-M6/GEFHBB0.5-80-5-15-W0-LFC27-M6.SLDASM
14.0 x 49.9 x 49.9 mm
