KatsukiOishi/HikkiKomori/機械設計/00既製品/RS380/RS380.SLDASM

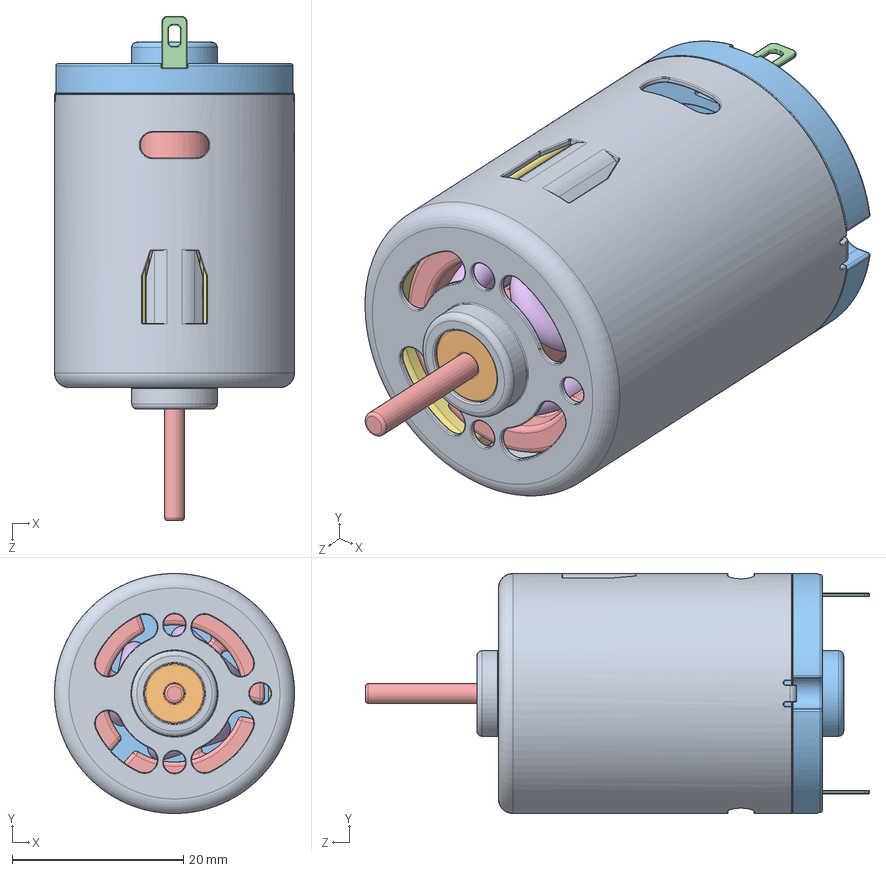
[picture p12: CAD file, 2025-05-29]
機械設計/00既製品/RS380/RS380.SLDASM
28.0 x 28.0 x 58.8 mm
ケース
Bucha12V
Mancal12V
Terminal12V x 2
Eixo12V
Enrolamento12V x 3
磁石 x 2
