KatsukiOishi/HikkiKomori/機械設計/00既製品/SFHRW6-103.0-M3-N3/SFHRW6-103.0-M3-N3.SLDASM

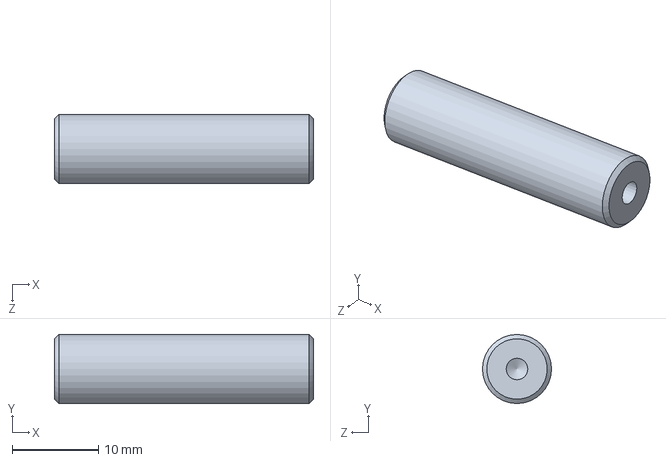
[picture p13: CAD file, 2025-05-29]
機械設計/00既製品/SFHRW6-103.0-M3-N3/SFHRW6-103.0-M3-N3.SLDASM
30.0 x 8.00 x 8.00 mm
