KatsukiOishi/HikkiKomori/機械設計/00既製品/SFRHH6-109.0-F2.5-P5-T2.5-M3/SFRHH6-109.0-F2.5-P5-T2.5-M3.SLDASM

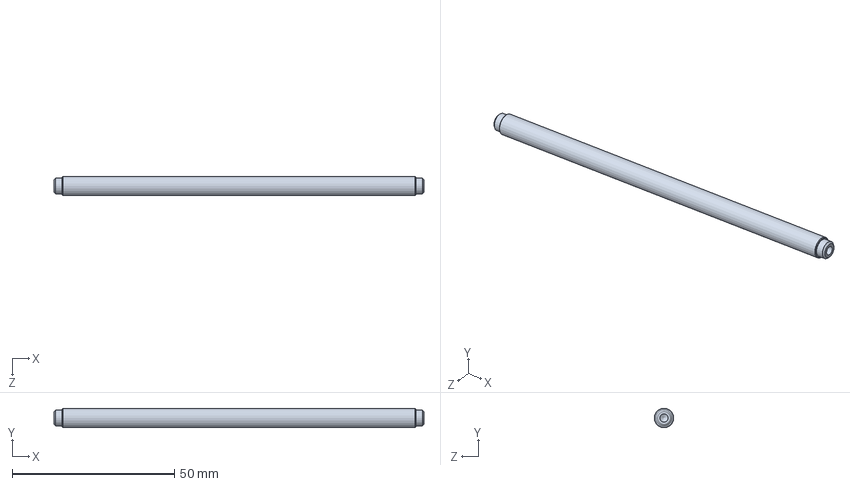
[picture p14: CAD file, 2025-05-29]
機械設計/00既製品/SFRHH6-109.0-F2.5-P5-T2.5-M3/SFRHH6-109.0-F2.5-P5-T2.5-M3.SLDASM
114.0 x 6.00 x 6.00 mm
