KatsukiOishi/HikkiKomori/機械設計/00既製品/SFRMGH8-15.0-F2.8-P6-T4.9-M3/SFRMGH8-15.0-F2.8-P6-T4.9-M3.SLDASM

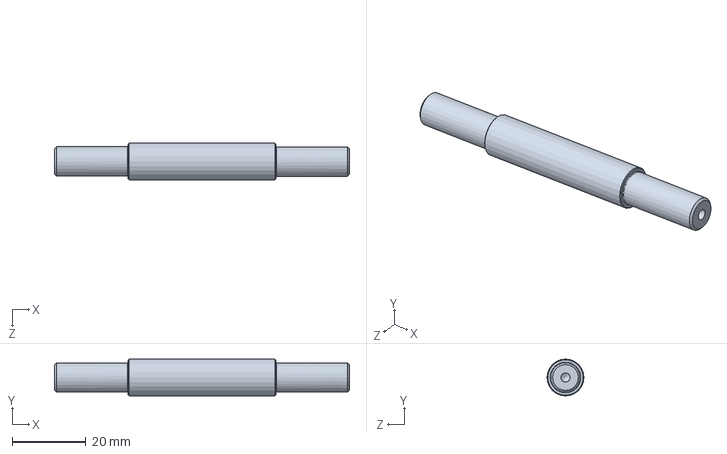
[picture p15: CAD file, 2025-05-29]
機械設計/00既製品/SFRMGH8-15.0-F2.8-P6-T4.9-M3/SFRMGH8-15.0-F2.8-P6-T4.9-M3.SLDASM
80.0 x 10.0 x 10.0 mm
