KatsukiOishi/HikkiKomori/機械設計/00既製品/SS-10GL13/SS_10GL13.SLDASM

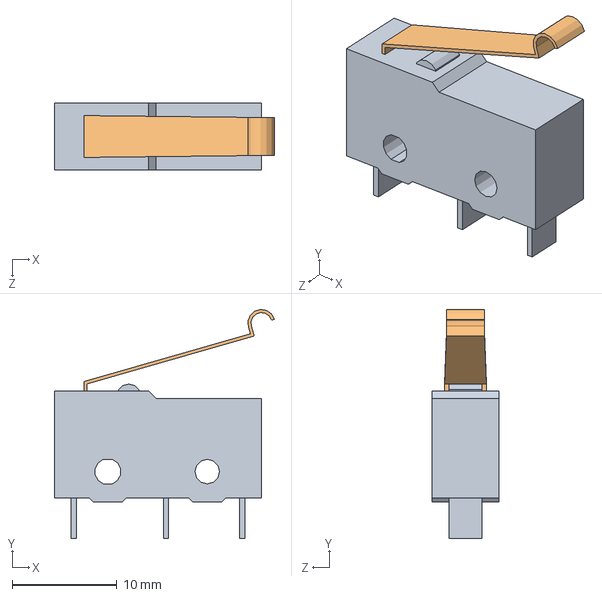
[picture p16: CAD file, 2025-05-29]
機械設計/00既製品/SS-10GL13/SS_10GL13.SLDASM
21.0 x 21.9 x 6.40 mm
SS_10GL13_BASE
SS_10GL13_ACTUATOR
