KatsukiOishi/HikkiKomori/電子回路設計/3D化/足駆動回路v2/右足駆動回路v2.SLDASM

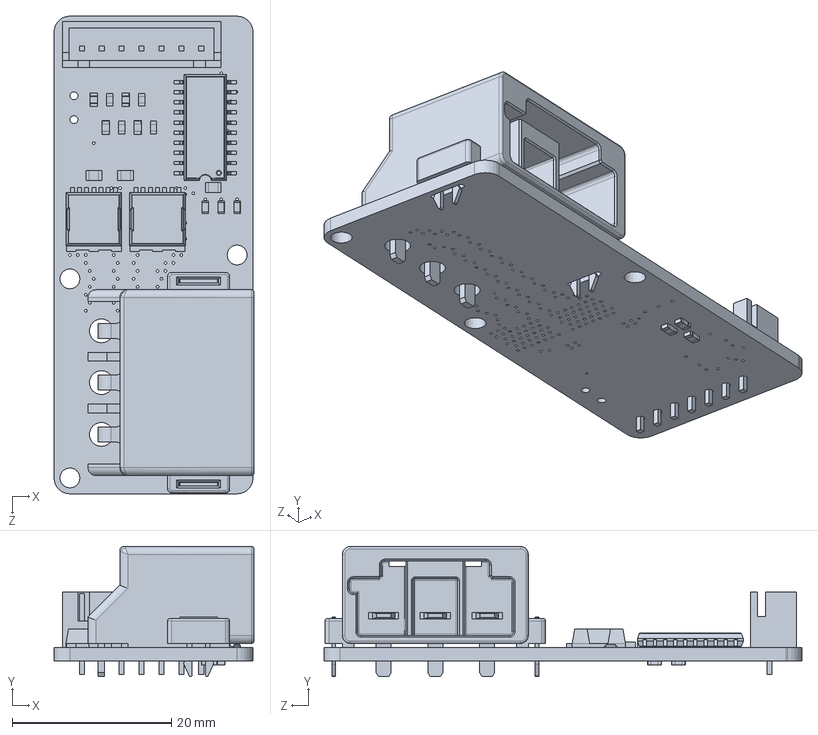
[picture p17: CAD file, 2022-06-14]
電子回路設計/3D化/足駆動回路v2/右足駆動回路v2.SLDASM
25.1 x 16.3 x 60.0 mm
