KatsukiOishi/HikkiKomori/機械設計/00既製品/CFS0.4/CFS0.4.SLDASM

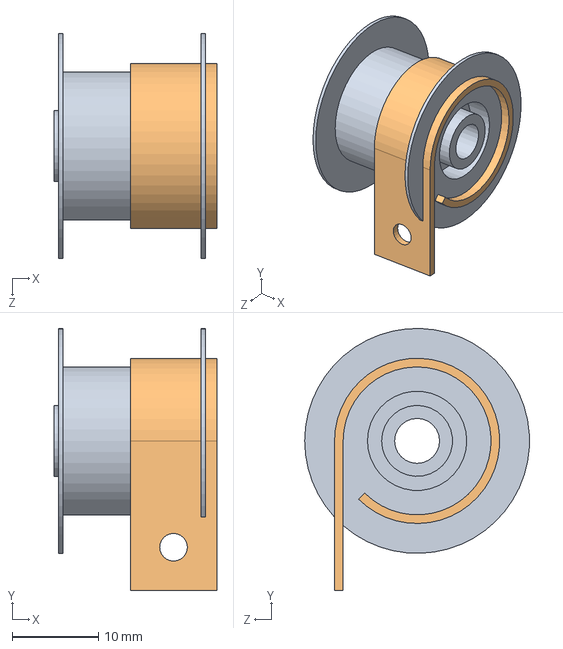
[picture p18: CAD file, 2025-05-29]
機械設計/00既製品/CFS0.4/CFS0.4.SLDASM
18.8 x 30.3 x 26.0 mm
MAIN BODY_CFS0.4
DRUM_CFS0.4
