KatsukiOishi/HikkiKomori/電子回路設計/3D化/足駆動回路v2/足駆動回路 v2.SLDASM

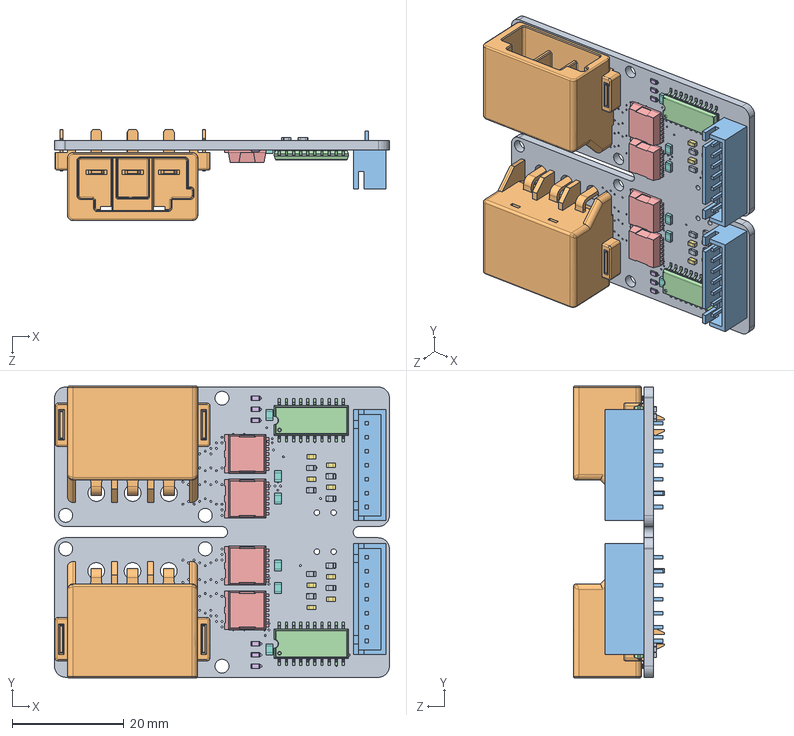
[picture p19: CAD file, 2022-06-14]
電子回路設計/3D化/足駆動回路v2/足駆動回路 v2.SLDASM
60.0 x 52.3 x 16.3 mm
Board
798-HVH-280-3P-6.5DS x 2
B7B-XH-A x 2
SOP20 x 2
BTN9990LV x 4
LEDC1608X39N_G x 6
C0603 x 8
C0805 x 6
R0603 x 14
