KatsukiOishi/HikkiKomori/機械設計/00既製品/CFS0.4/MAIN BODY_CFS0.4.SLDPRT

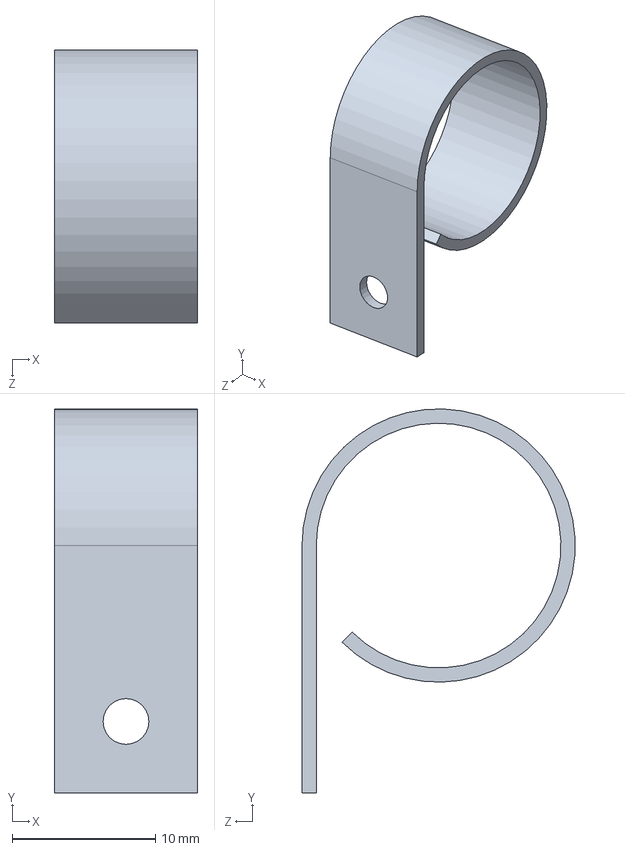
[picture p20: CAD file, 2025-05-29]
機械設計/00既製品/CFS0.4/MAIN BODY_CFS0.4.SLDPRT
10.0 x 26.8 x 19.1 mm
