KatsukiOishi/HikkiKomori/電子回路設計/3D化/レシーバv1/レシーバ v1.SLDASM

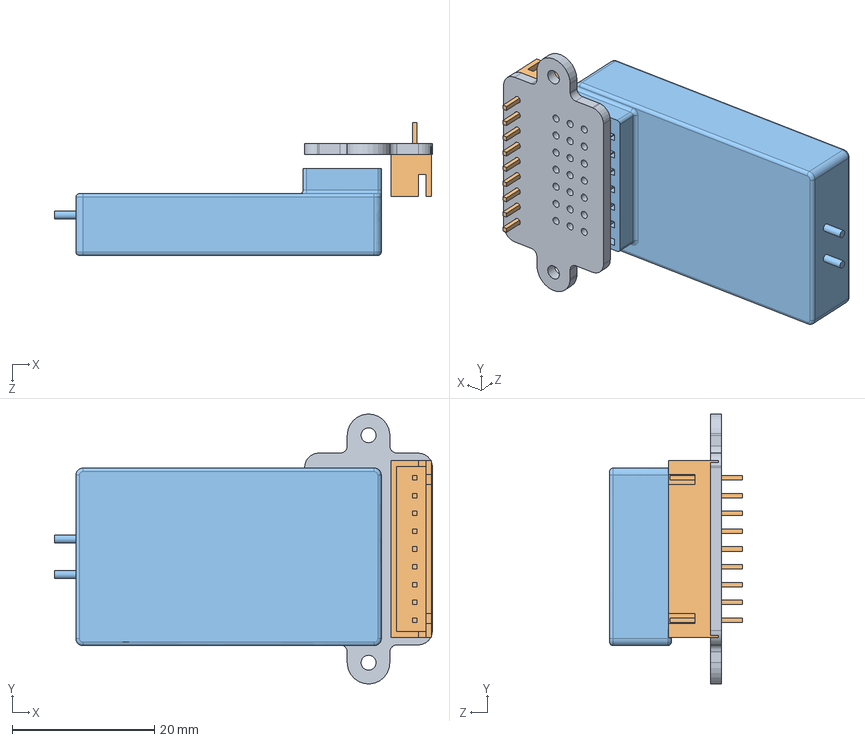
[picture p21: CAD file, 2023-07-12]
電子回路設計/3D化/レシーバv1/レシーバ v1.SLDASM
53.2 x 38.0 x 18.7 mm
Board
B9B-XH-A
R3006B
