KatsukiOishi/HikkiKomori/電子回路設計/3D化/電源基盤v1/電源基盤 v1.SLDASM

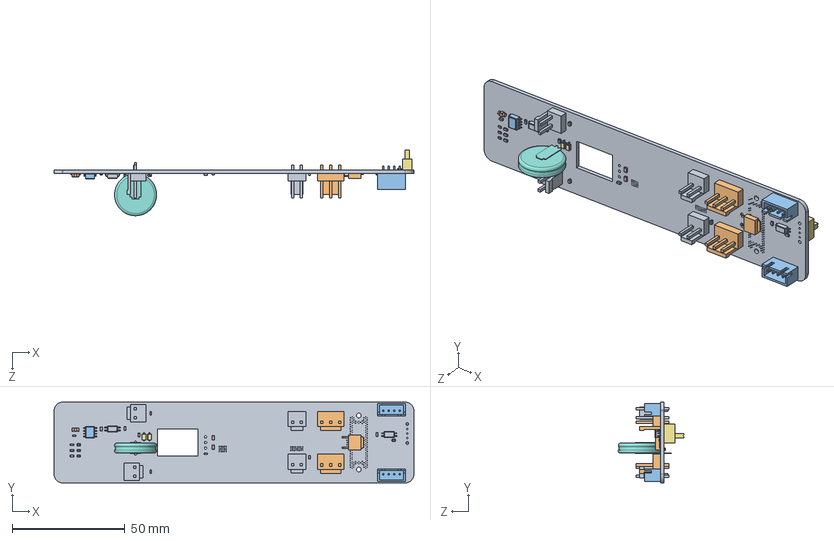
[picture p22: CAD file, 2023-07-12]
電子回路設計/3D化/電源基盤v1/電源基盤 v1.SLDASM
160.0 x 36.0 x 29.1 mm
Board
NFE31
SOIC127P600X250-8N
LEDC1608X39N_B x 4
pin x 2
pin(Mirror) x 2
icbody x 2
B2P-VH x 4
B3P-VH x 2
B4B-XH-A x 2
C0603 x 5
C0805 x 2
R0603 x 9
SS-12D01-VG4
SE-5R5-D105VYV
SOIC127P700X210-4N x 2
DPACK
