KatsukiOishi/HikkiKomori/電子回路設計/3D化/腕駆動回路v2/腕駆動回路 v2.SLDASM

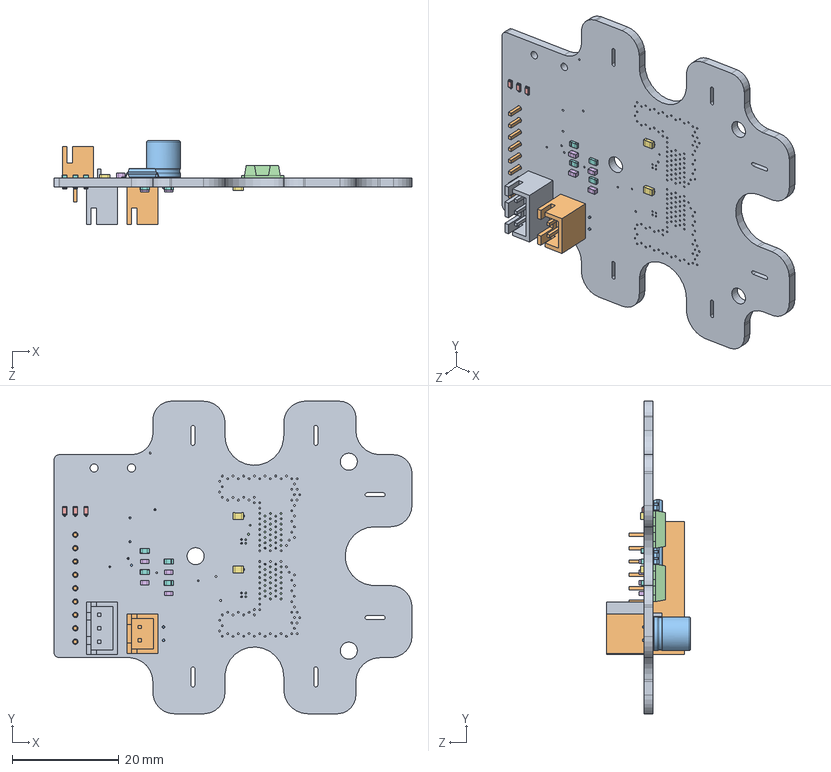
[picture p23: CAD file, 2023-07-12]
電子回路設計/3D化/腕駆動回路v2/腕駆動回路 v2.SLDASM
67.0 x 58.5 x 15.7 mm
Board
B2B-XH-A
SOP20
BTN9990LV x 2
LEDC1608X39N_G x 3
C0603 x 6
C0805 x 3
R0603 x 7
B3B-XH-A
B9B-XH-A
CPOL6.3-7_2.5
