KatsukiOishi/HikkiKomori/機械設計/_CAM/CAM_T8_1.SLDASM

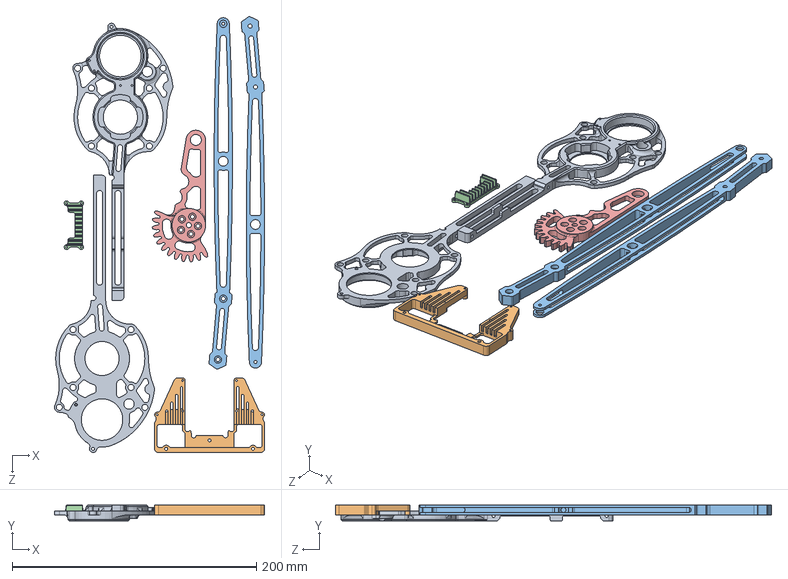
[picture p24: CAD file, 2023-07-30]
機械設計/_CAM/CAM_T8_1.SLDASM
172.0 x 13.0 x 356.8 mm
駆動節歯車付き
腕機構回路放熱板
従動節 x 2
足駆動回路放熱板
腕機構内壁 x 2
