KatsukiOishi/HikkiKomori/機械設計/01足機構/01ヘッケンリンク/左側足単体.SLDASM

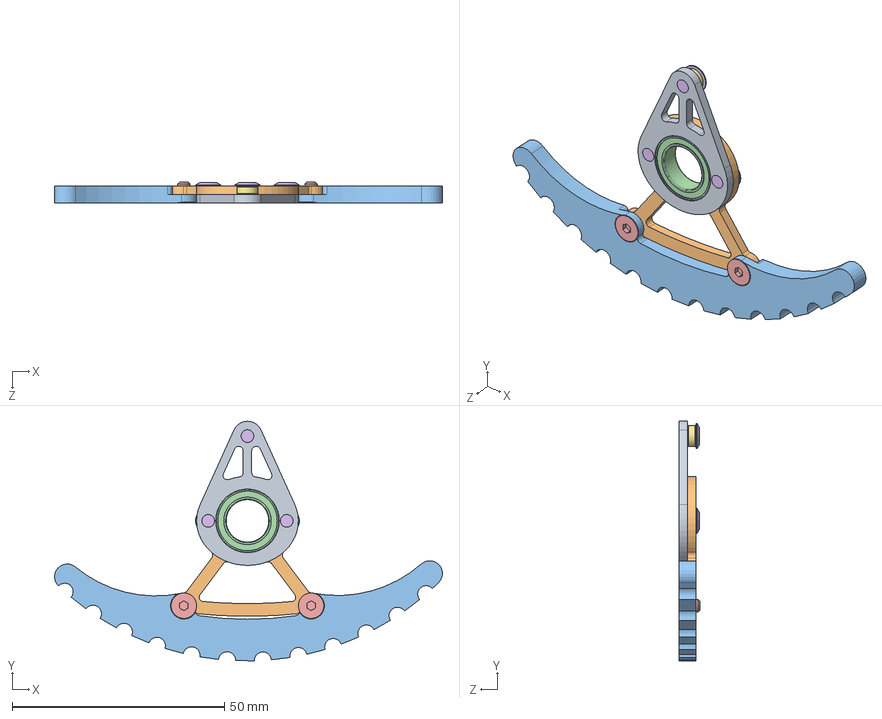
[picture p25: CAD file, 2022-06-01]
機械設計/01足機構/01ヘッケンリンク/左側足単体.SLDASM
91.5 x 56.5 x 5.00 mm
足上部
足下部
前足底
B6700ZZ
SFB3-5 x 2
CBSTBR3-4 x 3
WSSB5-3-2
