KatsukiOishi/HikkiKomori/前足底2.SLDPRT

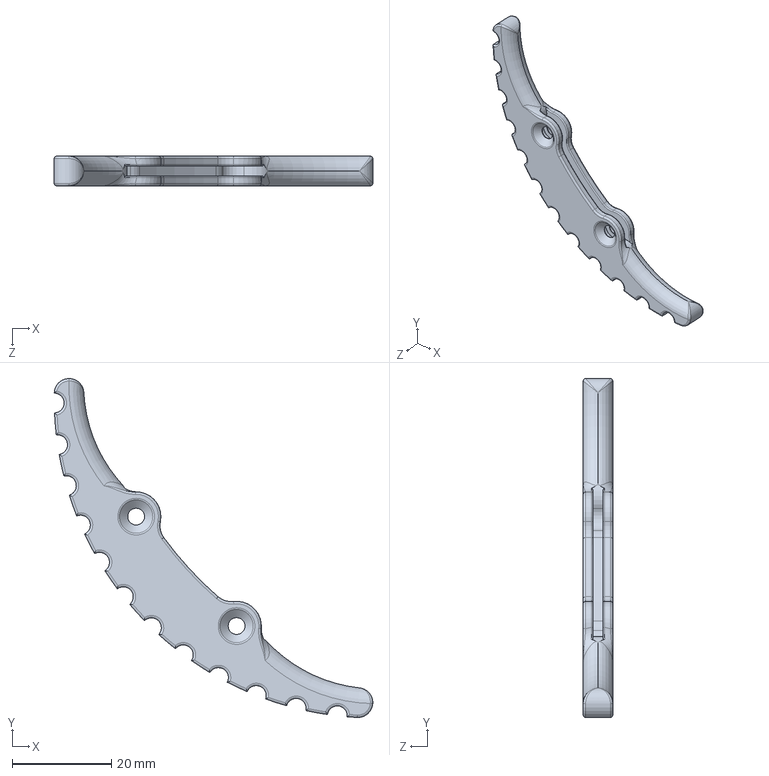
[picture p26: CAD file, 2023-08-26]
前足底2.SLDPRT
64.4 x 68.5 x 6.00 mm
