KatsukiOishi/HikkiKomori/機械設計/00既製品/CBE3-20.SLDPRT

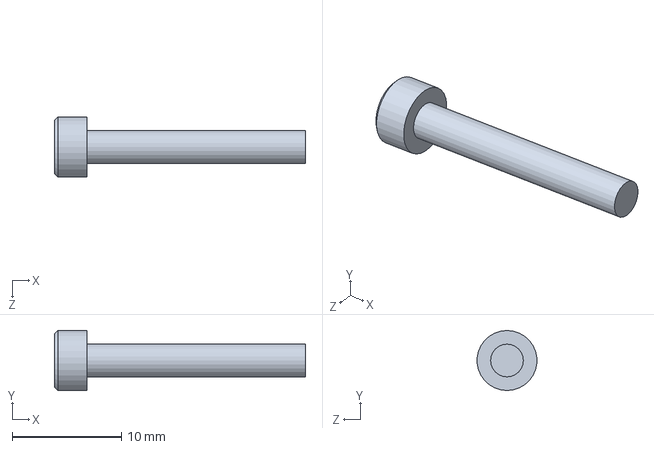
[picture p27: CAD file, 2025-05-29]
機械設計/00既製品/CBE3-20.SLDPRT
23.0 x 5.50 x 5.47 mm
