KatsukiOishi/HikkiKomori/機械設計/00既製品/CFS0.4/DRUM_CFS0.4.SLDPRT

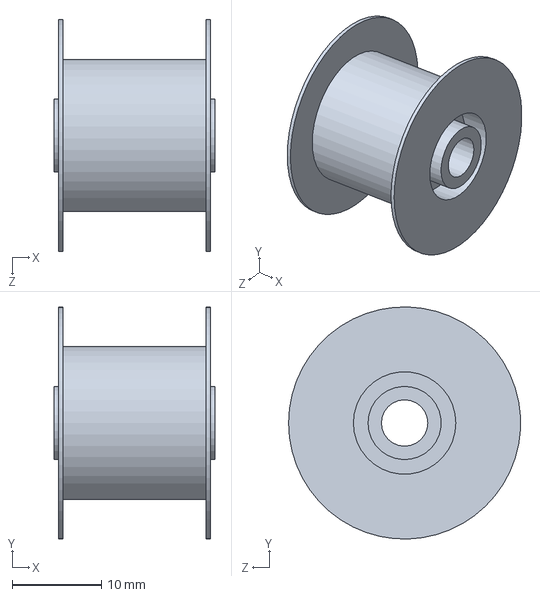
[picture p28: CAD file, 2025-05-29]
機械設計/00既製品/CFS0.4/DRUM_CFS0.4.SLDPRT
18.0 x 26.0 x 26.0 mm
