KatsukiOishi/HikkiKomori/機械設計/01足機構/01ヘッケンリンク/足レバー.SLDPRT

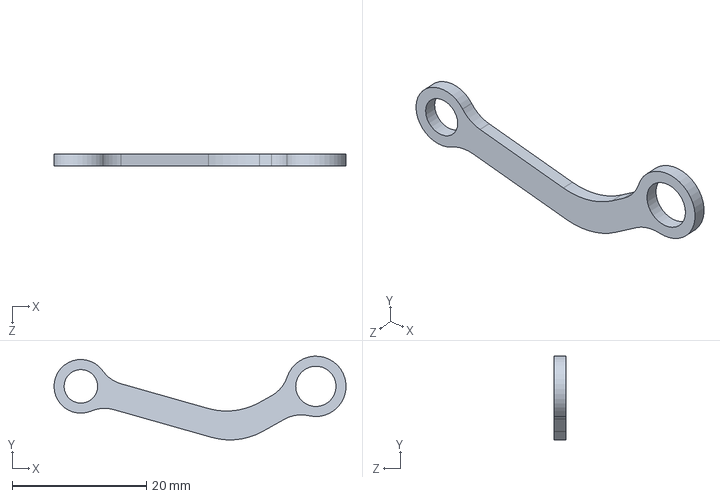
[picture p29: CAD file, 2025-05-29]
機械設計/01足機構/01ヘッケンリンク/足レバー.SLDPRT
43.5 x 12.5 x 1.80 mm
