KatsukiOishi/HikkiKomori/機械設計/01足機構/02足機構共通部品/カウンターアームロック.SLDPRT

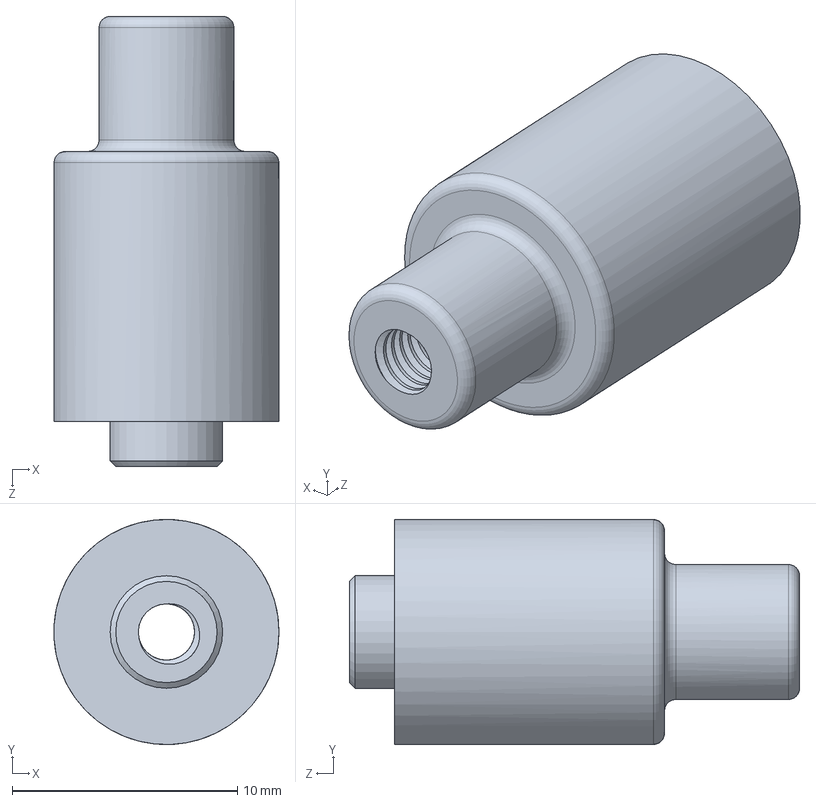
[picture p30: CAD file, 2025-05-29]
機械設計/01足機構/02足機構共通部品/カウンターアームロック.SLDPRT
9.99 x 10.00 x 20.0 mm
