KatsukiOishi/HikkiKomori/機械設計/01足機構/足機構上面カバー.sldprt

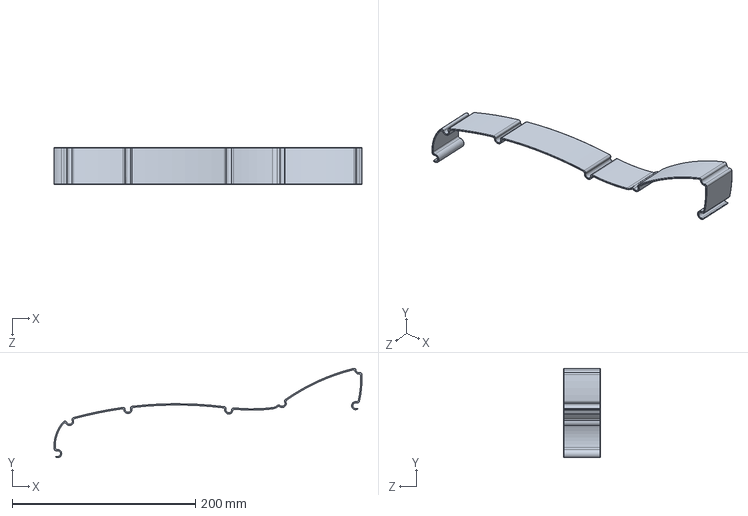
[picture p31: CAD file, 2025-05-29]
機械設計/01足機構/足機構上面カバー.sldprt
336.0 x 97.6 x 40.0 mm
