KatsukiOishi/HikkiKomori/機械設計/02中央ユニット/01展開機構/展開機構ブロック.sldprt

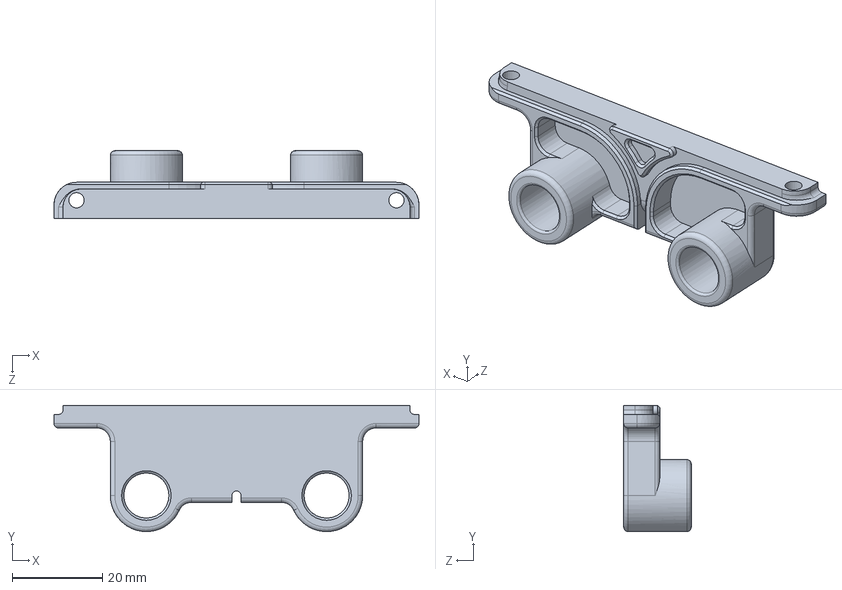
[picture p32: CAD file, 2025-05-29]
機械設計/02中央ユニット/01展開機構/展開機構ブロック.sldprt
81.0 x 28.0 x 15.0 mm
