KatsukiOishi/HikkiKomori/機械設計/03腕機構/01減速機構/入力減速部/腕電動機取付板.SLDPRT

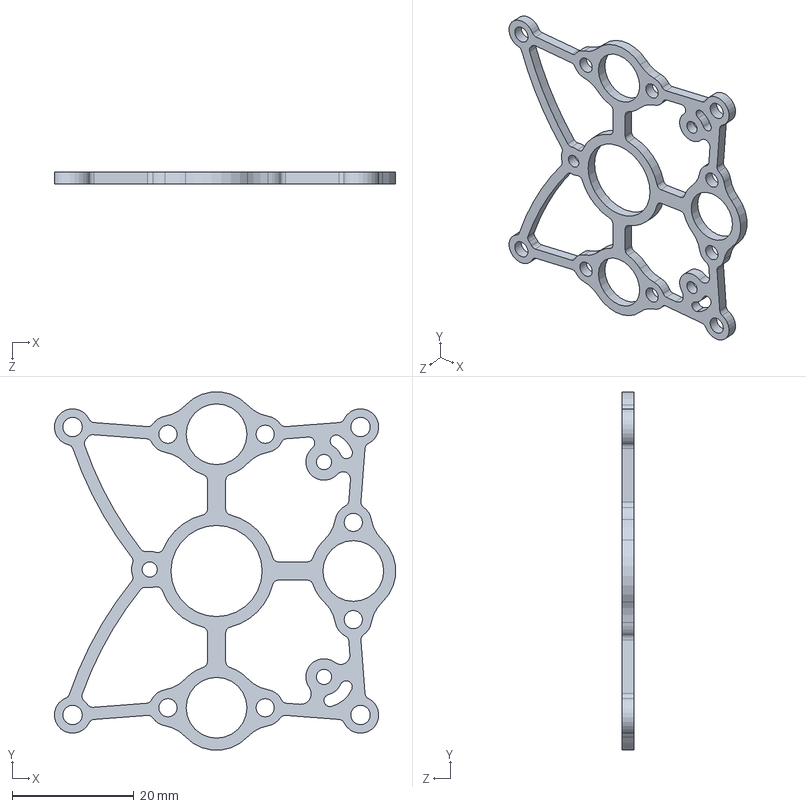
[picture p33: CAD file, 2025-05-29]
機械設計/03腕機構/01減速機構/入力減速部/腕電動機取付板.SLDPRT
56.1 x 58.9 x 2.00 mm
