KatsukiOishi/HikkiKomori/機械設計/03腕機構/01減速機構/内接減速機/内接歯車機構躯体.sldprt

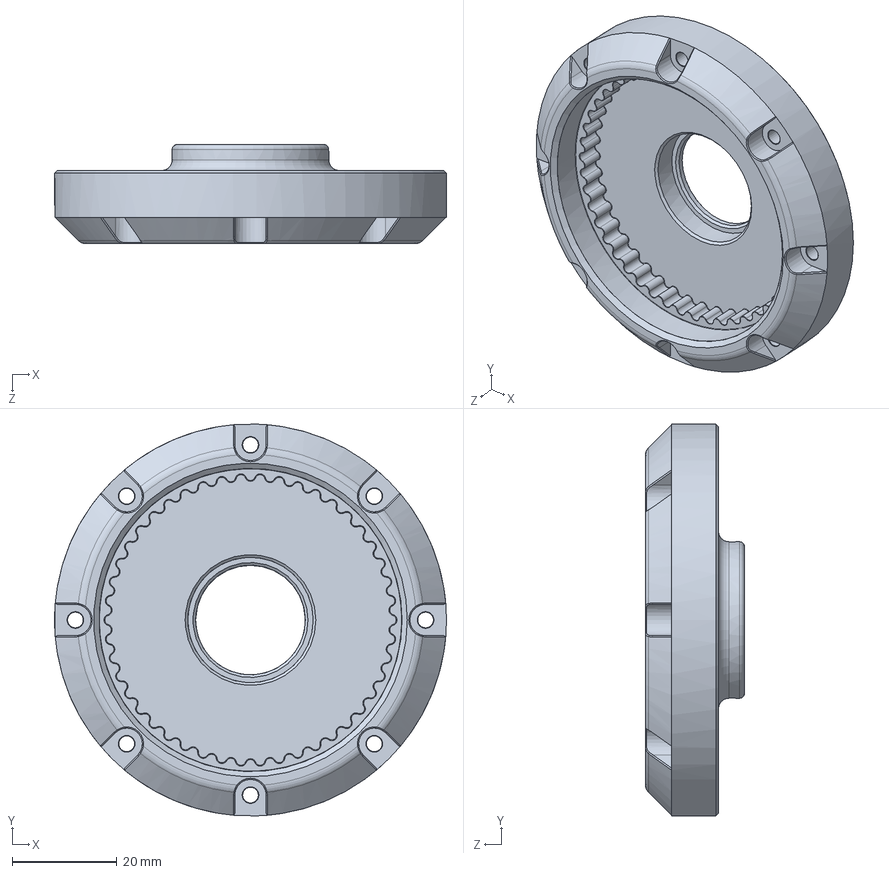
[picture p34: CAD file, 2025-05-29]
機械設計/03腕機構/01減速機構/内接減速機/内接歯車機構躯体.sldprt
75.0 x 75.0 x 19.0 mm
