KatsukiOishi/HikkiKomori/機械設計/03腕機構/02アームリンク/駆動節歯車付き.SLDPRT

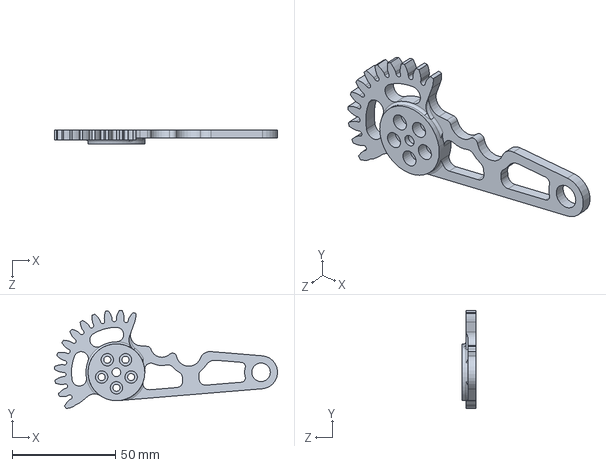
[picture p35: CAD file, 2025-05-29]
機械設計/03腕機構/02アームリンク/駆動節歯車付き.SLDPRT
107.9 x 47.6 x 7.00 mm
