KatsukiOishi/HikkiKomori/機械設計/03腕機構/腕機構内壁.sldprt

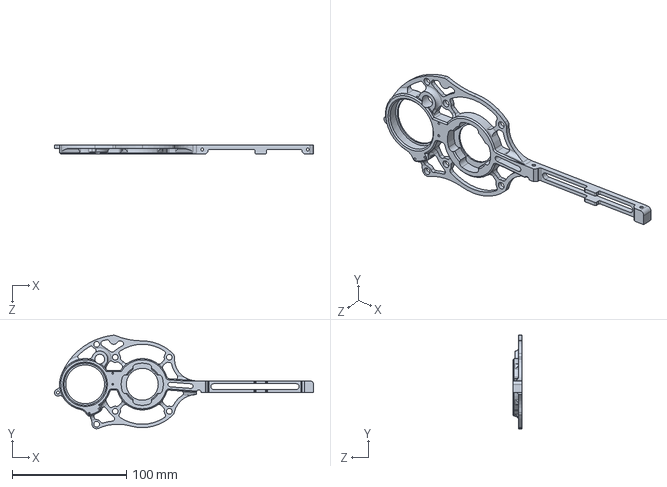
[picture p36: CAD file, 2025-05-29]
機械設計/03腕機構/腕機構内壁.sldprt
226.9 x 82.0 x 8.00 mm
