KatsukiOishi/HikkiKomori/機械設計/04電子回路/足駆動回路放熱板.SLDPRT

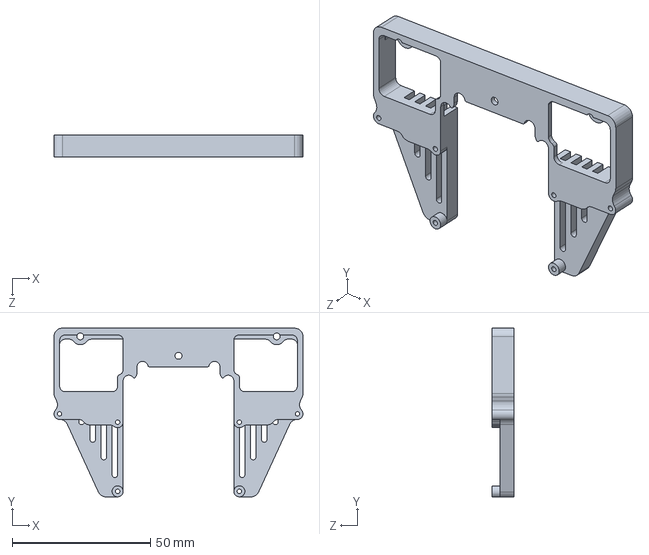
[picture p37: CAD file, 2025-05-29]
機械設計/04電子回路/足駆動回路放熱板.SLDPRT
90.0 x 61.0 x 8.00 mm
