KatsukiOishi/HikkiKomori/機械設計/05リンクサス/リンクサス節軸.SLDPRT

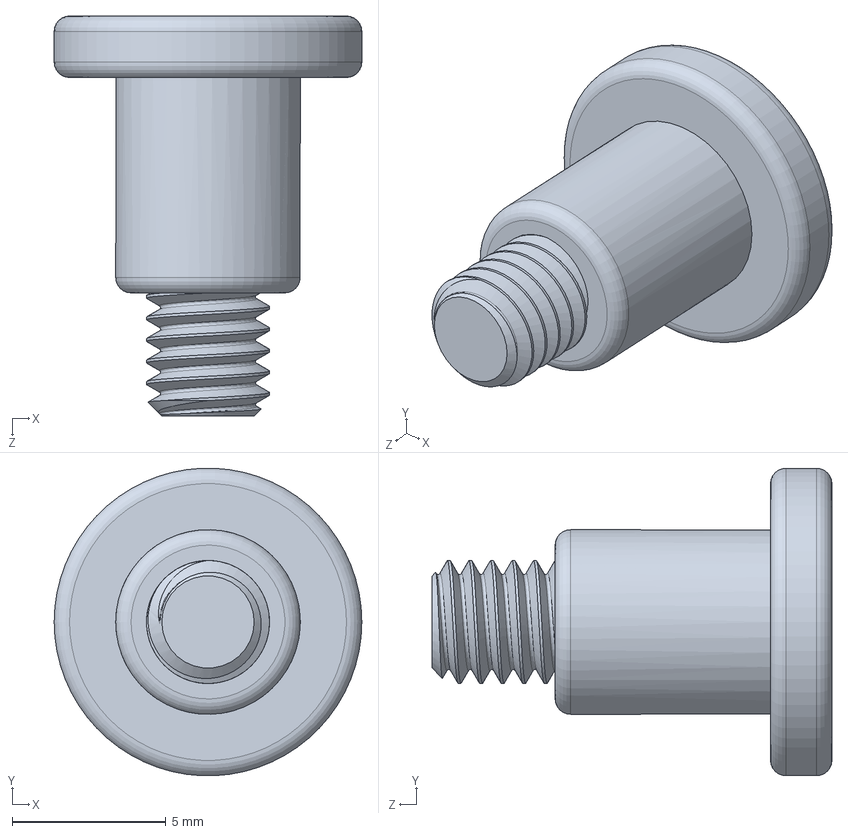
[picture p38: CAD file, 2025-05-29]
機械設計/05リンクサス/リンクサス節軸.SLDPRT
10.0 x 9.99 x 13.0 mm
