KatsukiOishi/HikkiKomori/電子回路設計/腕駆動回路/腕駆動回路.dxf

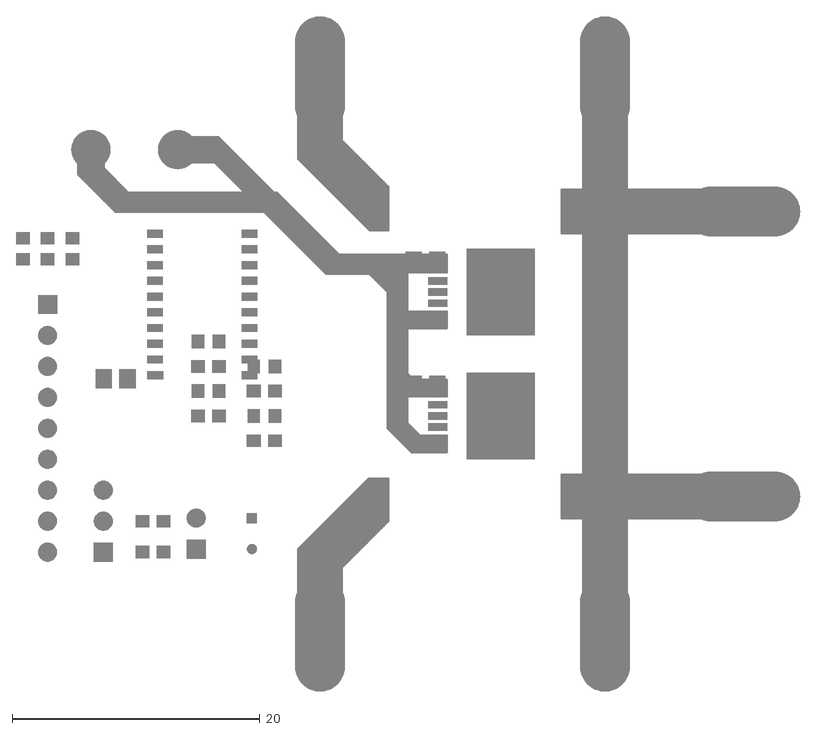
[picture p39: CAD file, 2023-07-12]
電子回路設計/腕駆動回路/腕駆動回路.dxf
63.3 x 54.5
