KatsukiOishi/HikkiKomori/機械設計/00既製品/ARL-400BE.SLDPRT

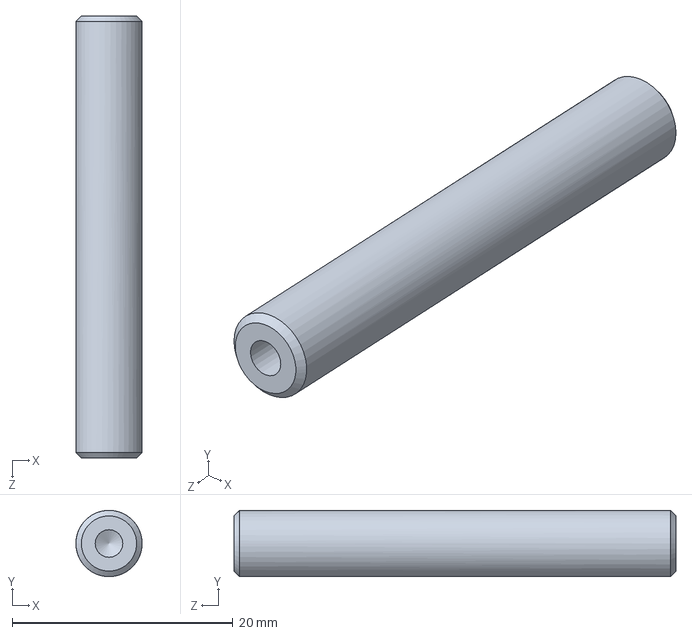
[picture p40: CAD file, 2025-05-29]
機械設計/00既製品/ARL-400BE.SLDPRT
6.00 x 5.99 x 40.0 mm
