KatsukiOishi/HikkiKomori/機械設計/00既製品/RS380/Terminal12V.SLDPRT

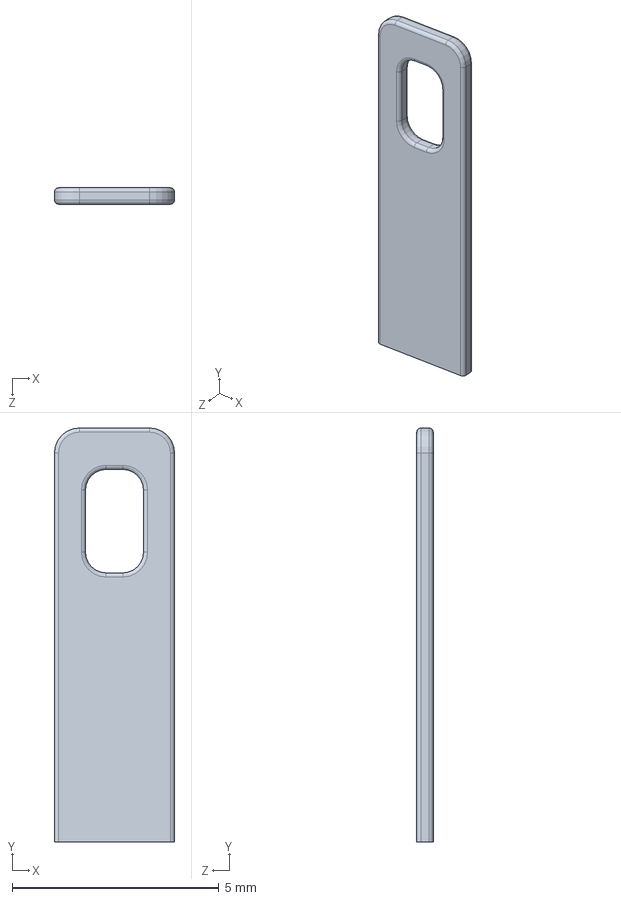
[picture p41: CAD file, 2025-05-29]
機械設計/00既製品/RS380/Terminal12V.SLDPRT
2.90 x 10.0 x 0.4 mm
