KatsukiOishi/HikkiKomori/機械設計/00既製品/SS-10GL13/SS_10GL13_ACTUATOR.SLDPRT

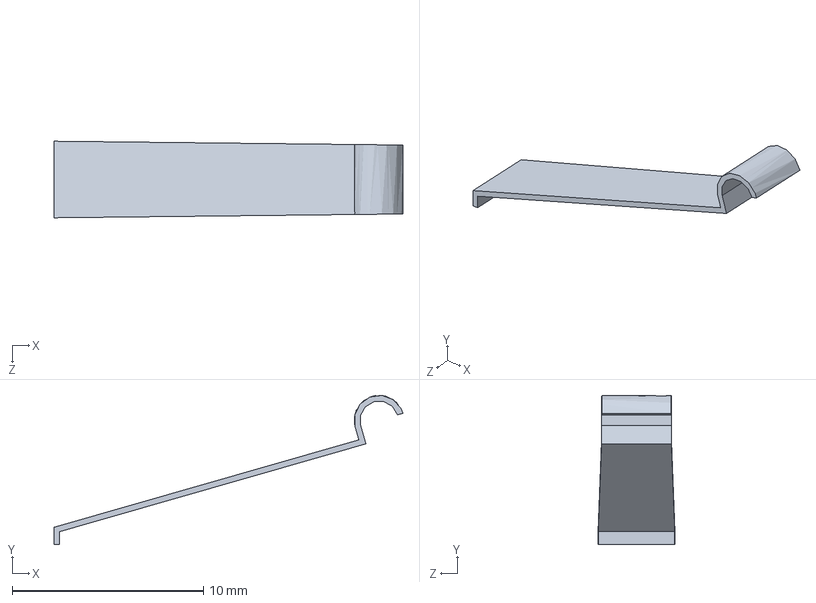
[picture p42: CAD file, 2025-05-29]
機械設計/00既製品/SS-10GL13/SS_10GL13_ACTUATOR.SLDPRT
18.2 x 7.79 x 4.00 mm
