KatsukiOishi/HikkiKomori/機械設計/01足機構/01ヘッケンリンク/足プーリー中心軸.SLDPRT

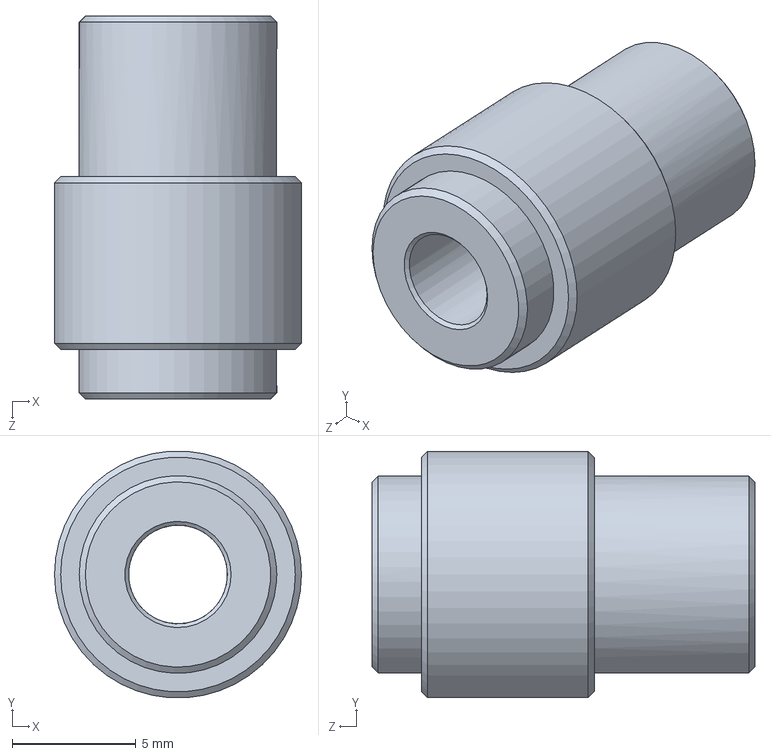
[picture p43: CAD file, 2025-05-29]
機械設計/01足機構/01ヘッケンリンク/足プーリー中心軸.SLDPRT
10.0 x 9.98 x 15.5 mm
