KatsukiOishi/HikkiKomori/機械設計/01足機構/左足機構側面充填樹脂.sldprt

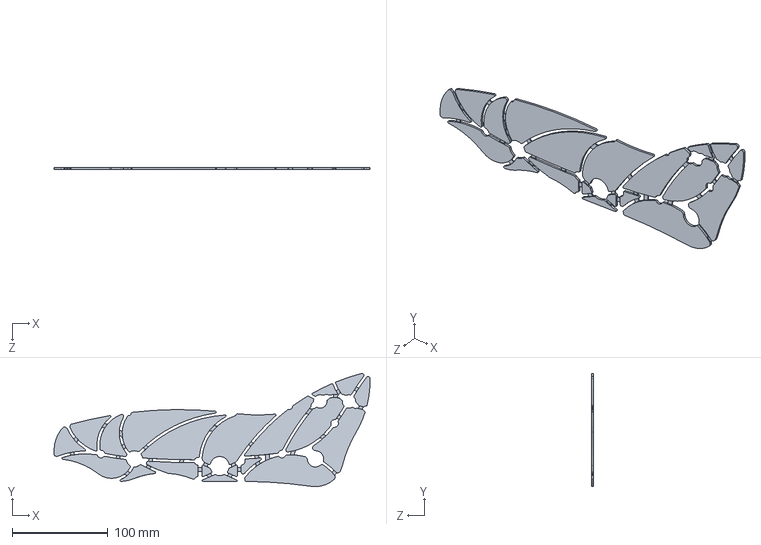
[picture p44: CAD file, 2025-05-29]
機械設計/01足機構/左足機構側面充填樹脂.sldprt
329.9 x 118.2 x 2.00 mm
