KatsukiOishi/HikkiKomori/機械設計/02中央ユニット/横展開抜止め.SLDPRT

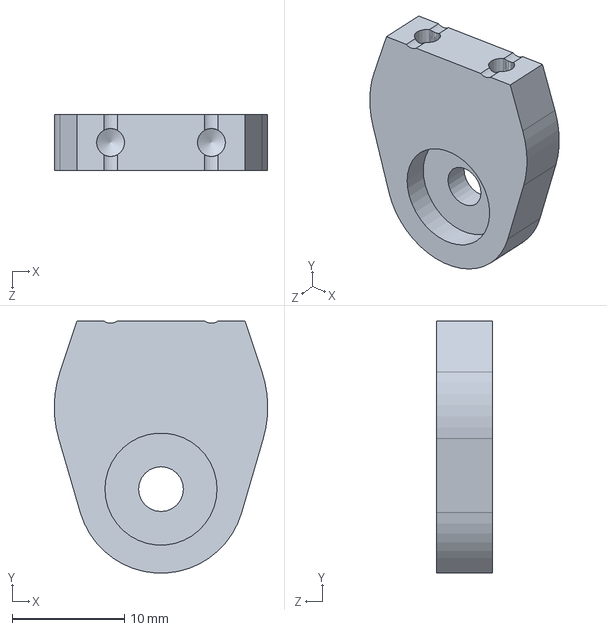
[picture p45: CAD file, 2025-05-29]
機械設計/02中央ユニット/横展開抜止め.SLDPRT
19.0 x 22.5 x 5.00 mm
