KatsukiOishi/HikkiKomori/機械設計/03腕機構/01減速機構/入力減速部/入力減速機構基盤.sldprt

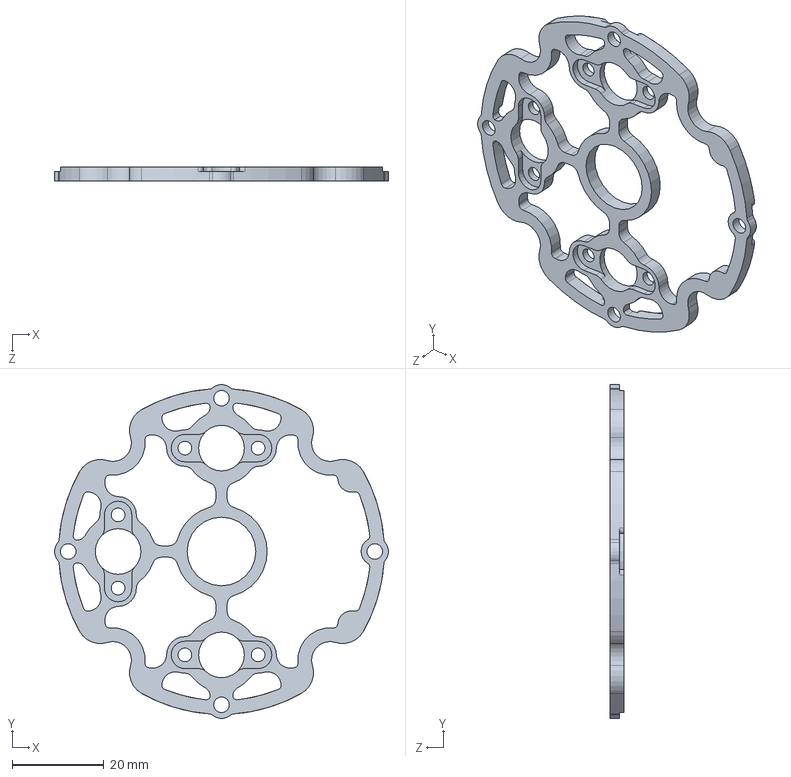
[picture p46: CAD file, 2023-07-12]
機械設計/03腕機構/01減速機構/入力減速部/入力減速機構基盤.sldprt
73.0 x 73.0 x 3.00 mm
