KatsukiOishi/HikkiKomori/機械設計/03腕機構/01減速機構/内接減速機/曲軸.SLDPRT

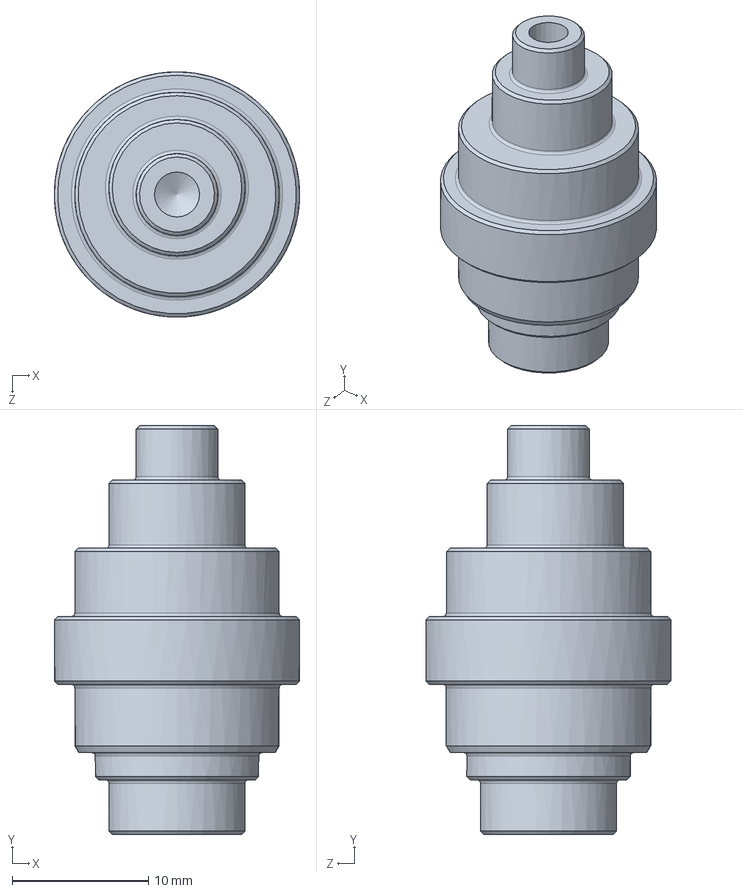
[picture p47: CAD file, 2025-05-29]
機械設計/03腕機構/01減速機構/内接減速機/曲軸.SLDPRT
18.0 x 30.0 x 18.0 mm
