KatsukiOishi/HikkiKomori/機械設計/03腕機構/01減速機構/腕機構カバー.SLDPRT

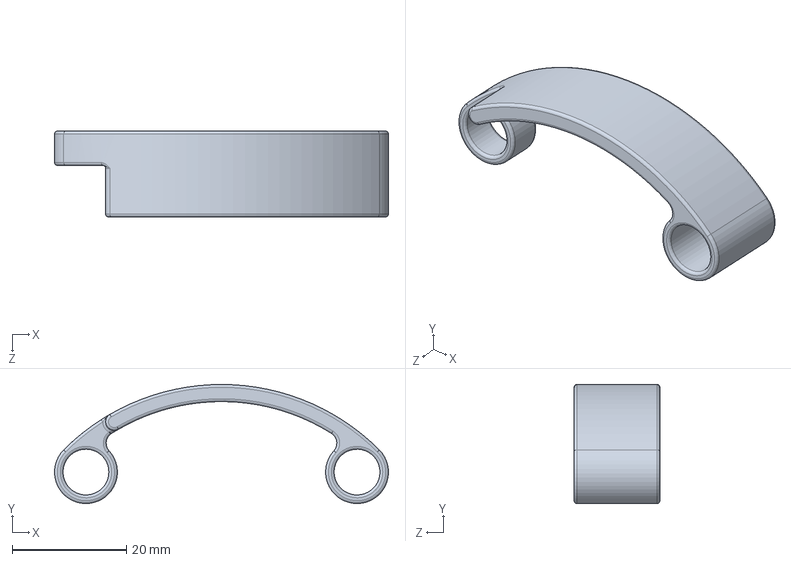
[picture p48: CAD file, 2025-05-29]
機械設計/03腕機構/01減速機構/腕機構カバー.SLDPRT
58.4 x 20.8 x 15.0 mm
