KatsukiOishi/HikkiKomori/機械設計/03腕機構/03ロングロッド/従動節.SLDPRT

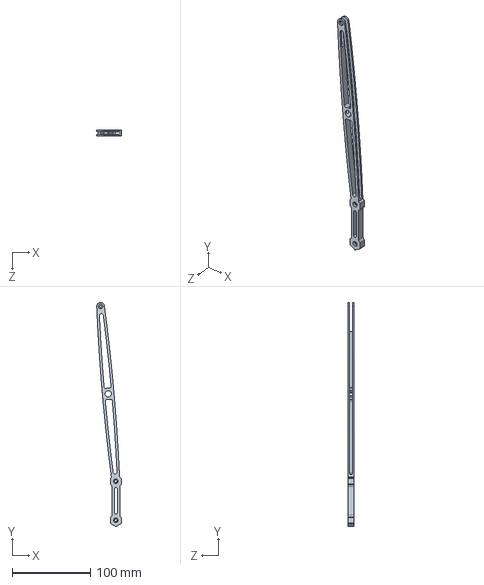
[picture p49: CAD file, 2025-05-29]
機械設計/03腕機構/03ロングロッド/従動節.SLDPRT
31.6 x 287.1 x 8.00 mm
