KatsukiOishi/HikkiKomori/機械設計/03腕機構/腕機構回路放熱板.SLDPRT

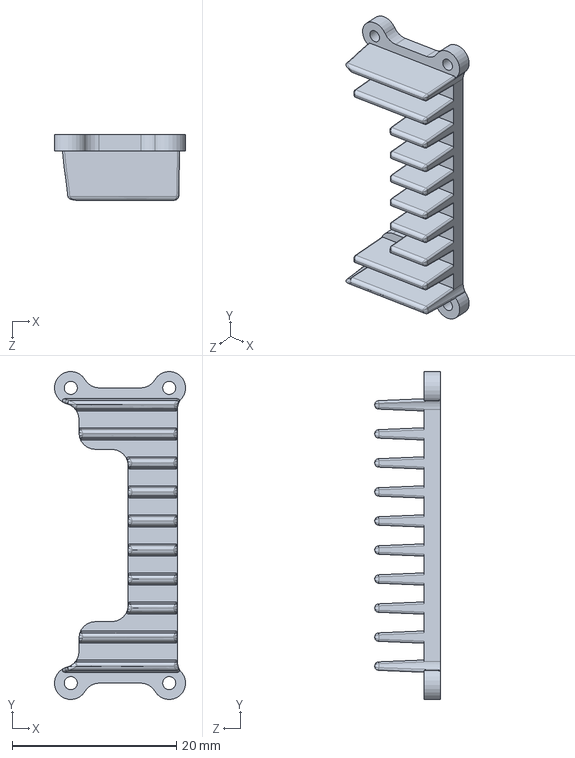
[picture p50: CAD file, 2025-05-29]
機械設計/03腕機構/腕機構回路放熱板.SLDPRT
16.0 x 40.0 x 8.00 mm
