KatsukiOishi/HikkiKomori/機械設計/05リンクサス/リンクサス短辺.SLDPRT

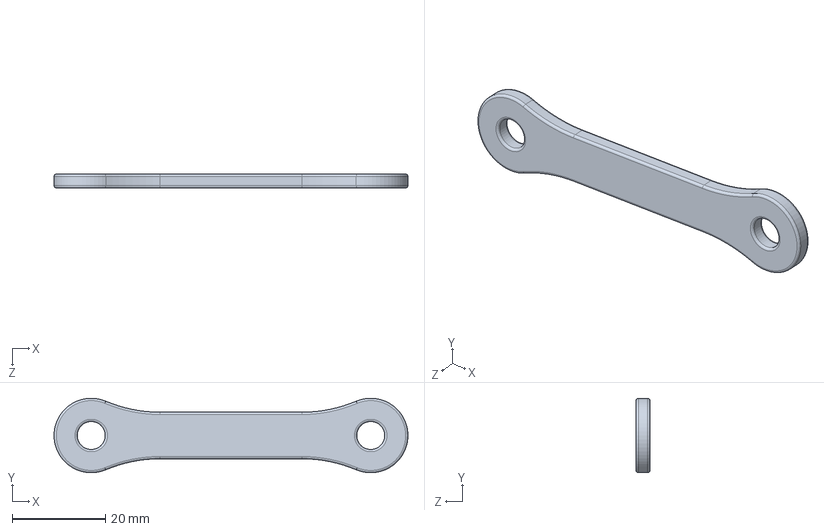
[picture p51: CAD file, 2025-05-29]
機械設計/05リンクサス/リンクサス短辺.SLDPRT
76.0 x 16.0 x 3.00 mm
