KatsukiOishi/HikkiKomori/機械設計/躯体ブランク.SLDPRT

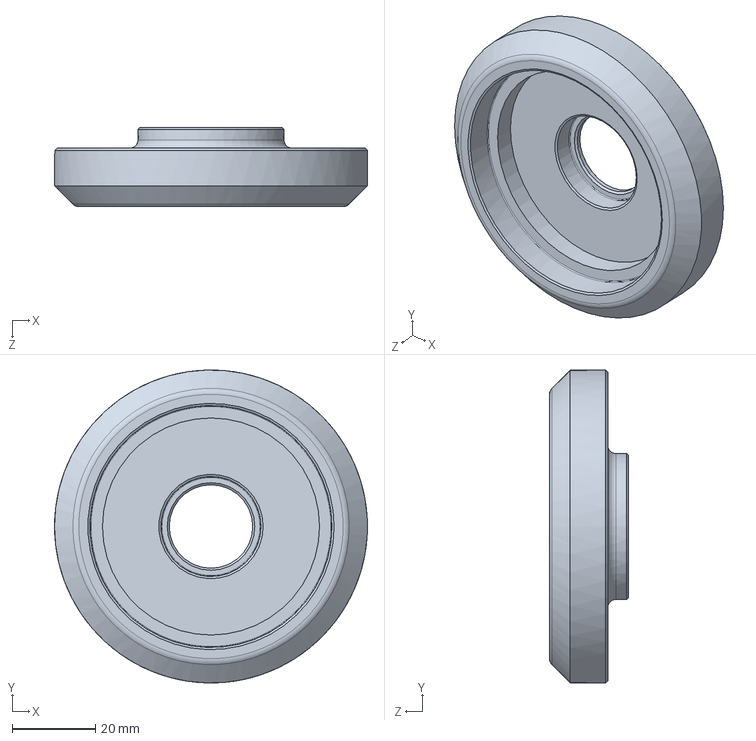
[picture p52: CAD file, 2022-06-10]
機械設計/躯体ブランク.SLDPRT
75.0 x 75.0 x 19.0 mm
