KatsukiOishi/HikkiKomori/機械設計/00既製品/DPS-C6X20.SLDPRT

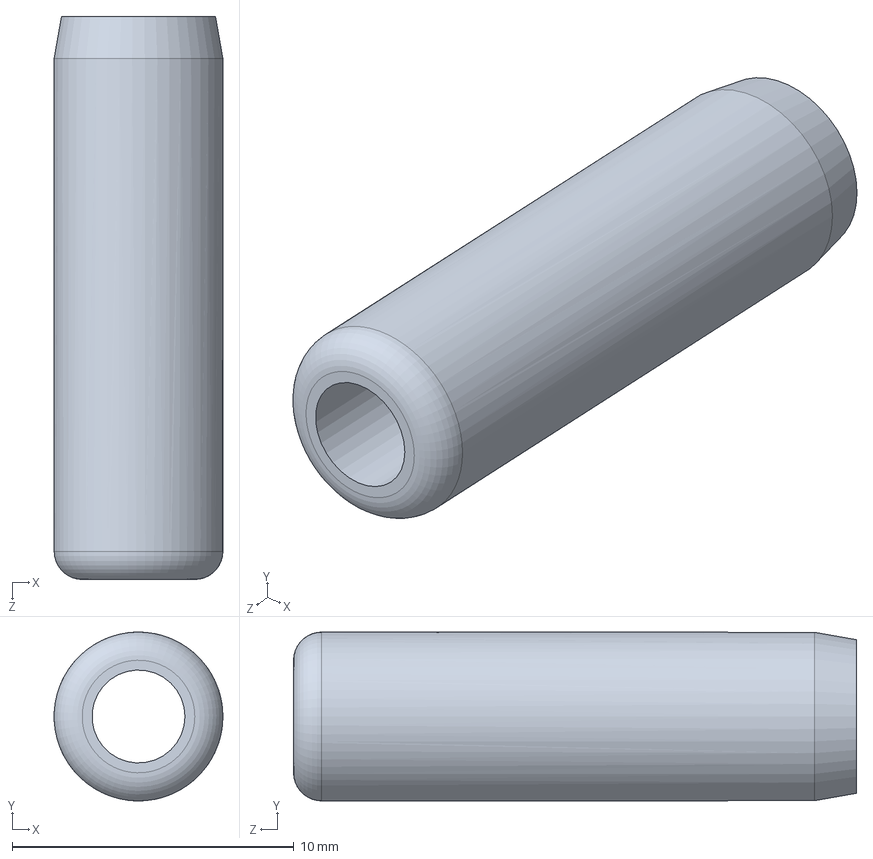
[picture p53: CAD file, 2025-05-29]
機械設計/00既製品/DPS-C6X20.SLDPRT
6.00 x 6.00 x 20.0 mm
