KatsukiOishi/HikkiKomori/機械設計/00既製品/RS380/Mancal12V.SLDPRT

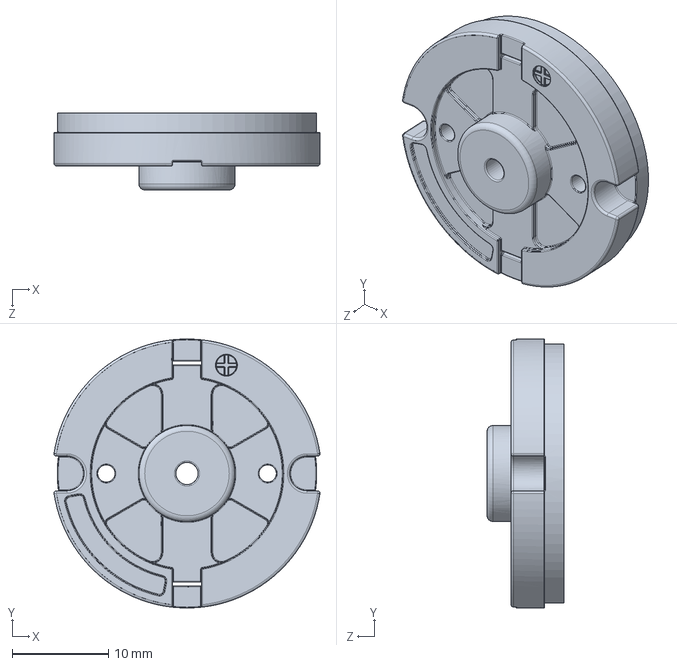
[picture p54: CAD file, 2025-05-29]
機械設計/00既製品/RS380/Mancal12V.SLDPRT
27.7 x 28.0 x 8.00 mm
