KatsukiOishi/HikkiKomori/機械設計/00既製品/SCCN6-6/Shaft Collar_SCCN6-6.SLDPRT

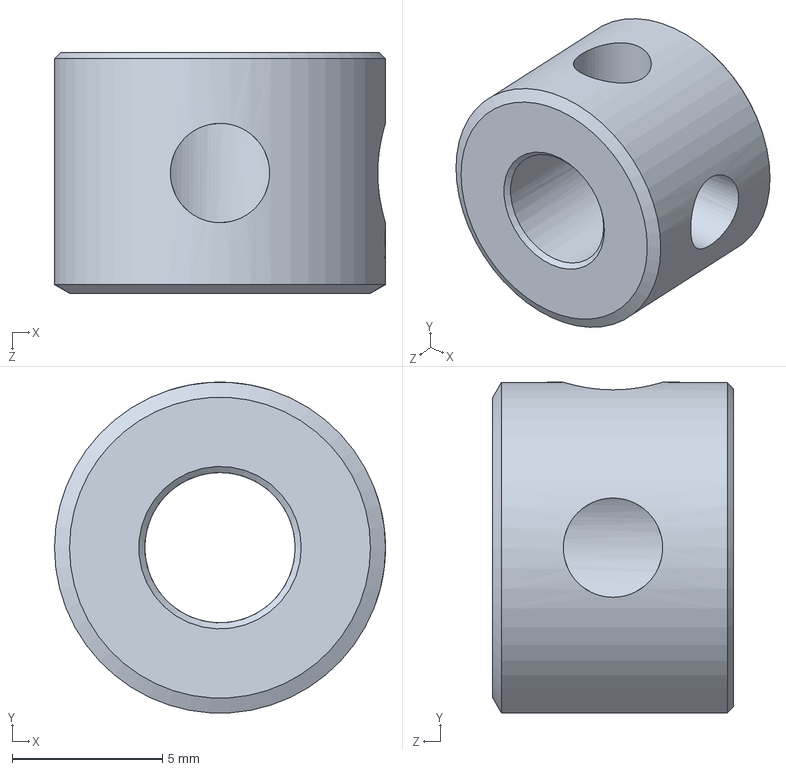
[picture p55: CAD file, 2025-05-29]
機械設計/00既製品/SCCN6-6/Shaft Collar_SCCN6-6.SLDPRT
11.0 x 11.0 x 8.00 mm
