KatsukiOishi/HikkiKomori/機械設計/00既製品/SFHRW6-103.0-M3-N3/Retaining Ring E Ex-1_SFHRW6-103.0-M3-N3.SLDPRT

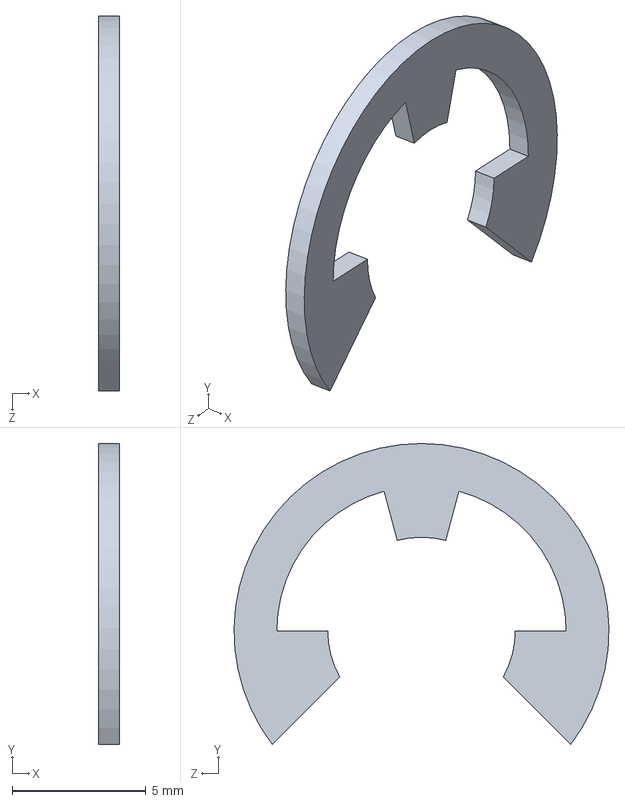
[picture p56: CAD file, 2022-06-01]
機械設計/00既製品/SFHRW6-103.0-M3-N3/Retaining Ring E Ex-1_SFHRW6-103.0-M3-N3.SLDPRT
0.8 x 11.2 x 14.0 mm
