KatsukiOishi/HikkiKomori/機械設計/00既製品/SFRHH6-109.0-F2.5-P5-T2.5-M3/Retaining Ring C Ex-3_SFRHH6-109.0-F2.5-P5-T2.5-M3.SLDPRT

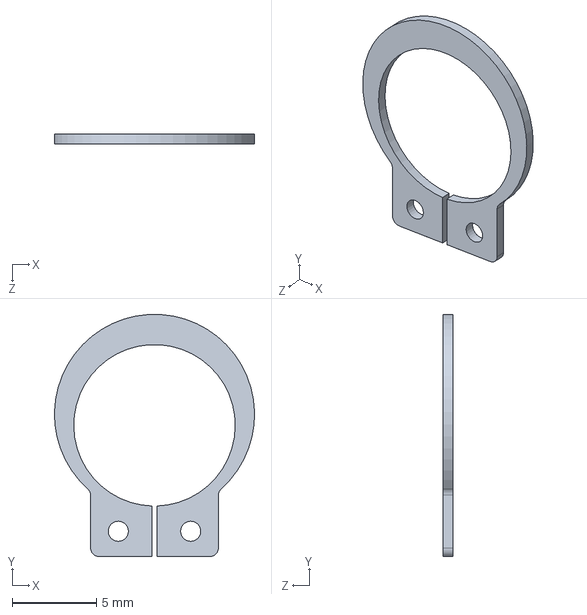
[picture p57: CAD file, 2022-06-01]
機械設計/00既製品/SFRHH6-109.0-F2.5-P5-T2.5-M3/Retaining Ring C Ex-3_SFRHH6-109.0-F2.5-P5-T2.5-M3.SLDPRT
11.9 x 14.4 x 0.6 mm
