KatsukiOishi/HikkiKomori/機械設計/00既製品/SFRMGH8-15.0-F2.8-P6-T4.9-M3/Retaining Ring E Ex-1_SFRMGH8-15.0-F2.8-P6-T4.9-M3.SLDPRT

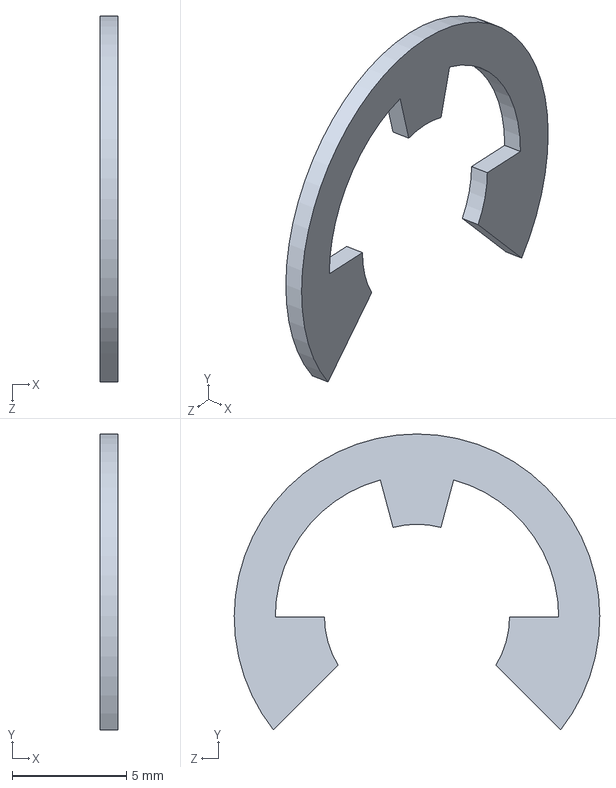
[picture p58: CAD file, 2023-07-12]
機械設計/00既製品/SFRMGH8-15.0-F2.8-P6-T4.9-M3/Retaining Ring E Ex-1_SFRMGH8-15.0-F2.8-P6-T4.9-M3.SLDPRT
0.8 x 13.0 x 16.0 mm
