KatsukiOishi/HikkiKomori/機械設計/00既製品/SS-10GL13/SS_10GL13_BASE.SLDPRT

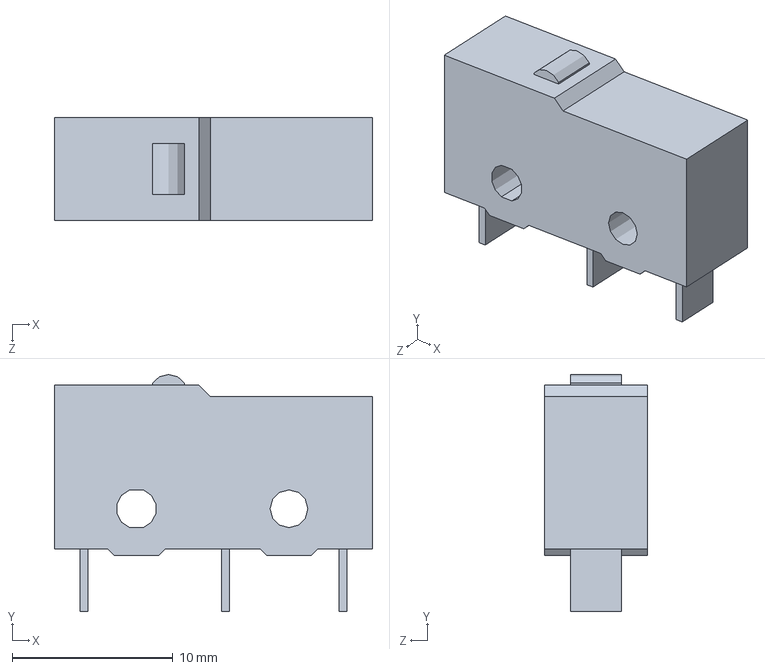
[picture p59: CAD file, 2025-05-29]
機械設計/00既製品/SS-10GL13/SS_10GL13_BASE.SLDPRT
19.8 x 14.8 x 6.40 mm
