KatsukiOishi/HikkiKomori/機械設計/01足機構/01ヘッケンリンク/足機構曲軸結合部.SLDPRT

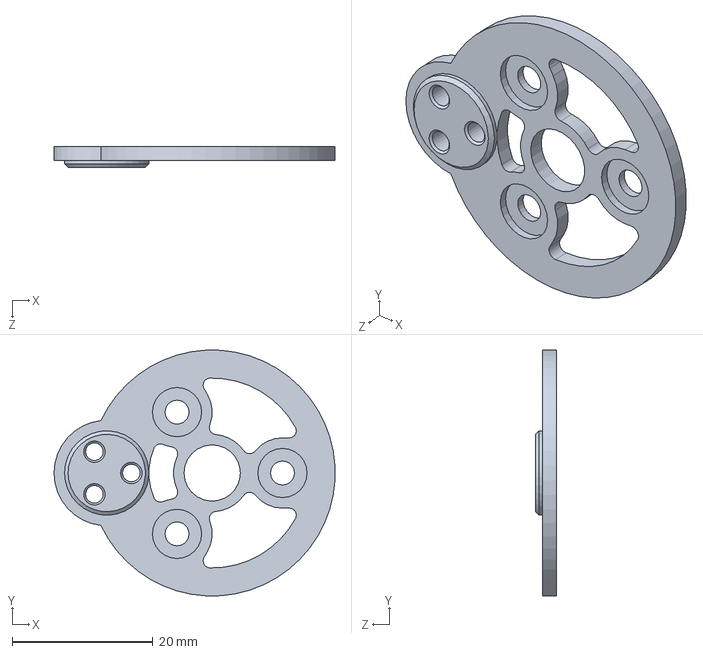
[picture p60: CAD file, 2025-05-29]
機械設計/01足機構/01ヘッケンリンク/足機構曲軸結合部.SLDPRT
40.0 x 35.0 x 3.00 mm
