KatsukiOishi/HikkiKomori/機械設計/01足機構/足ゴム.SLDPRT

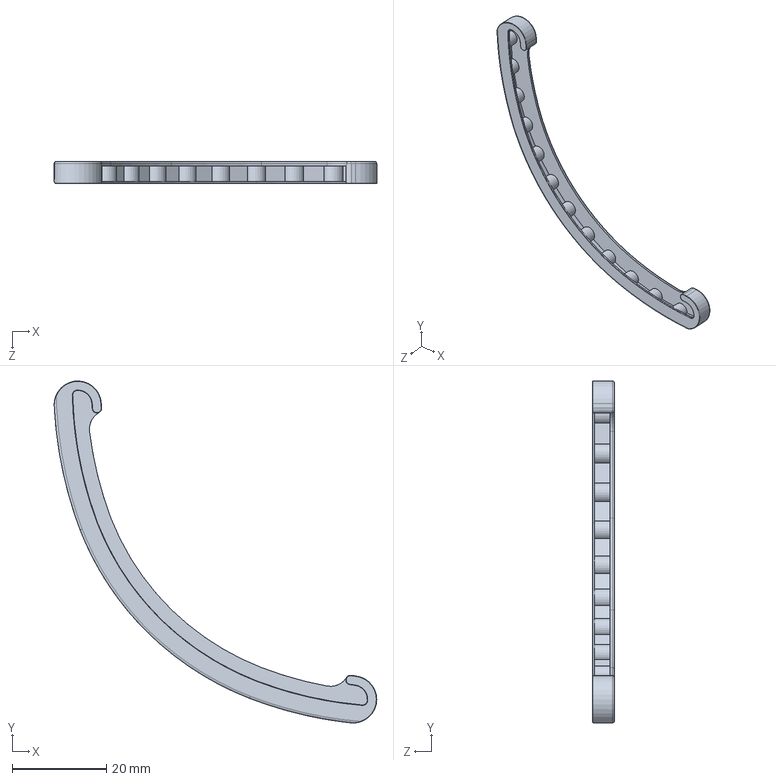
[picture p61: CAD file, 2025-05-29]
機械設計/01足機構/足ゴム.SLDPRT
68.4 x 72.5 x 4.75 mm
