KatsukiOishi/HikkiKomori/機械設計/02中央ユニット/01展開機構/抑制鍵.SLDPRT

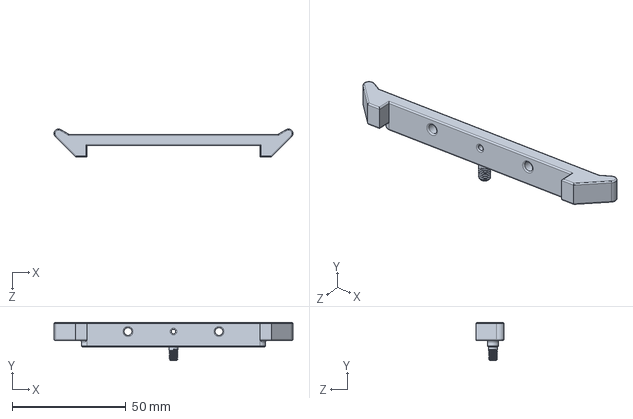
[picture p62: CAD file, 2025-05-29]
機械設計/02中央ユニット/01展開機構/抑制鍵.SLDPRT
105.0 x 16.8 x 12.3 mm
