KatsukiOishi/HikkiKomori/機械設計/03腕機構/01減速機構/最終段ピニオン.SLDPRT

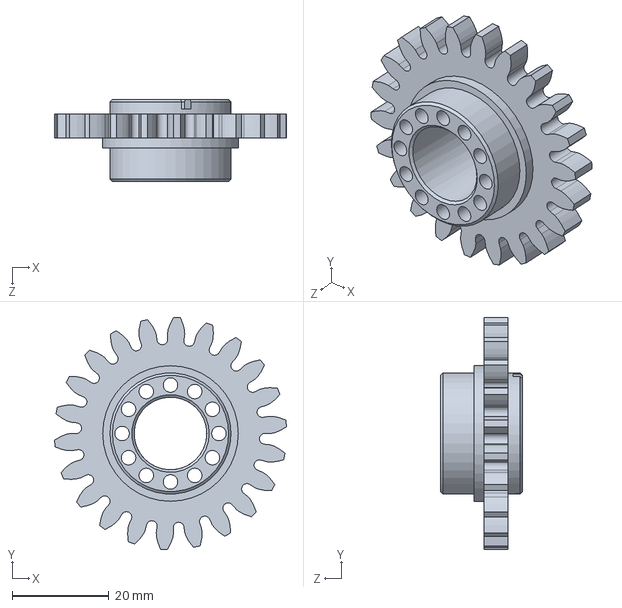
[picture p63: CAD file, 2025-05-29]
機械設計/03腕機構/01減速機構/最終段ピニオン.SLDPRT
47.9 x 48.0 x 17.0 mm
