KatsukiOishi/HikkiKomori/機械設計/03腕機構/02アームリンク/駆動節.SLDPRT

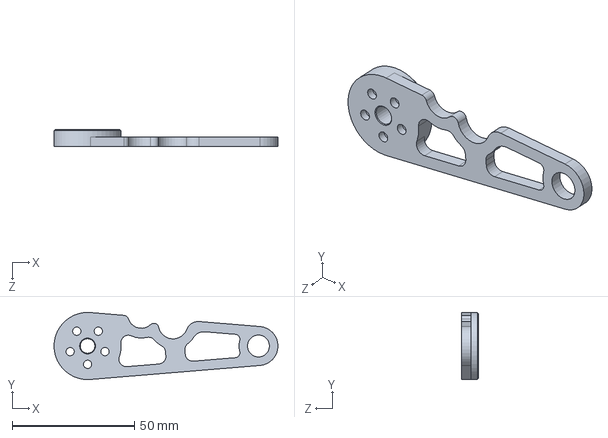
[picture p64: CAD file, 2025-05-29]
機械設計/03腕機構/02アームリンク/駆動節.SLDPRT
91.8 x 27.5 x 7.00 mm
