KatsukiOishi/HikkiKomori/機械設計/03腕機構/04カウンターアーム/カウンターアーム.SLDPRT

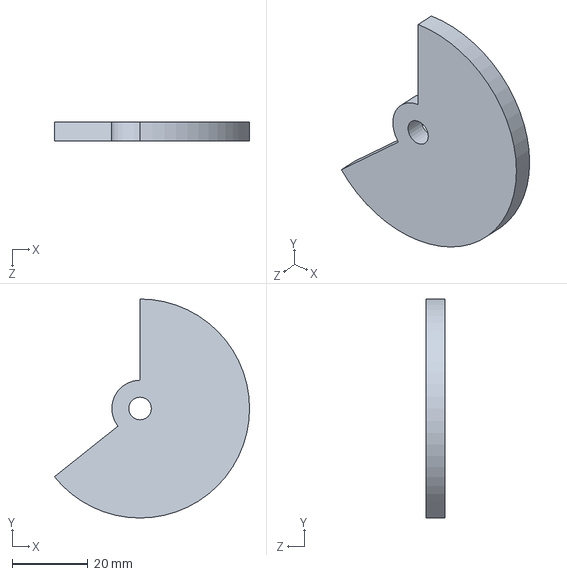
[picture p65: CAD file, 2025-05-29]
機械設計/03腕機構/04カウンターアーム/カウンターアーム.SLDPRT
51.7 x 58.0 x 5.00 mm
