KatsukiOishi/HikkiKomori/機械設計/05リンクサス/リンクサス足側軸部.SLDPRT

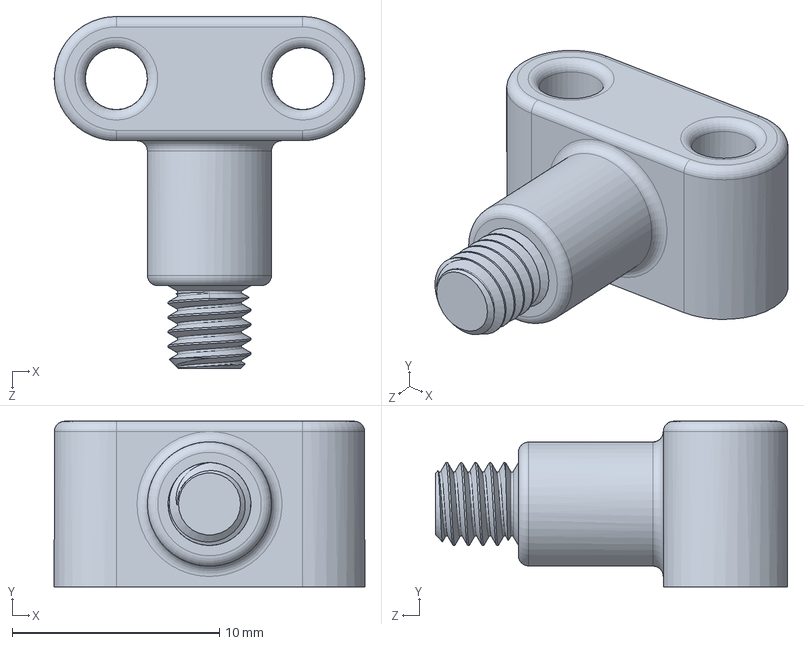
[picture p66: CAD file, 2025-05-29]
機械設計/05リンクサス/リンクサス足側軸部.SLDPRT
15.0 x 8.00 x 17.0 mm
