KatsukiOishi/HikkiKomori/機械設計/_CAM/足機構上面カバー1.SLDPRT

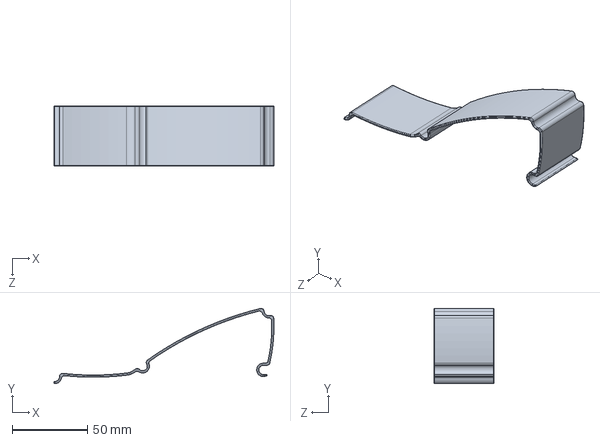
[picture p67: CAD file, 2023-08-18]
機械設計/_CAM/足機構上面カバー1.SLDPRT
145.9 x 50.0 x 40.0 mm
