KatsukiOishi/HikkiKomori/緊急軸.SLDPRT

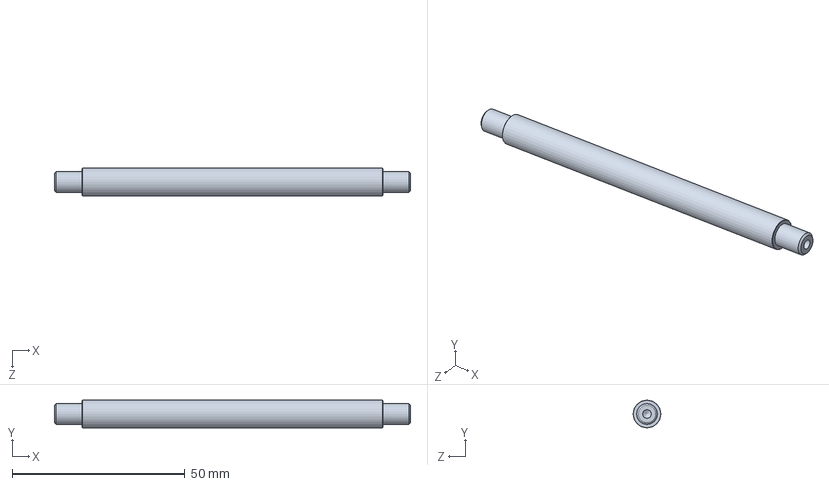
[picture p68: CAD file, 2023-08-26]
緊急軸.SLDPRT
103.0 x 8.00 x 8.00 mm
