KatsukiOishi/HikkiKomori/機械設計/00既製品/ABETTF6-90.0-M3-N3.SLDPRT

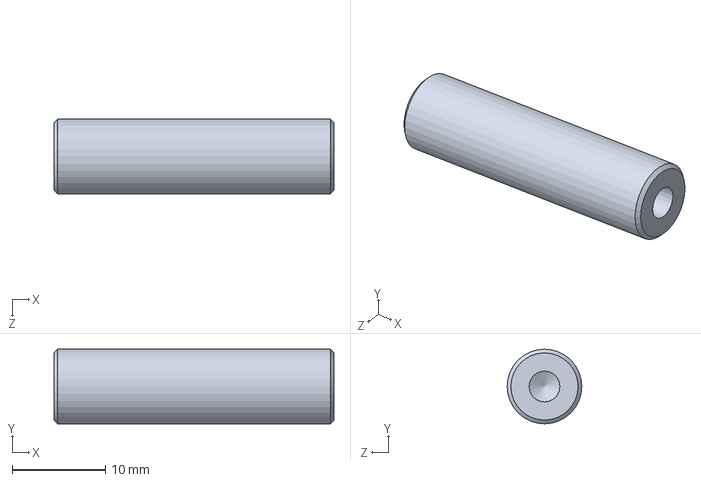
[picture p69: CAD file, 2025-05-29]
機械設計/00既製品/ABETTF6-90.0-M3-N3.SLDPRT
30.0 x 8.00 x 8.00 mm
