KatsukiOishi/HikkiKomori/機械設計/00既製品/RS380/ケース.SLDPRT

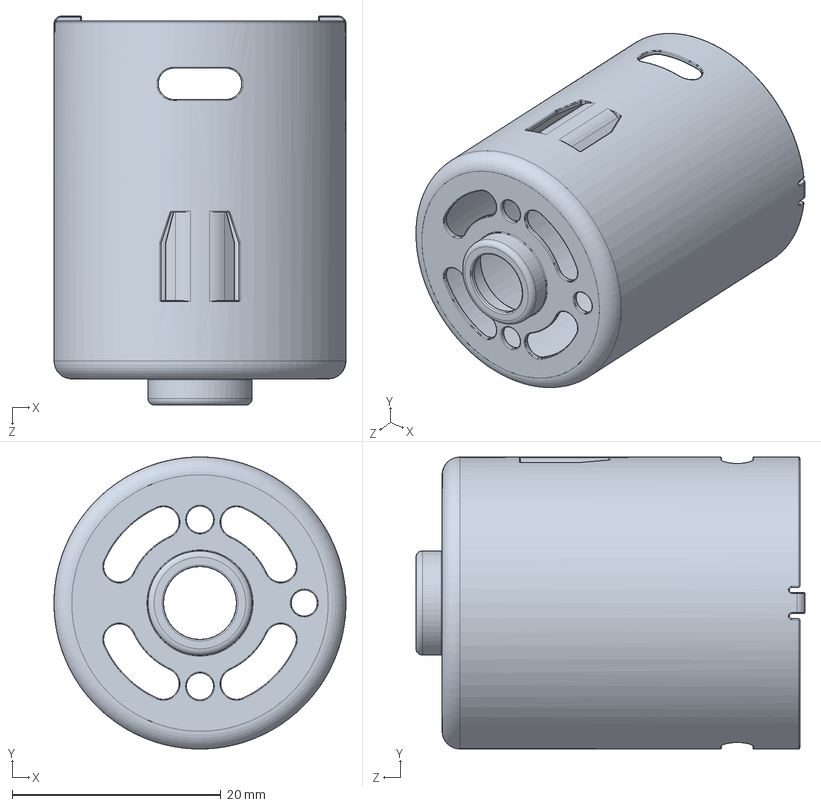
[picture p70: CAD file, 2025-05-29]
機械設計/00既製品/RS380/ケース.SLDPRT
28.0 x 28.0 x 37.3 mm
