KatsukiOishi/HikkiKomori/機械設計/00既製品/SCCN6-6/Knurled Knob_SCCN6-6.SLDPRT

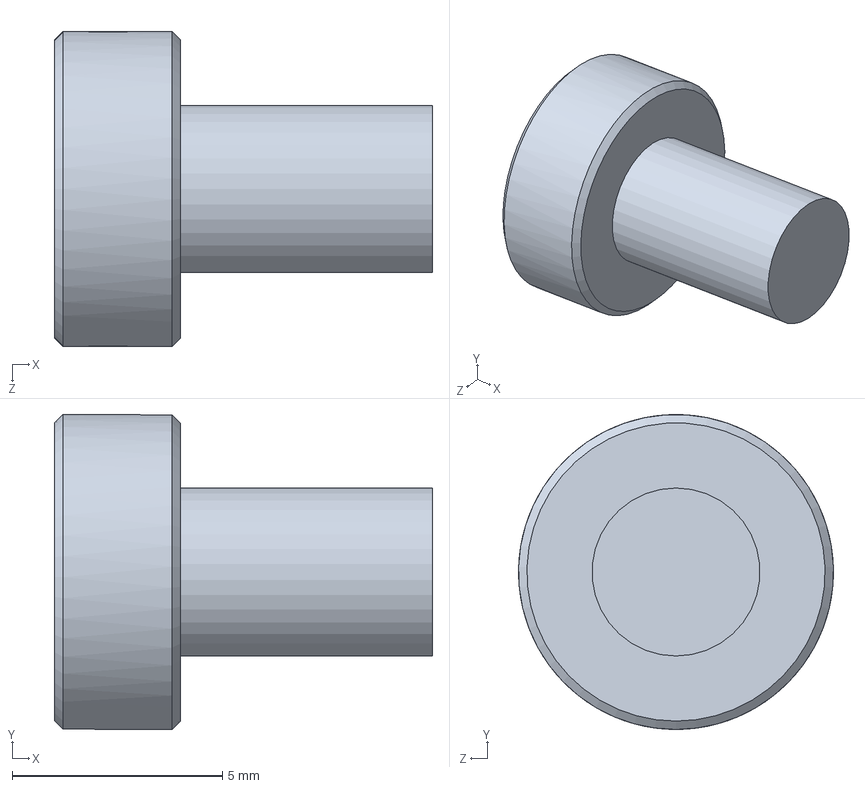
[picture p71: CAD file, 2022-06-01]
機械設計/00既製品/SCCN6-6/Knurled Knob_SCCN6-6.SLDPRT
9.00 x 7.50 x 7.50 mm
