KatsukiOishi/HikkiKomori/機械設計/01足機構/02足機構共通部品/足機構固定板.sldprt

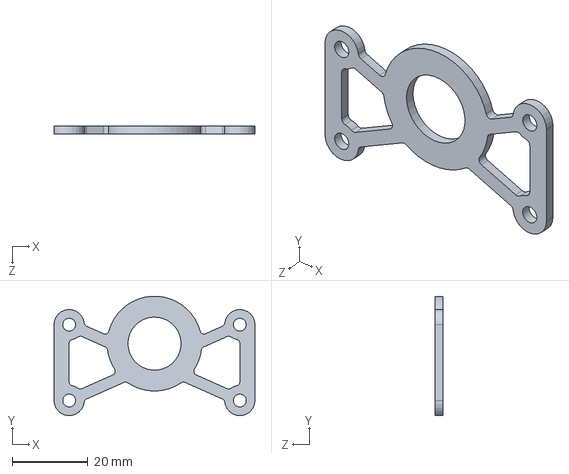
[picture p72: CAD file, 2025-05-29]
機械設計/01足機構/02足機構共通部品/足機構固定板.sldprt
53.0 x 31.5 x 2.00 mm
