KatsukiOishi/HikkiKomori/機械設計/02中央ユニット/中央フレーム.SLDPRT

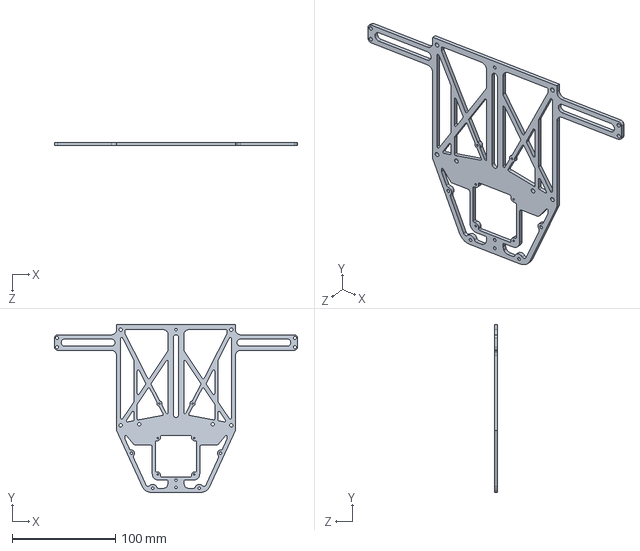
[picture p73: CAD file, 2025-05-29]
機械設計/02中央ユニット/中央フレーム.SLDPRT
235.0 x 162.5 x 3.00 mm
