KatsukiOishi/HikkiKomori/機械設計/03腕機構/01減速機構/入力減速部/入力歯車.SLDPRT

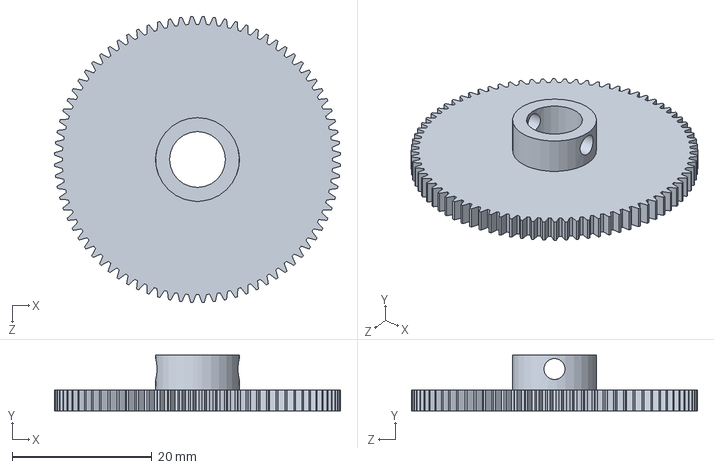
[picture p74: CAD file, 2022-06-01]
機械設計/03腕機構/01減速機構/入力減速部/入力歯車.SLDPRT
41.0 x 8.00 x 41.0 mm
