KatsukiOishi/HikkiKomori/機械設計/03腕機構/01減速機構/内接減速機/内軸.SLDPRT

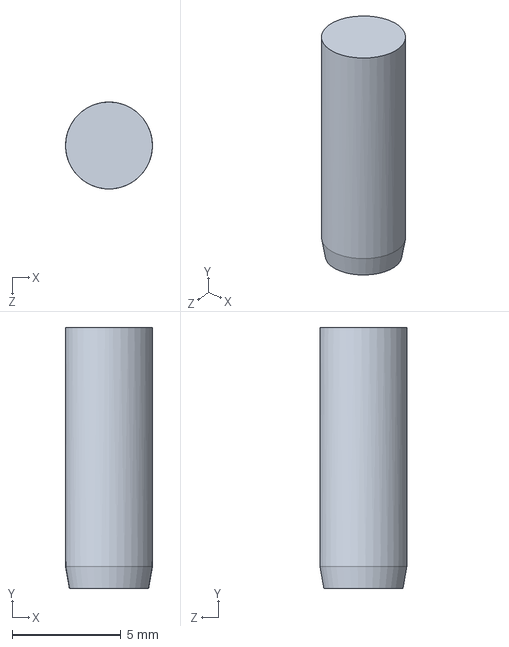
[picture p75: CAD file, 2025-05-29]
機械設計/03腕機構/01減速機構/内接減速機/内軸.SLDPRT
4.00 x 12.0 x 4.00 mm
