KatsukiOishi/HikkiKomori/機械設計/03腕機構/02アームリンク/従動節根本軸.SLDPRT

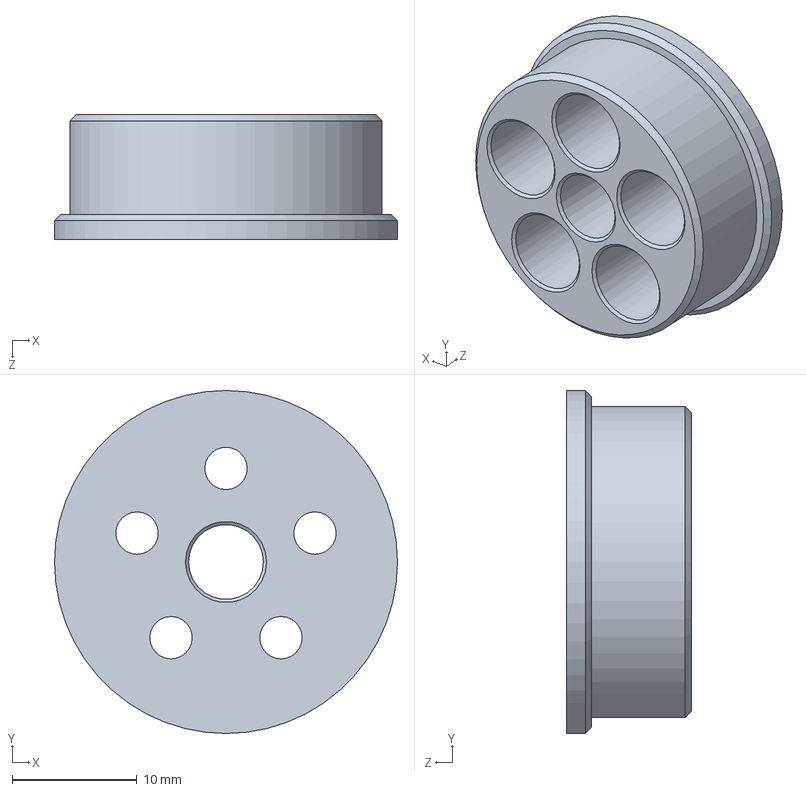
[picture p76: CAD file, 2025-05-29]
機械設計/03腕機構/02アームリンク/従動節根本軸.SLDPRT
27.5 x 27.5 x 10.0 mm
