KatsukiOishi/HikkiKomori/機械設計/05リンクサス/リンクサス中央軸部.SLDPRT

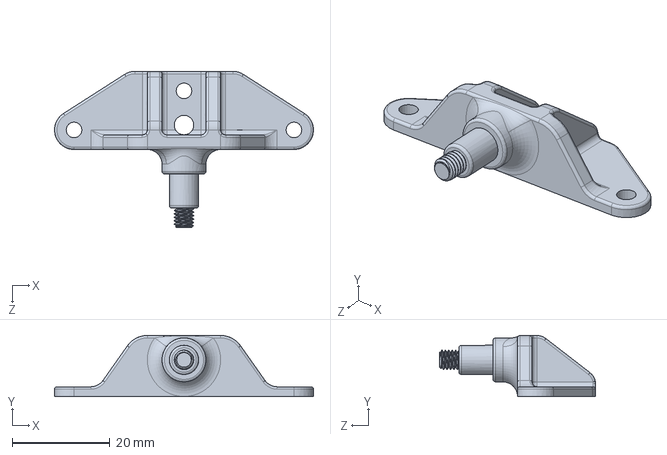
[picture p77: CAD file, 2025-05-29]
機械設計/05リンクサス/リンクサス中央軸部.SLDPRT
53.0 x 12.5 x 32.0 mm
