KatsukiOishi/HikkiKomori/機械設計/00既製品/B6805ZZ.SLDPRT

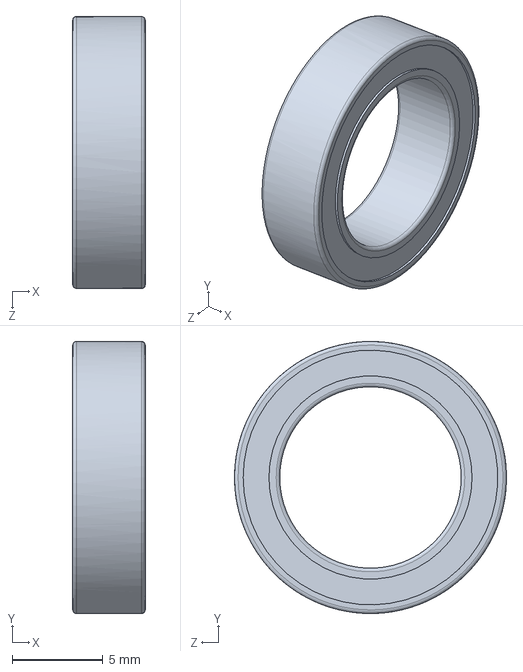
[picture p78: CAD file, 2025-05-29]
機械設計/00既製品/B6805ZZ.SLDPRT
4.00 x 15.0 x 15.0 mm
