KatsukiOishi/HikkiKomori/機械設計/00既製品/RS380/Eixo12V.SLDPRT

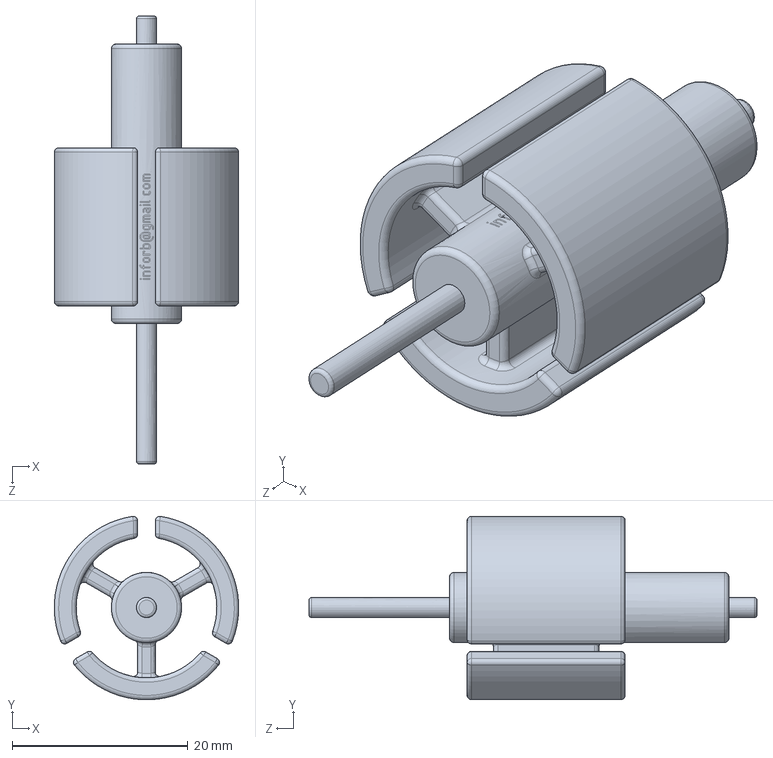
[picture p79: CAD file, 2025-05-29]
機械設計/00既製品/RS380/Eixo12V.SLDPRT
21.0 x 20.9 x 51.0 mm
