KatsukiOishi/HikkiKomori/機械設計/01足機構/02足機構共通部品/足側板.sldprt

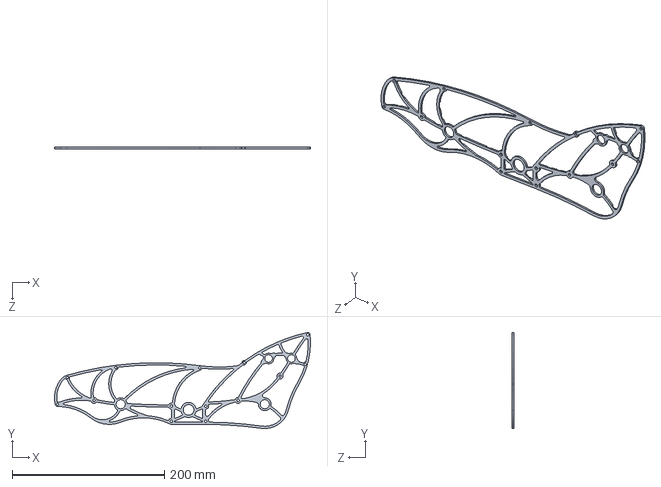
[picture p80: CAD file, 2025-05-29]
機械設計/01足機構/02足機構共通部品/足側板.sldprt
335.9 x 126.2 x 2.00 mm
