KatsukiOishi/HikkiKomori/機械設計/02中央ユニット/中央ユニット.SLDASM

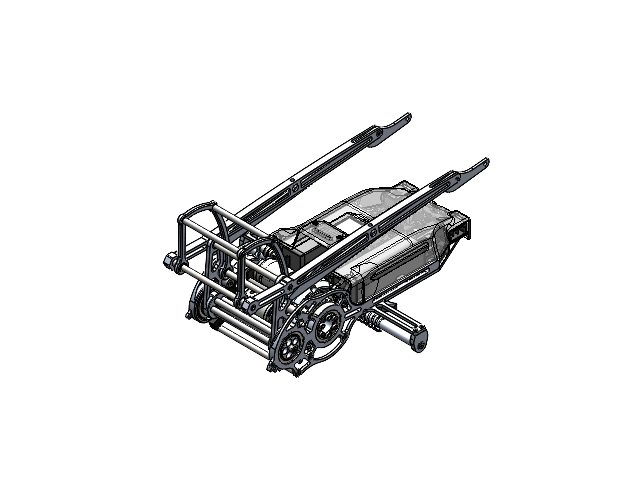
[picture p81: CAD file, 2025-05-29]
機械設計/02中央ユニット/中央ユニット.SLDASM
中央フレーム
中央ユニット主軸
横展開抜止め x 2
MAIN BODY_CFS0.4
DRUM_CFS0.4
VUY10-55 x 2
VUR16-55 x 2
CBSTBR3-6 x 18
足駆動回路放熱板
MPBZ6-15 x 2
展開機構ブロック
抑制鍵
ARL-360BE x 2
CBSTBR3-10 x 29
WSJK8-3-2 x 2
小型ファン
CBSTBR2-5 x 10
右足駆動回路v2
左足駆動回路v2
電源基盤 v5
制御基板 v4
BRL-2011SBE x 4
BRL-311SBE
CBSTSR4-8 x 7
F3-2100 x 2
内歯車
内接歯車機構躯体
出力板
内軸 x 8
曲軸
B6809ZZ
B676ZZ
B6800ZZ
B6802ZZ
Spur Gears_GEFHBB0.5-80-5-15-W0-LFC27-M6
BFLB4-5 x 8
B6700ZZ
ケース x 3
Bucha12V x 3
Mancal12V x 3
Terminal12V x 6
Eixo12V x 3
Enrolamento12V x 9
磁石 x 6
SS0.5-10 x 3
腕電動機取付板
腕機構回路放熱板
腕駆動回路v2
CB2.6-5 x 6
CL-315BE x 4
ARL-340BE x 3
B6805ZZ x 3
Rotary Shaft_SFHRW6-103.0-M3-N3 x 2
Rotary Shaft_SFRHH6-109.0-F2.5-P5-T2.5-M3 x 2
FWSJW-D8-V6-T6.0 x 2
中関節 x 2
BFLB6-5 x 6
ABETTF6-75.0-M3-N3 x 2
駆動節歯車付き
従動節根本軸 x 2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
