KatsukiOishi/HikkiKomori/機械設計/03腕機構/01減速機構/腕機構減速機.SLDASM

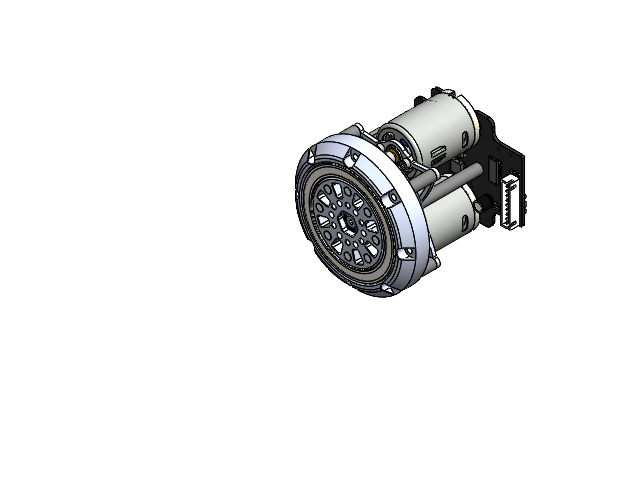
[picture p82: CAD file, 2025-05-29]
機械設計/03腕機構/01減速機構/腕機構減速機.SLDASM
内歯車
内接歯車機構躯体
出力板
内軸 x 8
曲軸
B6809ZZ
B676ZZ
B6800ZZ
B6802ZZ
Spur Gears_GEFHBB0.5-80-5-15-W0-LFC27-M6
BFLB4-5 x 8
CBSTSR4-8
B6700ZZ
ケース x 3
Bucha12V x 3
Mancal12V x 3
Terminal12V x 6
Eixo12V x 3
Enrolamento12V x 9
磁石 x 6
SS0.5-10 x 3
腕電動機取付板
腕機構回路放熱板
腕駆動回路v2
CB2.6-5 x 6
CL-315BE x 4
ARL-340BE x 3
