KatsukiOishi/HikkiKomori/機械設計/_CAM/CAM_T2_3.SLDASM

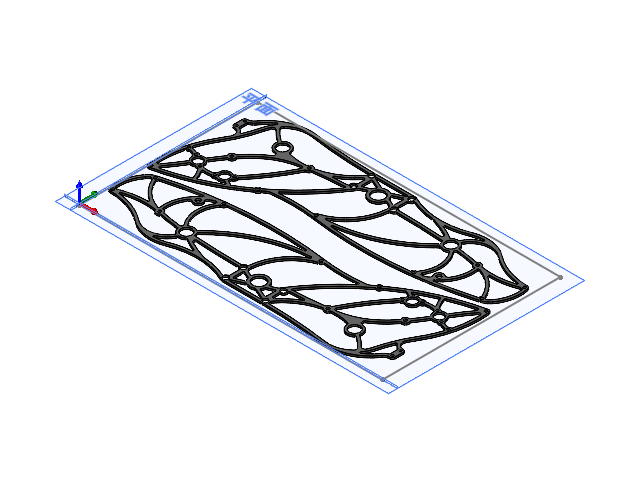
[picture p83: CAD file, 2023-08-18]
機械設計/_CAM/CAM_T2_3.SLDASM
足側板 x 2
