KatsukiOishi/HikkiKomori/機械設計/00既製品/SCCN6-6/SCCN6-6.SLDASM

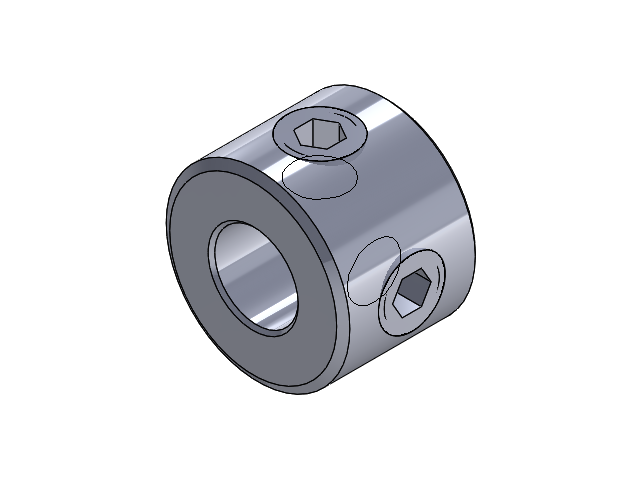
[picture p84: CAD file, 2025-05-29]
機械設計/00既製品/SCCN6-6/SCCN6-6.SLDASM
Shaft Collar_SCCN6-6
Set Screw-1_SCCN6-6 x 2
