KatsukiOishi/HikkiKomori/機械設計/01足機構/02足機構共通部品/足中間歯車1.SLDASM

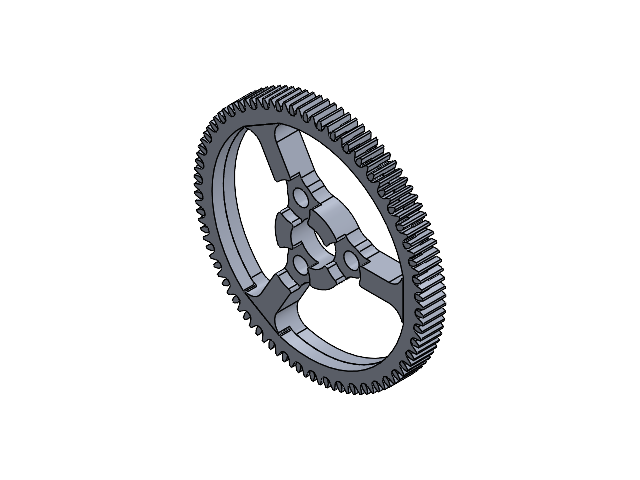
[picture p85: CAD file, 2025-05-29]
機械設計/01足機構/02足機構共通部品/足中間歯車1.SLDASM
足中間歯車1 x 2
