KatsukiOishi/HikkiKomori/機械設計/02中央ユニット/01展開機構/展開機構.sldasm

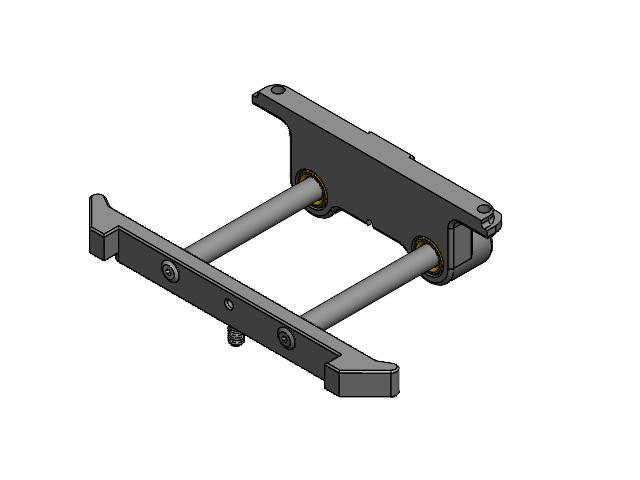
[picture p86: CAD file, 2025-05-29]
機械設計/02中央ユニット/01展開機構/展開機構.sldasm
MPBZ6-15 x 2
展開機構ブロック
抑制鍵
ARL-360BE x 2
CBSTBR3-10 x 2
WSJK8-3-2 x 2
CBSTBR3-6 x 2
