KatsukiOishi/HikkiKomori/機械設計/03腕機構/02アームリンク/アームリンク駆動節.sldasm

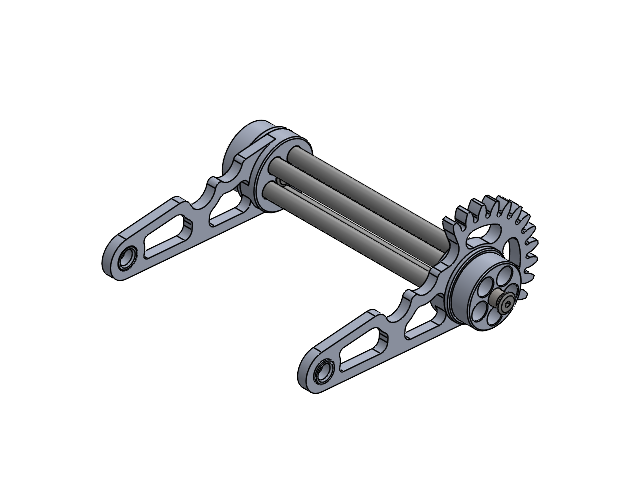
[picture p87: CAD file, 2025-05-29]
機械設計/03腕機構/02アームリンク/アームリンク駆動節.sldasm
駆動節歯車付き
従動節根本軸 x 2
BFLB6-5 x 2
駆動節
ABETTF6-90.0-M3-N3 x 5
CBSTBR3-10 x 10
DPS-C6X20 x 2
CBSTSR4-8 x 4
