KatsukiOishi/HikkiKomori/機械設計/04電子回路/電子回路ユニット.SLDASM

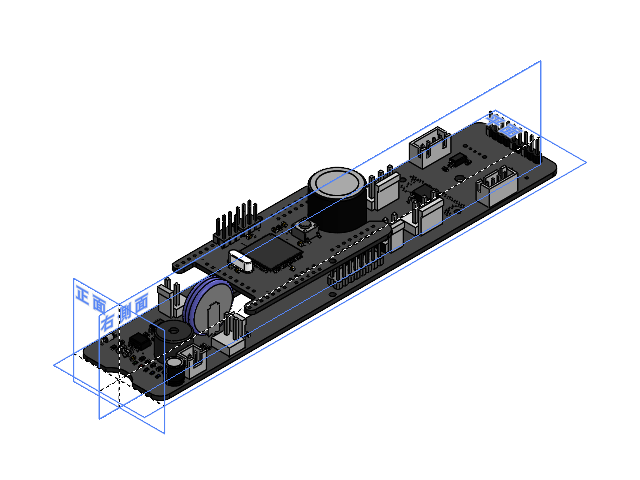
[picture p88: CAD file, 2025-05-29]
機械設計/04電子回路/電子回路ユニット.SLDASM
電源基盤 v5
制御基板 v4
