KatsukiOishi/HikkiKomori/機械設計/_CAM/CAM_CU-AAS002-P001.SLDASM

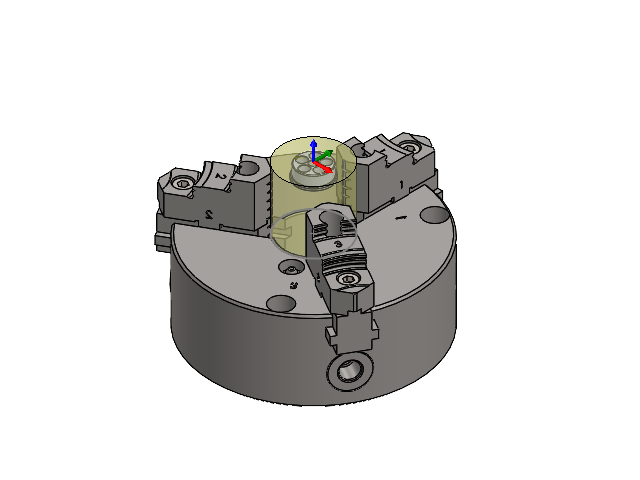
[picture p89: CAD file, 2023-08-18]
機械設計/_CAM/CAM_CU-AAS002-P001.SLDASM
従動節根本軸
JN06T102_Main
JN06T102_Main1
JN06T102_Main2
JN06T102_Main3 x 3
JN06T102_Main4
JN06T102_SubP1
六角穴付きボルト x 9
JN06T102_SLDMain x 3
JN06T102_Joe x 3
Part8^CAM_CU-AAS002-P001
