KatsukiOishi/HikkiKomori/足単体2.SLDASM

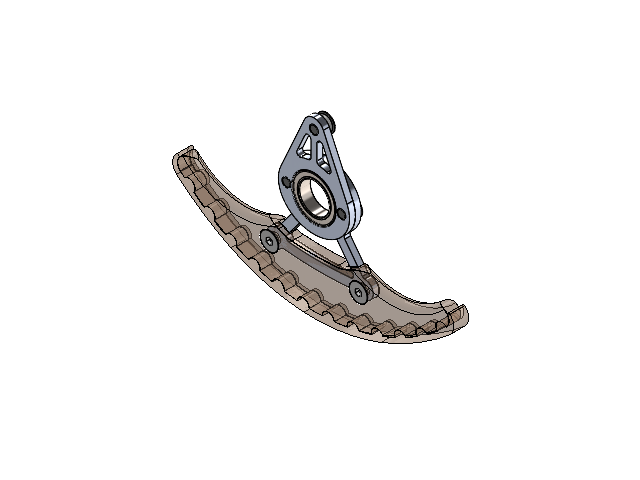
[picture p90: CAD file, 2023-08-26]
足単体2.SLDASM
足上部
足下部
B6700ZZ
SFB3-5 x 2
CBSTBR3-4 x 3
WSSB5-3-2
前足底
足ゴム
