KatsukiOishi/HikkiKomori/機械設計/01足機構/02足機構共通部品/足中間歯車.sldasm

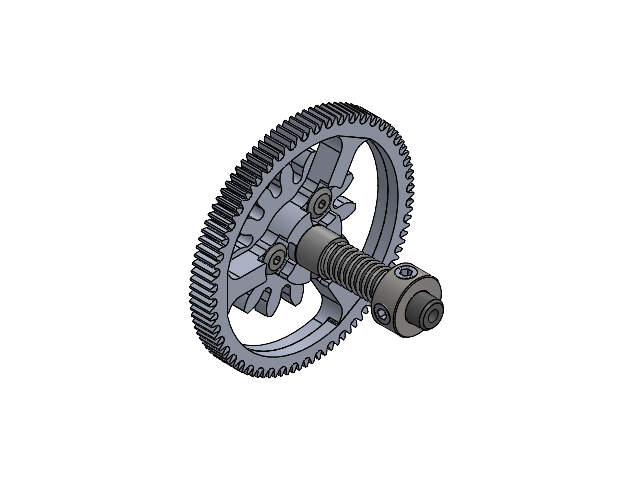
[picture p91: CAD file, 2025-05-29]
機械設計/01足機構/02足機構共通部品/足中間歯車.sldasm
足中間歯車2
MPBRU6-8
足中間歯車1 x 2
CBSTBR3-6 x 3
ARL-340BE
WSSB8-6-1.5
FWSJW-D8-V6-T5.5
VUR6-20
Shaft Collar_SCCN6-6
Set Screw-1_SCCN6-6 x 2
