KatsukiOishi/HikkiKomori/機械設計/02中央ユニット/中央躯体.sldasm

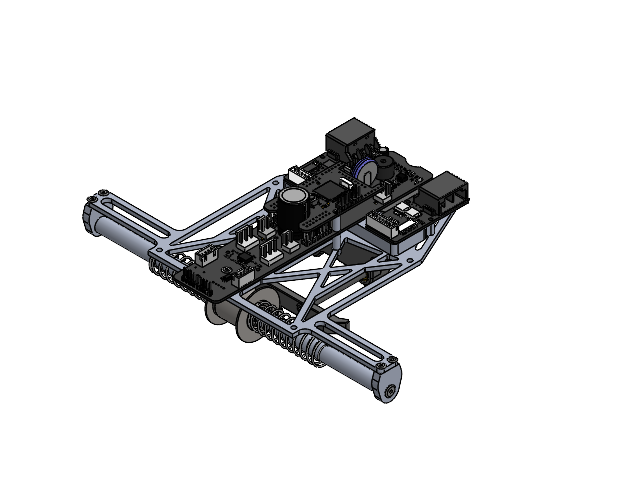
[picture p92: CAD file, 2025-05-29]
機械設計/02中央ユニット/中央躯体.sldasm
中央フレーム
中央ユニット主軸
横展開抜止め x 2
MAIN BODY_CFS0.4
DRUM_CFS0.4
VUY10-55 x 2
VUR16-55 x 2
CBSTBR3-6 x 8
足駆動回路放熱板
MPBZ6-15 x 2
展開機構ブロック
抑制鍵
ARL-360BE x 2
CBSTBR3-10 x 4
WSJK8-3-2 x 2
小型ファン
CBSTBR2-5 x 8
右足駆動回路v2
左足駆動回路v2
電源基盤 v5
制御基板 v4
BRL-2011SBE x 4
BRL-311SBE
CBSTSR4-8 x 2
