KatsukiOishi/HikkiKomori/機械設計/03腕機構/01減速機構/入力減速部/入力減速機.SLDASM

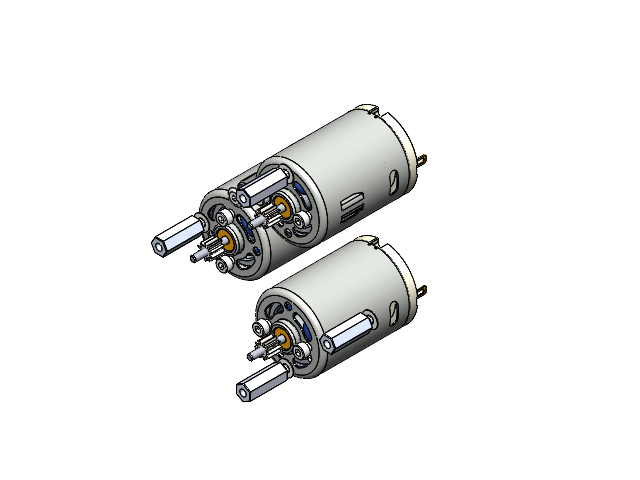
[picture p93: CAD file, 2023-07-12]
機械設計/03腕機構/01減速機構/入力減速部/入力減速機.SLDASM
ケース x 3
Bucha12V x 3
Mancal12V x 3
Terminal12V x 6
Eixo12V x 3
Enrolamento12V x 9
磁石 x 6
spur gear_jis x 3
ASL-315E x 4
CB2.6-5 x 6
CBSTBR3-6 x 5
ARL-400BE
