KatsukiOishi/HikkiKomori/機械設計/03腕機構/01減速機構/内接減速機/内接減速機構.SLDASM

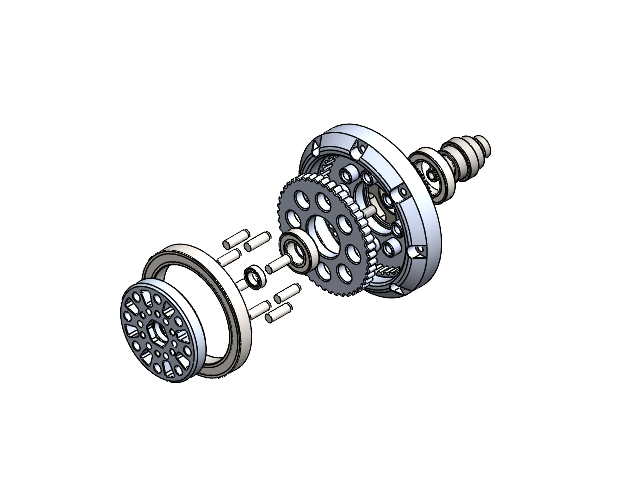
[picture p94: CAD file, 2025-05-29]
機械設計/03腕機構/01減速機構/内接減速機/内接減速機構.SLDASM
内歯車
内接歯車機構躯体
出力板
内軸 x 8
曲軸
B6809ZZ
B676ZZ
B6800ZZ
B6802ZZ
Spur Gears_GEFHBB0.5-80-5-15-W0-LFC27-M6
BFLB4-5 x 8
CBSTSR4-8
B6700ZZ
