KatsukiOishi/HikkiKomori/機械設計/03腕機構/03ロングロッド/ロングロッド.sldasm

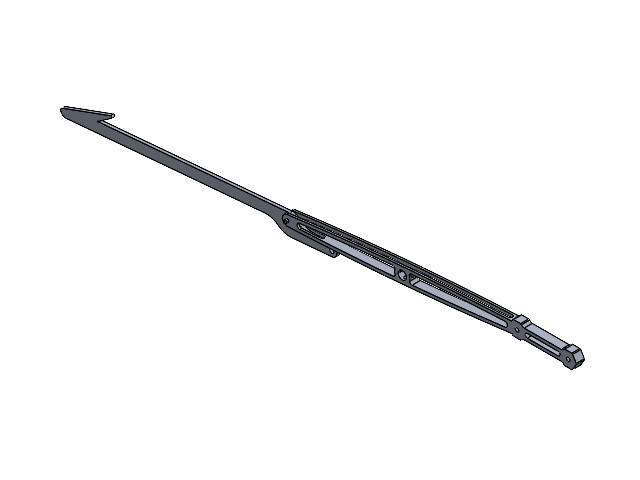
[picture p95: CAD file, 2025-05-29]
機械設計/03腕機構/03ロングロッド/ロングロッド.sldasm
従動節
ロッド先端
CL-306E
CBSTBR3-10
