KatsukiOishi/HikkiKomori/機械設計/03腕機構/腕機構.SLDASM

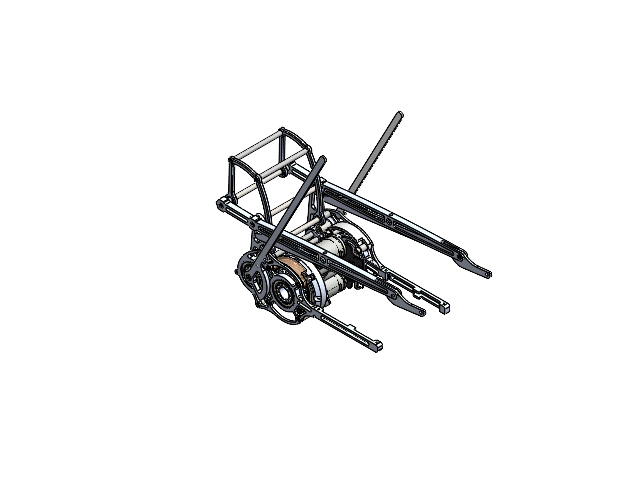
[picture p96: CAD file, 2025-05-29]
機械設計/03腕機構/腕機構.SLDASM
内歯車
内接歯車機構躯体
出力板
内軸 x 8
曲軸
B6809ZZ
B676ZZ
B6800ZZ
B6802ZZ
Spur Gears_GEFHBB0.5-80-5-15-W0-LFC27-M6
BFLB4-5 x 8
CBSTSR4-8 x 5
B6700ZZ
ケース x 3
Bucha12V x 3
Mancal12V x 3
Terminal12V x 6
Eixo12V x 3
Enrolamento12V x 9
磁石 x 6
SS0.5-10 x 3
腕電動機取付板
腕機構回路放熱板
腕駆動回路v2
CB2.6-5 x 6
CL-315BE x 4
ARL-340BE x 3
B6805ZZ x 3
Rotary Shaft_SFHRW6-103.0-M3-N3 x 2
CBSTBR3-10 x 20
Rotary Shaft_SFRHH6-109.0-F2.5-P5-T2.5-M3 x 2
FWSJW-D8-V6-T6.0 x 2
中関節 x 2
BFLB6-5 x 6
ABETTF6-75.0-M3-N3 x 2
駆動節歯車付き
従動節根本軸 x 2
駆動節
ABETTF6-90.0-M3-N3 x 5
DPS-C6X20 x 2
従動節 x 2
CL-306E x 2
ロッド先端 x 2
CLJW6-8-12.0 x 2
最終段ピニオン
腕機構内壁 x 2
CBSTBR3-6 x 10
YDH3007C05F
SS_10GL13_BASE x 2
SS_10GL13_ACTUATOR x 2
Rotary Shaft_SFRMGH8-15.0-F2.8-P6-T4.9-M3 x 6
CBSTBR2-10 x 4
PJLS10-5 x 2
カウンターアーム
腕機構カバー
Mirrorカウンターアーム
ﾐﾗｰ腕機構カバー
