KatsukiOishi/HikkiKomori/機械設計/01足機構/01ヘッケンリンク/ヘッケンリンク.SLDASM

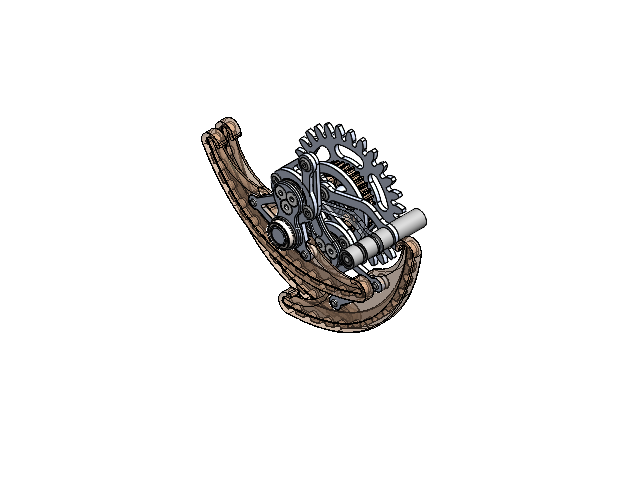
[picture p97: CAD file, 2025-05-29]
機械設計/01足機構/01ヘッケンリンク/ヘッケンリンク.SLDASM
足曲軸長偏心体 x 2
足曲軸短偏心体
足機構曲軸結合部
FL678ZZ x 2
ヘッケンリンク駆動プーリー
足プーリーフランジ
CBSTBR3-10 x 3
足プーリー中心軸
SFB3-10 x 9
足上部 x 3
足下部 x 3
B6700ZZ x 3
SFB3-5 x 6
CBSTBR3-4 x 9
WSSB5-3-2 x 3
前足底 x 3
足ゴム x 3
FWSJW-D8-V6-T6.0 x 2
CLJW6-8-15.5
FWSJW-D8-V6-T5.5
足レバー x 3
ARL-400BE
