KatsukiOishi/HikkiKomori/機械設計/01足機構/左半身機構.SLDASM

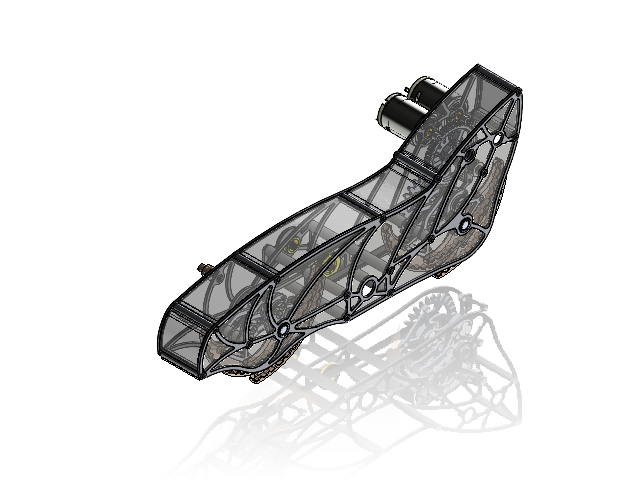
[picture p98: CAD file, 2025-05-29]
機械設計/01足機構/左半身機構.SLDASM
足曲軸長偏心体 x 4
足曲軸短偏心体 x 2
足機構曲軸結合部 x 2
FL678ZZ x 4
ヘッケンリンク駆動プーリー x 2
足プーリーフランジ x 2
CBSTBR3-10 x 7
足プーリー中心軸 x 2
SFB3-10 x 18
足上部 x 6
足下部 x 6
前足底 x 6
B6700ZZ x 6
SFB3-5 x 12
CBSTBR3-4 x 18
WSSB5-3-2 x 6
足ゴム x 6
FWSJW-D8-V6-T6.0 x 4
CLJW6-8-15.5 x 2
FWSJW-D8-V6-T5.5 x 3
足レバー x 6
ARL-400BE x 2
HTBN474S3M-60
足側板 x 2
ケース x 2
Bucha12V x 2
Mancal12V x 2
Terminal12V x 4
Eixo12V x 2
Enrolamento12V x 6
磁石 x 4
足中間歯車2
MPBRU6-8
足中間歯車1 x 2
CBSTBR3-6 x 31
ARL-340BE x 8
WSSB8-6-1.5
VUR6-20
Shaft Collar_SCCN6-6
Set Screw-1_SCCN6-6 x 2
CB2.6-5 x 4
SS0.5-10 x 2
左足機構側面充填樹脂
足機構固定板
MPFZ10-8 x 2
足機構主柱 x 4
CLJW6-8-40.0 x 4
CLJW6-8-38.0 x 4
足機構上面カバー
リンクサス足側軸部
カウンターアームロック
