KatsukiOishi/HikkiKomori/機械設計/_CAM/CAM_CU-SAS002-P001.SLDASM

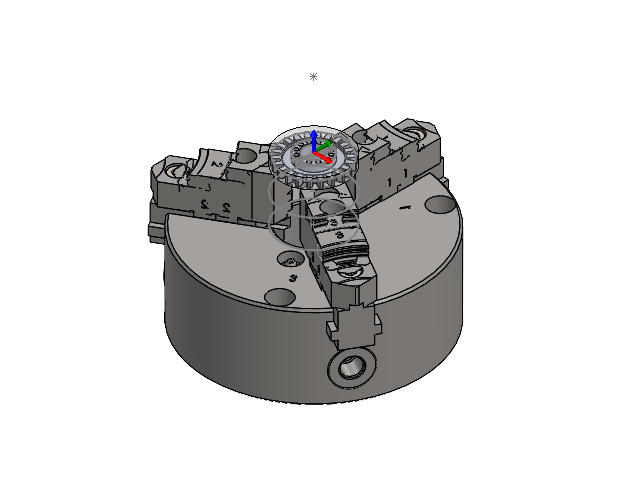
[picture p99: CAD file, 2023-08-18]
機械設計/_CAM/CAM_CU-SAS002-P001.SLDASM
JN06T102_Main
JN06T102_Main1
JN06T102_Main2
JN06T102_Main3 x 3
JN06T102_Main4
JN06T102_SubP1
六角穴付きボルト x 9
JN06T102_SLDMain x 3
JN06T102_Joe x 6
最終段ピニオン
Part2^CAM_CU-SAS002-P001
