KatsukiOishi/HikkiKomori/機械設計/01足機構/01ヘッケンリンク/足単体.SLDASM

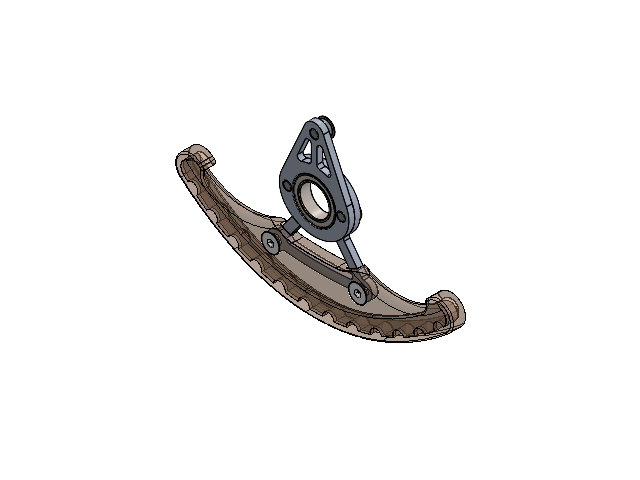
[picture p100: CAD file, 2025-05-29]
機械設計/01足機構/01ヘッケンリンク/足単体.SLDASM
足上部
足下部
B6700ZZ
SFB3-5 x 2
CBSTBR3-4 x 3
WSSB5-3-2
前足底
足ゴム
