KatsukiOishi/HikkiKomori/機械設計/_CAM/CAM_T12_1.SLDASM

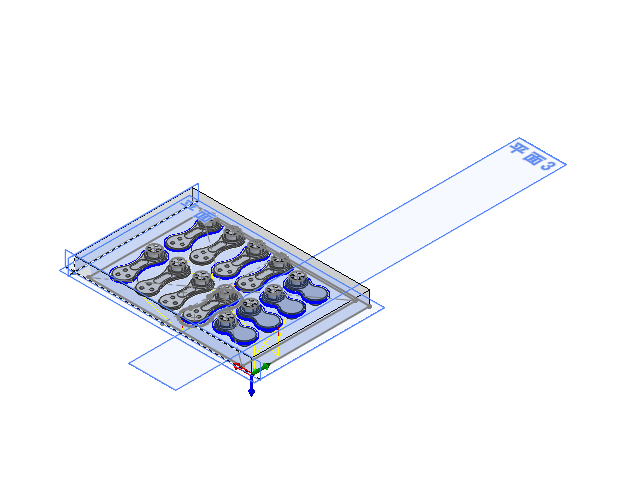
[picture p101: CAD file, 2023-08-18]
機械設計/_CAM/CAM_T12_1.SLDASM
足曲軸長偏心体 x 8
足曲軸短偏心体 x 4
Part3^CAM_T12_1
