KatsukiOishi/HikkiKomori/機械設計/03腕機構/02アームリンク/アームリンク中関節.sldasm

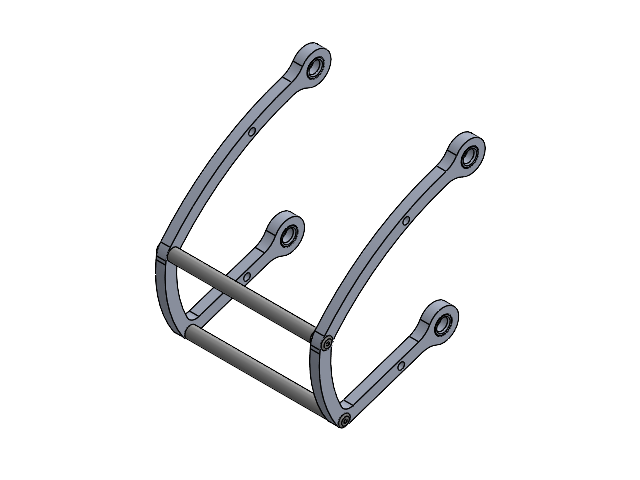
[picture p103: CAD file, 2025-05-29]
機械設計/03腕機構/02アームリンク/アームリンク中関節.sldasm
中関節 x 2
BFLB6-5 x 4
ABETTF6-75.0-M3-N3 x 2
CBSTBR3-10 x 4
