KatsukiOishi/HikkiKomori/機械設計/_CAM/CAM_T5_1.SLDASM

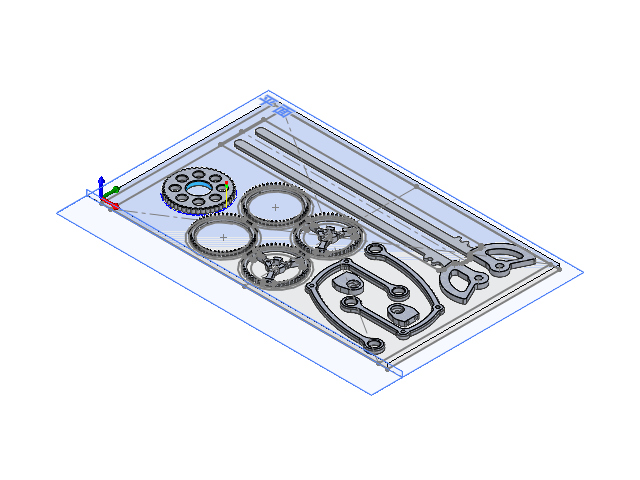
[picture p104: CAD file, 2023-08-18]
機械設計/_CAM/CAM_T5_1.SLDASM
中関節 x 2
カウンターアーム
ﾐﾗｰカウンターアーム
横展開抜止め x 2
足中間歯車1 x 4
内歯車
Part1^CAM_T5_1
