KatsukiOishi/HikkiKomori/機械設計/_CAM/CAM_T3_3.SLDASM

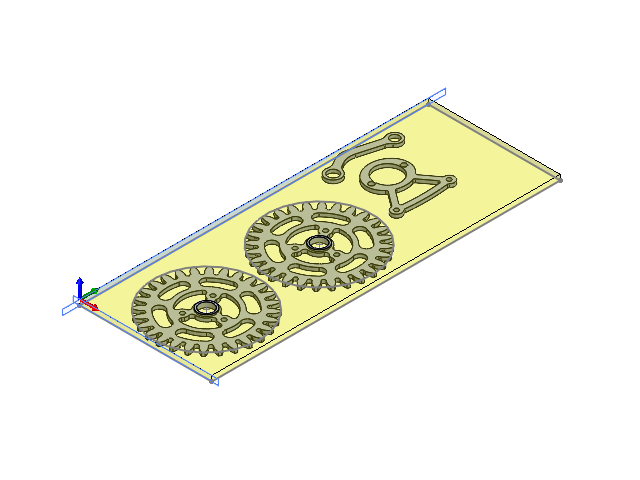
[picture p105: CAD file, 2023-08-18]
機械設計/_CAM/CAM_T3_3.SLDASM
足プーリーフランジ x 2
足レバー
足下部
