KatsukiOishi/HikkiKomori/機械設計/_CAM/CAM_T2_2.SLDASM

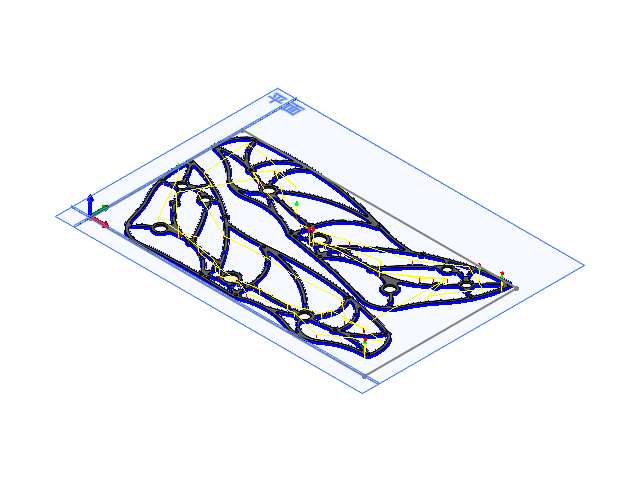
[picture p106: CAD file, 2023-07-30]
機械設計/_CAM/CAM_T2_2.SLDASM
足側板 x 2
