KatsukiOishi/HikkiKomori/機械設計/_CAM/CAM_T2_1.SLDASM

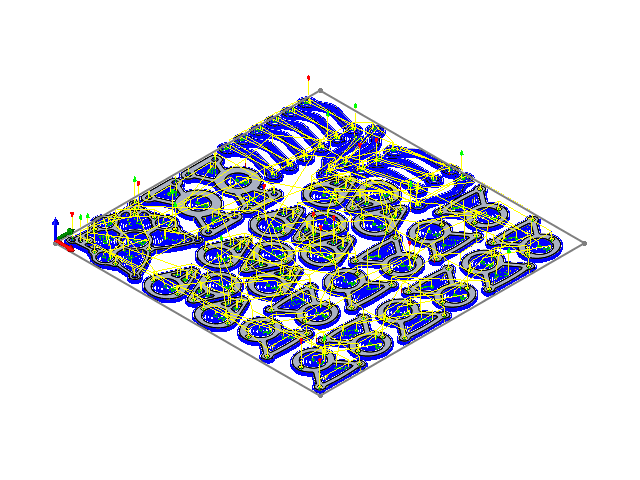
[picture p107: CAD file, 2023-07-28]
機械設計/_CAM/CAM_T2_1.SLDASM
腕電動機取付板
足上部 x 12
足下部 x 12
足機構固定板 x 2
足レバー x 12
