KatsukiOishi/HikkiKomori/機械設計/_CAM/CAM_T3_2.SLDASM

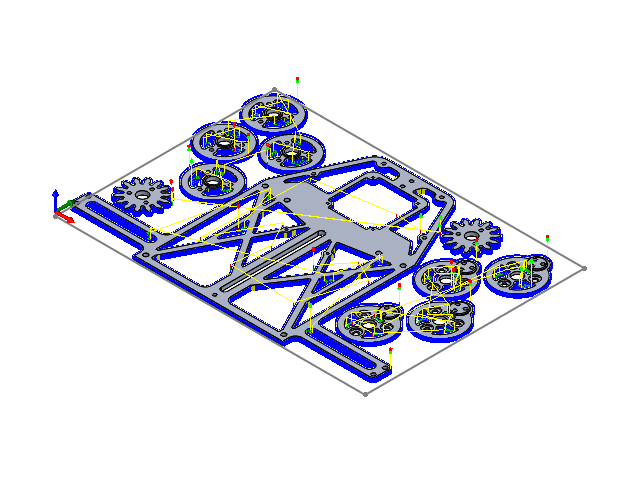
[picture p108: CAD file, 2023-07-28]
機械設計/_CAM/CAM_T3_2.SLDASM
中央フレーム
足プーリーフランジ x 4
足中間歯車2 x 2
足機構曲軸結合部 x 4
