KatsukiOishi/HikkiKomori/機械設計/01足機構/01ヘッケンリンク/右側足単体.SLDASM

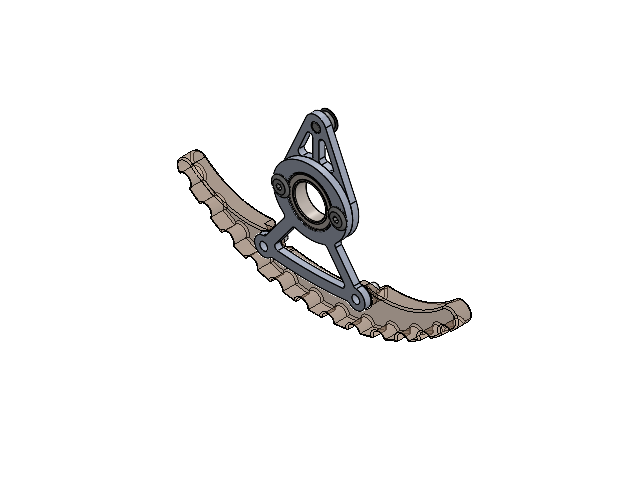
[picture p109: CAD file, 2023-08-18]
機械設計/01足機構/01ヘッケンリンク/右側足単体.SLDASM
足上部
足下部
前足底
B6700ZZ
SFB3-5 x 2
CBSTBR3-4 x 3
WSSB5-3-2
