KatsukiOishi/HikkiKomori/機械設計/_CAM/CAM_T3_1.SLDASM

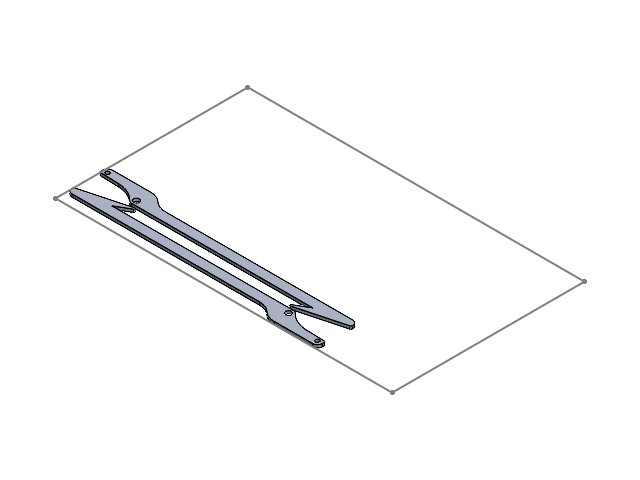
[picture p110: CAD file, 2023-07-18]
機械設計/_CAM/CAM_T3_1.SLDASM
ロッド先端 x 2
