KatsukiOishi/HikkiKomori/(list of files, cad)

Other CAD files:
機械設計/04電子回路/_元データ/制御回路v4/Packages.SLDASM.SLDASM
機械設計/04電子回路/_元データ/電源回路v5/SOD-123.SLDASM
機械設計/びしゃもん.SLDASM
電子回路設計/3D化/足駆動回路v2/左足駆動回路v2.SLDASM
機械設計/04電子回路/_元データ/制御基板v2/Packages.SLDASM
電子回路設計/3D化/レシーバv1/Packages.sldasm
電子回路設計/3D化/腕駆動回路v2/Packages.sldasm
機械設計/04電子回路/01足回路基板/足駆動回路.SLDASM
機械設計/04電子回路/01足回路基板/Packages.sldasm
電子回路設計/3D化/腕駆動回路v2/腕駆動回路.SLDASM
機械設計/04電子回路/01足回路基板/足駆動回路 v1.SLDASM
電子回路設計/3D化/足駆動回路v2/Packages.sldasm
機械設計/04電子回路/_元データ/電源回路v5/Packages.SLDASM
機械設計/03腕機構/03ロングロッド/ロッド先端.SLDPRT
機械設計/03腕機構/04カウンターアーム/Mirrorカウンターアーム.SLDPRT
機械設計/04電子回路/01足回路基板/右足駆動回路v2.SLDPRT
機械設計/04電子回路/02腕駆動回路/腕駆動回路v2.SLDPRT
機械設計/04電子回路/03電源基盤/電源基盤v1.SLDPRT
機械設計/04電子回路/04レシーバ/レシーバ v1.SLDPRT
機械設計/04電子回路/_元データ/制御基板v2/2X03.SLDPRT
電子回路設計/3D化/レシーバv1/B9B-XH-A.sldprt
電子回路設計/3D化/腕駆動回路v2/SOP20.sldprt
機械設計/00既製品/GEFHBB0.5-80-5-15-W0-LFC27-M6/Spur Gears_GEFHBB0.5-80-5-15-W0-LFC27-M6.SLDPRT
機械設計/00既製品/SFHRW6-103.0-M3-N3/Rotary Shaft_SFHRW6-103.0-M3-N3.SLDPRT
機械設計/00既製品/SFRHH6-109.0-F2.5-P5-T2.5-M3/Rotary Shaft_SFRHH6-109.0-F2.5-P5-T2.5-M3.SLDPRT
機械設計/00既製品/SFRMGH8-15.0-F2.8-P6-T4.9-M3/Rotary Shaft_SFRMGH8-15.0-F2.8-P6-T4.9-M3.SLDPRT
機械設計/03腕機構/04カウンターアーム/ﾐﾗｰカウンターアーム.SLDPRT
機械設計/04電子回路/01足回路基板/左足駆動回路v2.SLDPRT
機械設計/04電子回路/_元データ/制御回路v4/TS-06104.SLDPRT.SLDPRT
機械設計/04電子回路/_元データ/制御基板v2/R0603.SLDPRT
機械設計/04電子回路/_元データ/電源回路v5/pin.SLDPRT
電子回路設計/3D化/レシーバv1/Board.sldprt
電子回路設計/3D化/腕駆動回路v2/B3B-XH-A.sldprt
機械設計/04電子回路/01足回路基板/ﾐﾗｰ足駆動回路.SLDPRT
機械設計/04電子回路/_元データ/制御回路v4/R0603.SLDPRT.SLDPRT
機械設計/04電子回路/_元データ/制御基板v2/TS-06104.SLDPRT
機械設計/04電子回路/_元データ/電源回路v5/TS-0606-F-N.SLDPRT
電子回路設計/3D化/レシーバv1/R3006B.sldprt
電子回路設計/3D化/腕駆動回路v2/BTN9990LV.sldprt
機械設計/00既製品/SFHRW6-103.0-M3-N3/Retaining Ring C Ex-1_SFHRW6-103.0-M3-N3.SLDPRT
機械設計/00既製品/SFRHH6-109.0-F2.5-P5-T2.5-M3/Retaining Ring E Ex-1_SFRHH6-109.0-F2.5-P5-T2.5-M3.SLDPRT
機械設計/00既製品/SFRMGH8-15.0-F2.8-P6-T4.9-M3/Retaining Ring E Ex-2_SFRMGH8-15.0-F2.8-P6-T4.9-M3.SLDPRT
機械設計/03腕機構/01減速機構/ﾐﾗｰ腕機構カバー.SLDPRT
機械設計/04電子回路/01足回路基板/R0603.sldprt
機械設計/04電子回路/_元データ/制御回路v4/Board.SLDPRT.SLDPRT
機械設計/04電子回路/_元データ/電源回路v5/SOT95P240X110-3N.SLDPRT
電子回路設計/3D化/足駆動回路v2/R0603.sldprt
機械設計/00既製品/SFRHH6-109.0-F2.5-P5-T2.5-M3/Retaining Ring E Ex-2_SFRHH6-109.0-F2.5-P5-T2.5-M3.SLDPRT
機械設計/00既製品/SFRMGH8-15.0-F2.8-P6-T4.9-M3/Retaining Ring C Ex-3_SFRMGH8-15.0-F2.8-P6-T4.9-M3.SLDPRT
機械設計/01足機構/右足機構側面充填樹脂.sldprt
曲軸.SLDDRW
機械設計/00図面/CGA75_内接減速機構.SLDDRW
機械設計/00図面/CU-AAS001_アームリンク中関節.SLDDRW
機械設計/00図面/CU-AAS002_アームリンク駆動節.SLDDRW
機械設計/00図面/CU-AAS003L_ロングロッド.SLDDRW
機械設計/00図面/CU-AAS003R_ロングロッド.SLDDRW
機械設計/00図面/CU-SAS0002-P001_腕機構内壁.SLDDRW
機械設計/00図面/CU-SAS0002-P003_腕機構内壁.SLDDRW
機械設計/00図面/CU-SAS001-P002_横展開抜止め.SLDDRW
機械設計/00図面/CU-SAS001_中央躯体.SLDDRW
機械設計/00図面/CU-SAS002-P001_最終段ピニオン.SLDDRW
機械設計/00図面/CU-SAS003_展開機構.SLDDRW
機械設計/00図面/P-P004_足機構主柱.SLDDRW
機械設計/00図面/R-HL-P003_足プーリー中心軸.SLDDRW
機械設計/00図面/R-SA-GAS001_足中間歯車1.SLDDRW
機械設計/00図面/R-SA001_足中間歯車.SLDDRW
機械設計/00図面/RL-HL-RAS001_足単体左半身.SLDDRW
機械設計/00図面/RL-HL001_ヘッケンリンク左半身後方.SLDDRW
機械設計/00図面/RL-HL002_ヘッケンリンク左半身前方.SLDDRW
機械設計/00図面/RR-HL-RAS001_足単体右半身.SLDDRW
機械設計/00図面/RR-HL001_ヘッケンリンク右半身後方.SLDDRW
機械設計/00図面/RR-HL002_ヘッケンリンク右半身前方.SLDDRW
機械設計/00図面/従動節.SLDDRW
機械設計/00既製品/ABETTF6-75.0-M3-N3.SLDPRT
機械設計/00既製品/ARL-340BE.SLDPRT
機械設計/00既製品/ARL-360BE.SLDPRT
機械設計/00既製品/B6700ZZ.SLDPRT
機械設計/00既製品/B676ZZ.SLDPRT
機械設計/00既製品/B6800ZZ.SLDPRT
機械設計/00既製品/B6802ZZ.SLDPRT
機械設計/00既製品/B6809ZZ.SLDPRT
機械設計/00既製品/BFLB4-5.SLDPRT
機械設計/00既製品/BFLB6-5.SLDPRT
機械設計/00既製品/BRL-2011SBE.SLDPRT
機械設計/00既製品/BRL-311SBE.SLDPRT
機械設計/00既製品/CB2.6-5.SLDPRT
機械設計/00既製品/CBSTBR2-10.SLDPRT
機械設計/00既製品/CBSTBR2-5.SLDPRT
機械設計/00既製品/CBSTBR3-10.SLDPRT
機械設計/00既製品/CBSTBR3-4.SLDPRT
機械設計/00既製品/CBSTBR3-6.SLDPRT
機械設計/00既製品/CBSTSR4-5.SLDPRT
機械設計/00既製品/CBSTSR4-8.SLDPRT
機械設計/00既製品/CL-306E.SLDPRT
機械設計/00既製品/CL-315BE.SLDPRT
機械設計/00既製品/CLJW6-8-12.0.SLDPRT
機械設計/00既製品/CLJW6-8-15.5.SLDPRT
機械設計/00既製品/CLJW6-8-38.0.SLDPRT
機械設計/00既製品/CLJW6-8-40.0.SLDPRT
機械設計/00既製品/F3-2100.SLDPRT
機械設計/00既製品/FL678ZZ.SLDPRT
機械設計/00既製品/FWSJW-D8-V6-T5.5.SLDPRT
機械設計/00既製品/FWSJW-D8-V6-T6.0.SLDPRT
機械設計/00既製品/GEFHBB0.5-80-5-15-W0-LFC27-M6/Set Screw-1_GEFHBB0.5-80-5-15-W0-LFC27-M6.SLDPRT
機械設計/00既製品/GEFHBB0.5-80-5-15-W0-LFC27-M6/Set Screw-2_GEFHBB0.5-80-5-15-W0-LFC27-M6.SLDPRT
機械設計/00既製品/HTBN474S3M-60.sldprt
機械設計/00既製品/MBIS2-3-2.SLDPRT
機械設計/00既製品/MPBRU6-8.SLDPRT
機械設計/00既製品/MPBZ6-15.SLDPRT
機械設計/00既製品/MPFZ10-8.SLDPRT
機械設計/00既製品/PJLS10-5.SLDPRT
機械設計/00既製品/RS380/Bucha12V.SLDPRT
機械設計/00既製品/RS380/Enrolamento12V.SLDPRT
機械設計/00既製品/RS380/磁石.SLDPRT
機械設計/00既製品/SCCN6-6/Set Screw-1_SCCN6-6.SLDPRT
機械設計/00既製品/SFB3-10.SLDPRT
機械設計/00既製品/SFB3-5.SLDPRT
機械設計/00既製品/SFRHH6-109.0-F2.5-P5-T2.5-M3/Retaining Ring C Ex-1_SFRHH6-109.0-F2.5-P5-T2.5-M3.SLDPRT
機械設計/00既製品/SFRHH6-109.0-F2.5-P5-T2.5-M3/Retaining Ring C Ex-2_SFRHH6-109.0-F2.5-P5-T2.5-M3.SLDPRT
機械設計/00既製品/SFRHH6-109.0-F2.5-P5-T2.5-M3/Retaining Ring E Ex-3_SFRHH6-109.0-F2.5-P5-T2.5-M3.SLDPRT
機械設計/00既製品/SFRMGH8-15.0-F2.8-P6-T4.9-M3/Retaining Ring C Ex-1_SFRMGH8-15.0-F2.8-P6-T4.9-M3.SLDPRT
機械設計/00既製品/SFRMGH8-15.0-F2.8-P6-T4.9-M3/Retaining Ring C Ex-2_SFRMGH8-15.0-F2.8-P6-T4.9-M3.SLDPRT
機械設計/00既製品/SFRMGH8-15.0-F2.8-P6-T4.9-M3/Retaining Ring E Ex-3_SFRMGH8-15.0-F2.8-P6-T4.9-M3.SLDPRT
機械設計/00既製品/SS-10GL13/SS_10GL13.SLDDRW
機械設計/00既製品/SS0.5-10.SLDPRT
機械設計/00既製品/VUR16-55.SLDPRT
機械設計/00既製品/VUR6-20.SLDPRT
機械設計/00既製品/VUY10-55.SLDPRT
機械設計/00既製品/WSJK8-3-2.SLDPRT
機械設計/00既製品/WSSB5-3-2.SLDPRT
機械設計/00既製品/WSSB8-6-1.5.SLDPRT
機械設計/00既製品/YDH3007C05F.SLDPRT
機械設計/00既製品/小型ファン.SLDPRT
機械設計/01足機構/01ヘッケンリンク/ヘッケンリンク駆動プーリー.SLDPRT
機械設計/01足機構/01ヘッケンリンク/前足底.SLDPRT
機械設計/01足機構/01ヘッケンリンク/足プーリーフランジ.SLDPRT
機械設計/01足機構/01ヘッケンリンク/足上部.SLDPRT
機械設計/01足機構/01ヘッケンリンク/足下部.SLDPRT
機械設計/01足機構/01ヘッケンリンク/足曲軸短偏心体.SLDPRT
機械設計/01足機構/01ヘッケンリンク/足曲軸長偏心体.SLDPRT
機械設計/01足機構/02足機構共通部品/足中間歯車1.SLDPRT
機械設計/01足機構/02足機構共通部品/足中間歯車2.SLDPRT
機械設計/01足機構/02足機構共通部品/足機構主柱.SLDPRT
機械設計/02中央ユニット/リンクサス主軸.SLDPRT
機械設計/02中央ユニット/中央ユニット主軸.SLDPRT
機械設計/02中央ユニット/中央ユニット後方カバー.sldprt
機械設計/03腕機構/01減速機構/入力減速部/JIS - Spur gear 0.5M 60T 20PA 5FW ---S60A75H50L0.8N.DXF
機械設計/03腕機構/01減速機構/入力減速部/入力減速機構取付軸.SLDPRT
機械設計/03腕機構/01減速機構/入力減速部/機体接続部品.sldprt
機械設計/03腕機構/01減速機構/入力減速部/電動機取付板.sldprt
機械設計/03腕機構/01減速機構/内接減速機/中心延長接続軸.SLDPRT
機械設計/03腕機構/01減速機構/内接減速機/中心延長接続軸固定軸.SLDPRT
機械設計/03腕機構/01減速機構/内接減速機/内接減速機結合柱.SLDPRT
機械設計/03腕機構/01減速機構/内接減速機/内歯車.SLDPRT
機械設計/03腕機構/01減速機構/内接減速機/内転がり軸.SLDPRT
機械設計/03腕機構/01減速機構/内接減速機/出力板.SLDPRT
機械設計/03腕機構/01減速機構/内接減速機/軸受板.sldprt
機械設計/03腕機構/01減速機構/図面/入力減速機.SLDDRW
機械設計/03腕機構/01減速機構/図面/内接減速機構.SLDDRW
機械設計/03腕機構/01減速機構/既製品/ねじ/MISUMI_SCB2.6-4_六角穴付ﾎﾞﾙﾄ.SLDPRT
機械設計/03腕機構/01減速機構/既製品/ねじ/MISUMI_SCB3-12_六角穴付ﾎﾞﾙﾄ.SLDPRT
機械設計/03腕機構/01減速機構/既製品/ねじ/MISUMI_SCB3-4_六角穴付ﾎﾞﾙﾄ.SLDPRT
機械設計/03腕機構/01減速機構/既製品/ねじ/MISUMI_SCB3-6_六角穴付ﾎﾞﾙﾄ.SLDPRT
機械設計/03腕機構/01減速機構/既製品/ねじ/MISUMI_SFBJ3-5_十字穴付皿小ﾈｼﾞ.SLDPRT
機械設計/03腕機構/01減速機構/既製品/座金/MISUMI_SSSLW3_ﾊﾞﾈ座金.SLDPRT
機械設計/03腕機構/01減速機構/既製品/軸受/MISUMI_B676ZZ_玉軸受.SLDPRT
機械設計/03腕機構/01減速機構/既製品/軸受/MISUMI_B6800ZZ_玉軸受.SLDPRT
機械設計/03腕機構/01減速機構/既製品/軸受/MISUMI_B6802ZZ_玉軸受.SLDPRT
機械設計/03腕機構/01減速機構/既製品/軸受/MISUMI_B6809ZZ_玉軸受.SLDPRT
機械設計/03腕機構/01減速機構/最終段支柱.SLDPRT
機械設計/03腕機構/02アームリンク/中関節.SLDPRT
機械設計/04電子回路/01足回路基板/798-HVH-280-3P-6.5DS.sldprt
機械設計/04電子回路/01足回路基板/B7B-XH-A.sldprt
機械設計/04電子回路/01足回路基板/BTN9990LV.sldprt
機械設計/04電子回路/01足回路基板/C0603.sldprt
機械設計/04電子回路/01足回路基板/C0805.sldprt
機械設計/04電子回路/01足回路基板/HVH-280-3S-HUR.SLDPRT
機械設計/04電子回路/01足回路基板/LEDC1608X39N_G.sldprt
機械設計/04電子回路/01足回路基板/SOP20.sldprt
機械設計/04電子回路/01足回路基板/足駆動回路.SLDPRT
機械設計/04電子回路/_元データ/制御回路v4/2X03.SLDPRT.SLDPRT
機械設計/04電子回路/_元データ/制御回路v4/C0603.SLDPRT.SLDPRT
機械設計/04電子回路/_元データ/制御回路v4/QFP100.SLDPRT.SLDPRT
機械設計/04電子回路/_元データ/制御回路v4/XTALRR480W50L990T368H350B.SLDPRT.SLDPRT
機械設計/04電子回路/_元データ/制御回路v4/制御基板 v4.SLDASM
機械設計/04電子回路/_元データ/制御回路v4/制御基板 v4.SLDPRT
機械設計/04電子回路/_元データ/制御回路v4/制御基板 v4.step
機械設計/04電子回路/_元データ/制御基板v2/Board.SLDPRT
機械設計/04電子回路/_元データ/制御基板v2/C0603.SLDPRT
機械設計/04電子回路/_元データ/制御基板v2/QFP100.SLDPRT
機械設計/04電子回路/_元データ/制御基板v2/XTALRR480W50L990T368H350B.SLDPRT
機械設計/04電子回路/_元データ/制御基板v2/制御基板 v2.SLDASM
機械設計/04電子回路/_元データ/制御基板v2/制御基板 v2.SLDPRT
機械設計/04電子回路/_元データ/制御基板v2/制御基板 v2.step
機械設計/04電子回路/_元データ/電源回路v5/1X09.SLDPRT
機械設計/04電子回路/_元データ/電源回路v5/2X08.SLDPRT
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
