KatsukiOishi/HikkiKomori/(threads)

Thread 37 (2024-06-11):

下カバー追加

KatsukiOishi, 2024-06-11:
<!-- Edit the body of your new issue then click the ✓ "Create Issue" button in the top right of the editor. The first line will be the issue title. Assignees and Labels follow after a blank line. Leave an empty line before beginning the body of the issue. -->

Thread 38 (2024-06-11):

正面カバー追加

KatsukiOishi, 2024-06-11:
<!-- Edit the body of your new issue then click the ✓ "Create Issue" button in the top right of the editor. The first line will be the issue title. Assignees and Labels follow after a blank line. Leave an empty line before beginning the body of the issue. -->

Thread 39 (2024-06-11):

ロングロッド展開バネの変更

KatsukiOishi, 2024-06-11:
<!-- Edit the body of your new issue then click the ✓ "Create Issue" button in the top right of the editor. The first line will be the issue title. Assignees and Labels follow after a blank line. Leave an empty line before beginning the body of the issue. -->

Thread 40 (2024-06-11):

カウンターアーム角度変更

KatsukiOishi, 2024-06-11:
<!-- Edit the body of your new issue then click the ✓ "Create Issue" button in the top right of the editor. The first line will be the issue title. Assignees and Labels follow after a blank line. Leave an empty line before beginning the body of the issue. -->

Thread 41 (2024-06-11):

電子回路の修正

KatsukiOishi, 2024-06-11:
<!-- Edit the body of your new issue then click the ✓ "Create Issue" button in the top right of the editor. The first line will be the issue title. Assignees and Labels follow after a blank line. Leave an empty line before beginning the body of the issue. -->

Thread 42 (2024-06-11):

リンクサスダサくね？

KatsukiOishi, 2024-06-11:
だって高島さん考案なんだもん...

<!-- Edit the body of your new issue then click the ✓ "Create Issue" button in the top right of the editor. The first line will be the issue title. Assignees and Labels follow after a blank line. Leave an empty line before beginning the body of the issue. -->
