KatsukiOishi/HikkiKomori/電子回路設計/制御回路/制御基板.brd

## EAGLE design 電子回路設計/制御回路/制御基板.brd (2023-08-19)

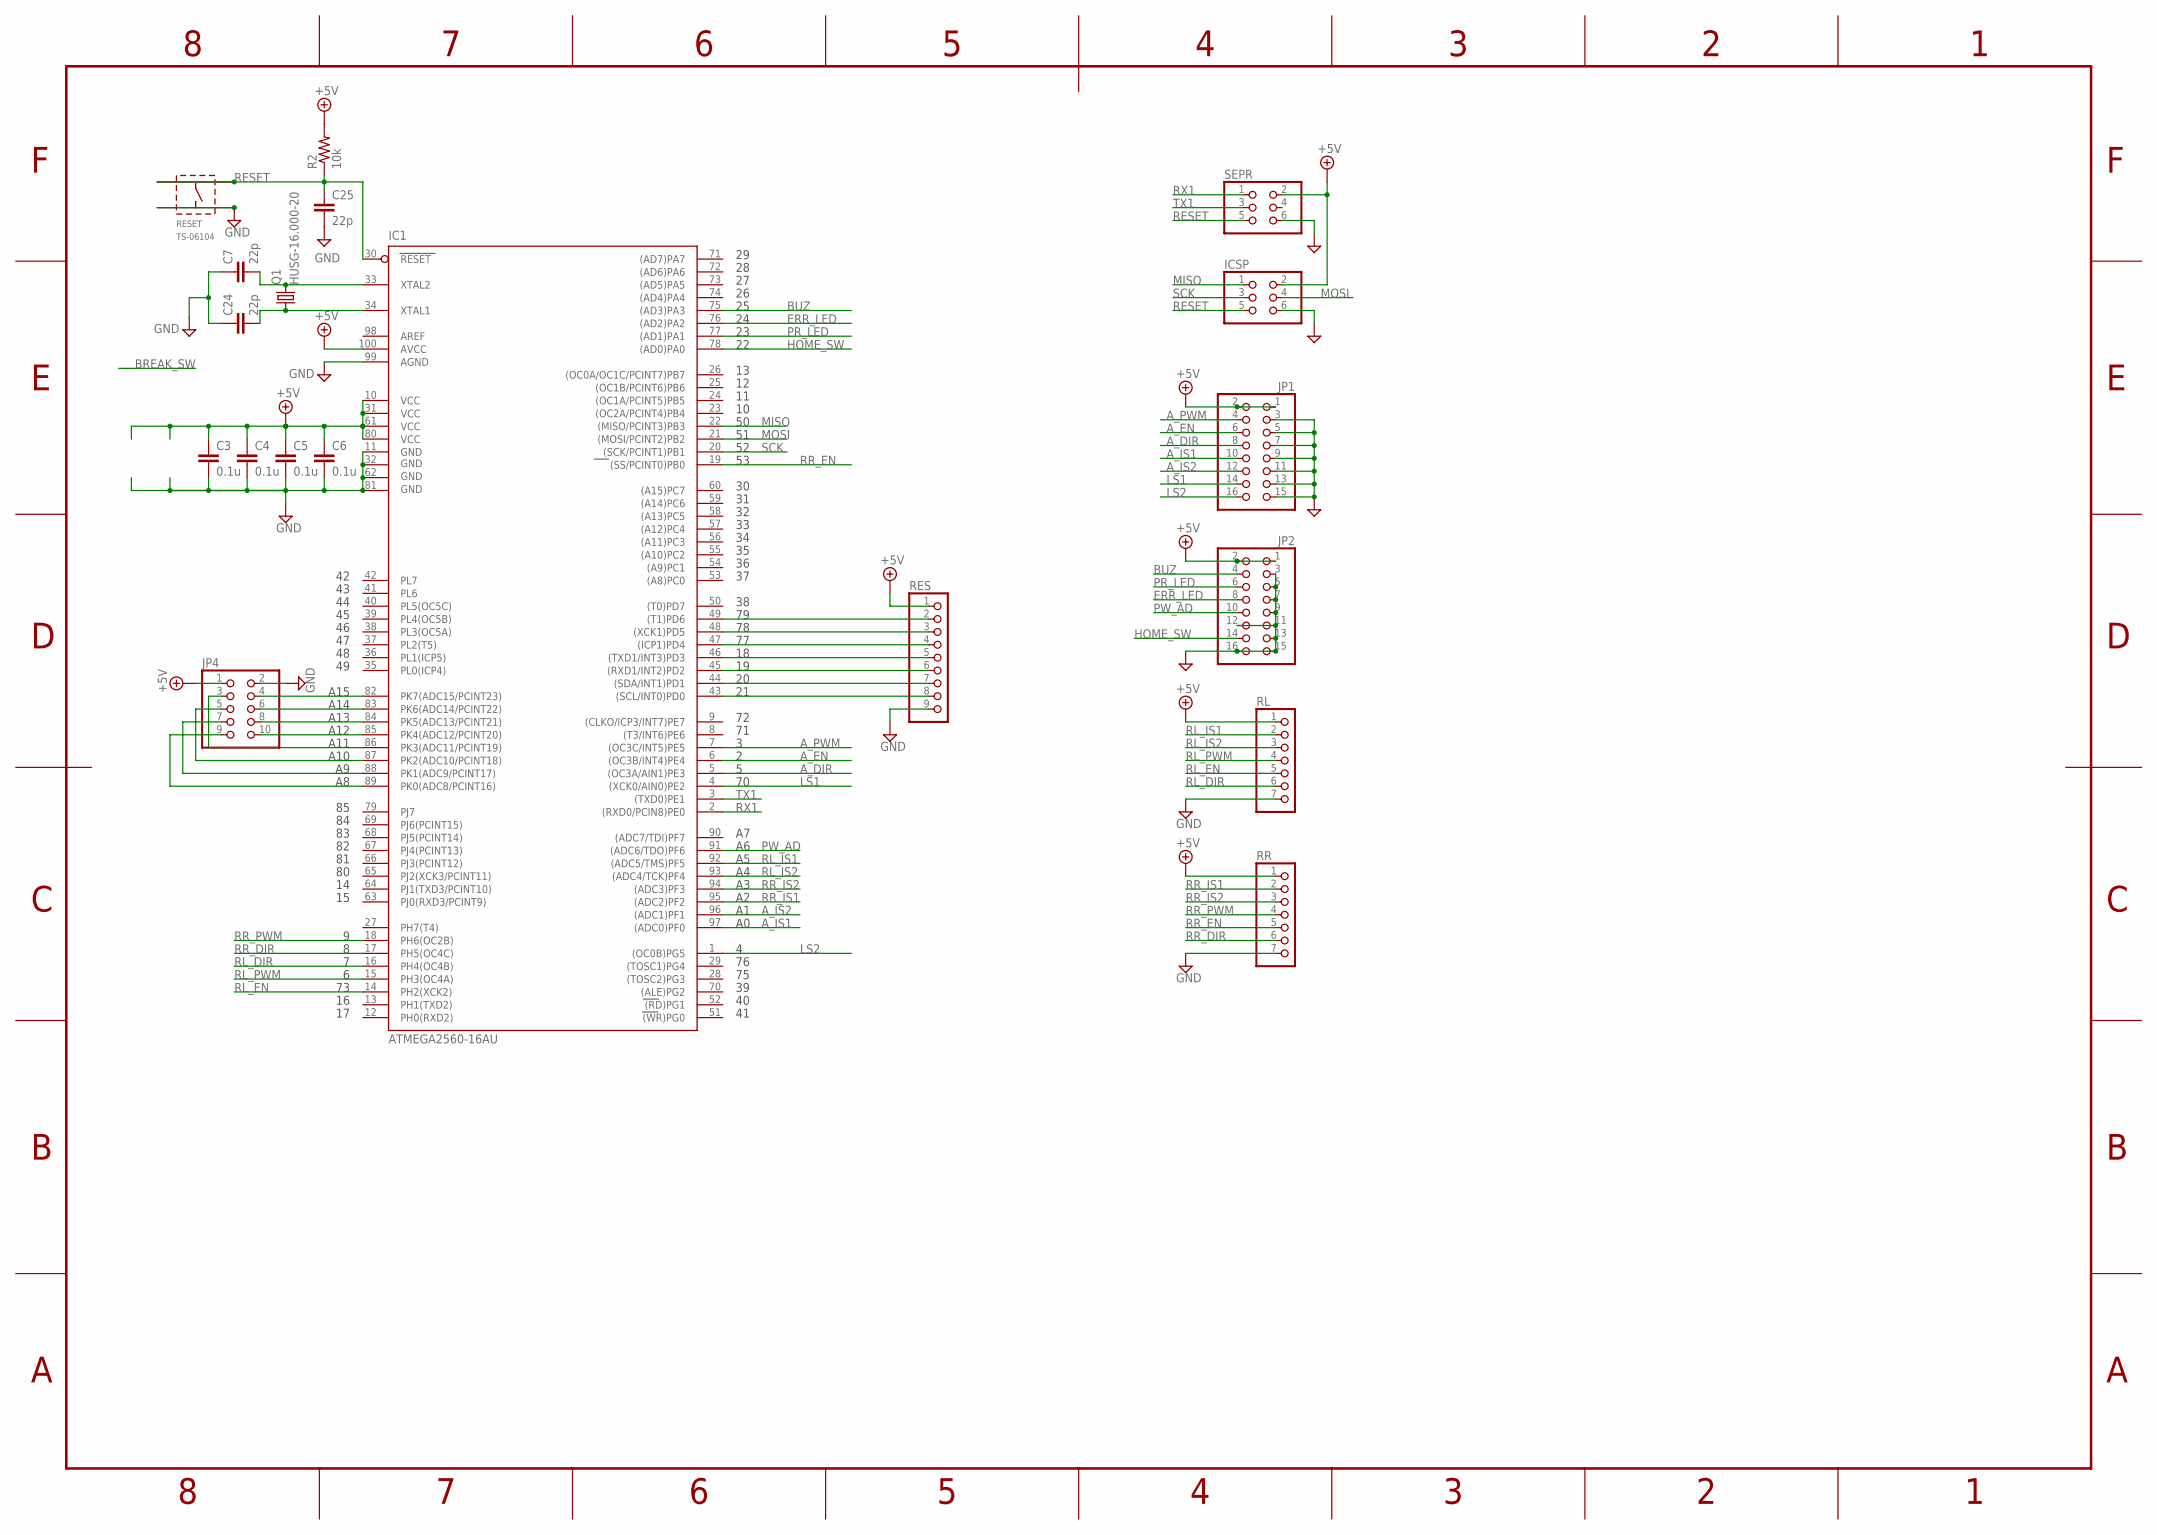
[picture p111: schematic 制御基板.sch]

Parts:
C3, C4, C5, C6: 0.1u; C0603
C7, C24, C25: 22p; C0603
IC1: ATMEGA2560-16AU; QFP100
ICSP: PINHD-2X3; 2X03
JP1, JP2: PINHD-2X8; 2X08
JP4: PINHD-2X5; 2X05
Q1: HUSG-16.000-20; XTALRR480W50L990T368H350B
R2: 10k; R0603
RES: PINHD-1X9; 1X09
RESET: TS-06104
RL: PINHD-1X7; 1X07
RR: PINHD-1X7; 1X07
SEPR: PINHD-2X3; 2X03

Connections:
+5V: C3.1, C4.1, C5.1, C6.1, IC1.10 (VCC), IC1.31 (VCC1), IC1.61 (VCC2), IC1.80 (VCC3), IC1.100 (AVCC), ICSP.2, JP1.1, JP1.2, JP2.1, JP2.2, JP4.1, R2.2, RES.1, RL.1, RR.1, SEPR.2
A_DIR: IC1.5 ((OC3A/AIN1)PE3), JP1.8
A_EN: IC1.6 ((OC3B/INT4)PE4), JP1.6
A_IS1: IC1.97 ((ADC0)PF0), JP1.10
A_IS2: IC1.96 ((ADC1)PF1), JP1.12
A_PWM: IC1.7 ((OC3C/INT5)PE5), JP1.4
BUZ: IC1.75 ((AD3)PA3), JP2.4
ERR_LED: IC1.76 ((AD2)PA2), JP2.6
GND: C3.2, C4.2, C5.2, C6.2, C7.1, C24.1, C25.2, IC1.11 (GND), IC1.32 (GND1), IC1.62 (GND2), IC1.81 (GND3), IC1.99 (AGND), ICSP.6, JP1.3, JP1.5, JP1.7, JP1.9, JP1.11, JP1.13, JP1.15, JP2.3, JP2.5, JP2.7, JP2.9, JP2.11, JP2.12, JP2.13, JP2.15, JP2.16, JP4.2, RES.9, RESET.B1 (T3), RESET.B2 (T4), RL.7, RR.7, SEPR.6
HOME_SW: IC1.78 ((AD0)PA0), JP2.14
LS1: IC1.4 ((XCK0/AIN0)PE2), JP1.14
LS2: IC1.1 ((OC0B)PG5), JP1.16
MISO: IC1.22 ((MISO/PCINT3)PB3), ICSP.1
MOSI: IC1.21 ((MOSI/PCINT2)PB2), ICSP.4
unnamed: IC1.43 ((SCL/INT0)PD0), RES.8
unnamed: C24.2, IC1.34 (XTAL1), Q1.1
unnamed: C7.2, IC1.33 (XTAL2), Q1.2
unnamed: IC1.44 ((SDA/INT1)PD1), RES.7
unnamed: IC1.45 ((RXD1/INT2)PD2), RES.6
unnamed: IC1.46 ((TXD1/INT3)PD3), RES.5
unnamed: IC1.47 ((ICP1)PD4), RES.4
unnamed: IC1.48 ((XCK1)PD5), RES.3
unnamed: IC1.49 ((T1)PD6), RES.2
unnamed: IC1.89 (PK0(ADC8/PCINT16)), JP4.9
unnamed: IC1.88 (PK1(ADC9/PCINT17)), JP4.7
unnamed: IC1.87 (PK2(ADC10/PCINT18)), JP4.5
unnamed: IC1.86 (PK3(ADC11/PCINT19)), JP4.3
unnamed: IC1.85 (PK4(ADC12/PCINT20)), JP4.10
unnamed: IC1.84 (PK5(ADC13/PCINT21)), JP4.8
unnamed: IC1.83 (PK6(ADC14/PCINT22)), JP4.6
unnamed: IC1.82 (PK7(ADC15/PCINT23)), JP4.4
PR_LED: IC1.77 ((AD1)PA1), JP2.8
PW_AD: IC1.91 ((ADC6/TDO)PF6), JP2.10
RESET: C25.1, IC1.30 (RESET), ICSP.5, R2.1, RESET.A1 (T1), RESET.A2 (T2), SEPR.5
RL_DIR: IC1.16 (PH4(OC4B)), RL.6
RL_EN: IC1.14 (PH2(XCK2)), RL.5
RL_IS1: IC1.92 ((ADC5/TMS)PF5), RL.2
RL_IS2: IC1.93 ((ADC4/TCK)PF4), RL.3
RL_PWM: IC1.15 (PH3(OC4A)), RL.4
RR_DIR: IC1.17 (PH5(OC4C)), RR.6
RR_EN: IC1.19 ((SS/PCINT0)PB0), RR.5
RR_IS1: IC1.95 ((ADC2)PF2), RR.2
RR_IS2: IC1.94 ((ADC3)PF3), RR.3
RR_PWM: IC1.18 (PH6(OC2B)), RR.4
RX1: IC1.2 ((RXD0/PCIN8)PE0), SEPR.1
SCK: IC1.20 ((SCK/PCINT1)PB1), ICSP.3
TX1: IC1.3 ((TXD0)PE1), SEPR.3

Notes on the sheet:
A10
A11
A12
A15
A14
A13

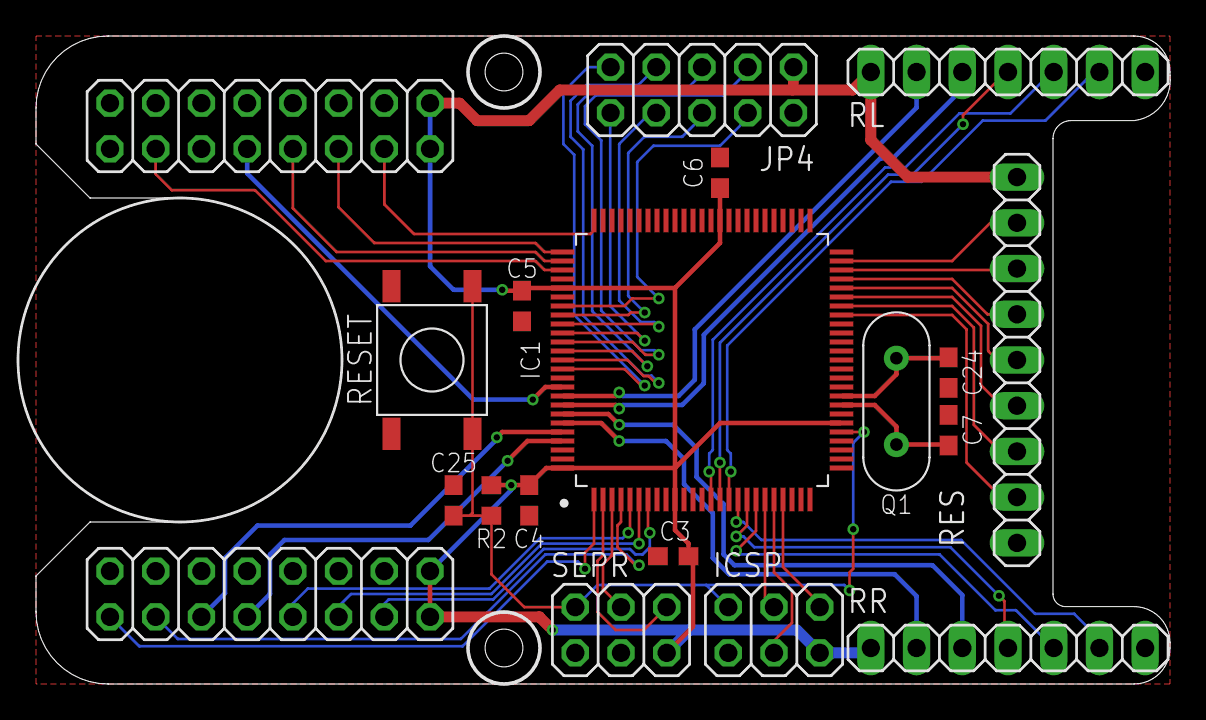
[picture p112: board 制御基板.brd from above]

Board: 2 copper layers, 63.0 x 36.0 mm, 19 parts (0 on the bottom side), 47 nets.
