KatsukiOishi/HikkiKomori/電子回路設計/足駆動回路/足駆動回路.brd

## EAGLE design 電子回路設計/足駆動回路/足駆動回路.brd (2023-07-12)

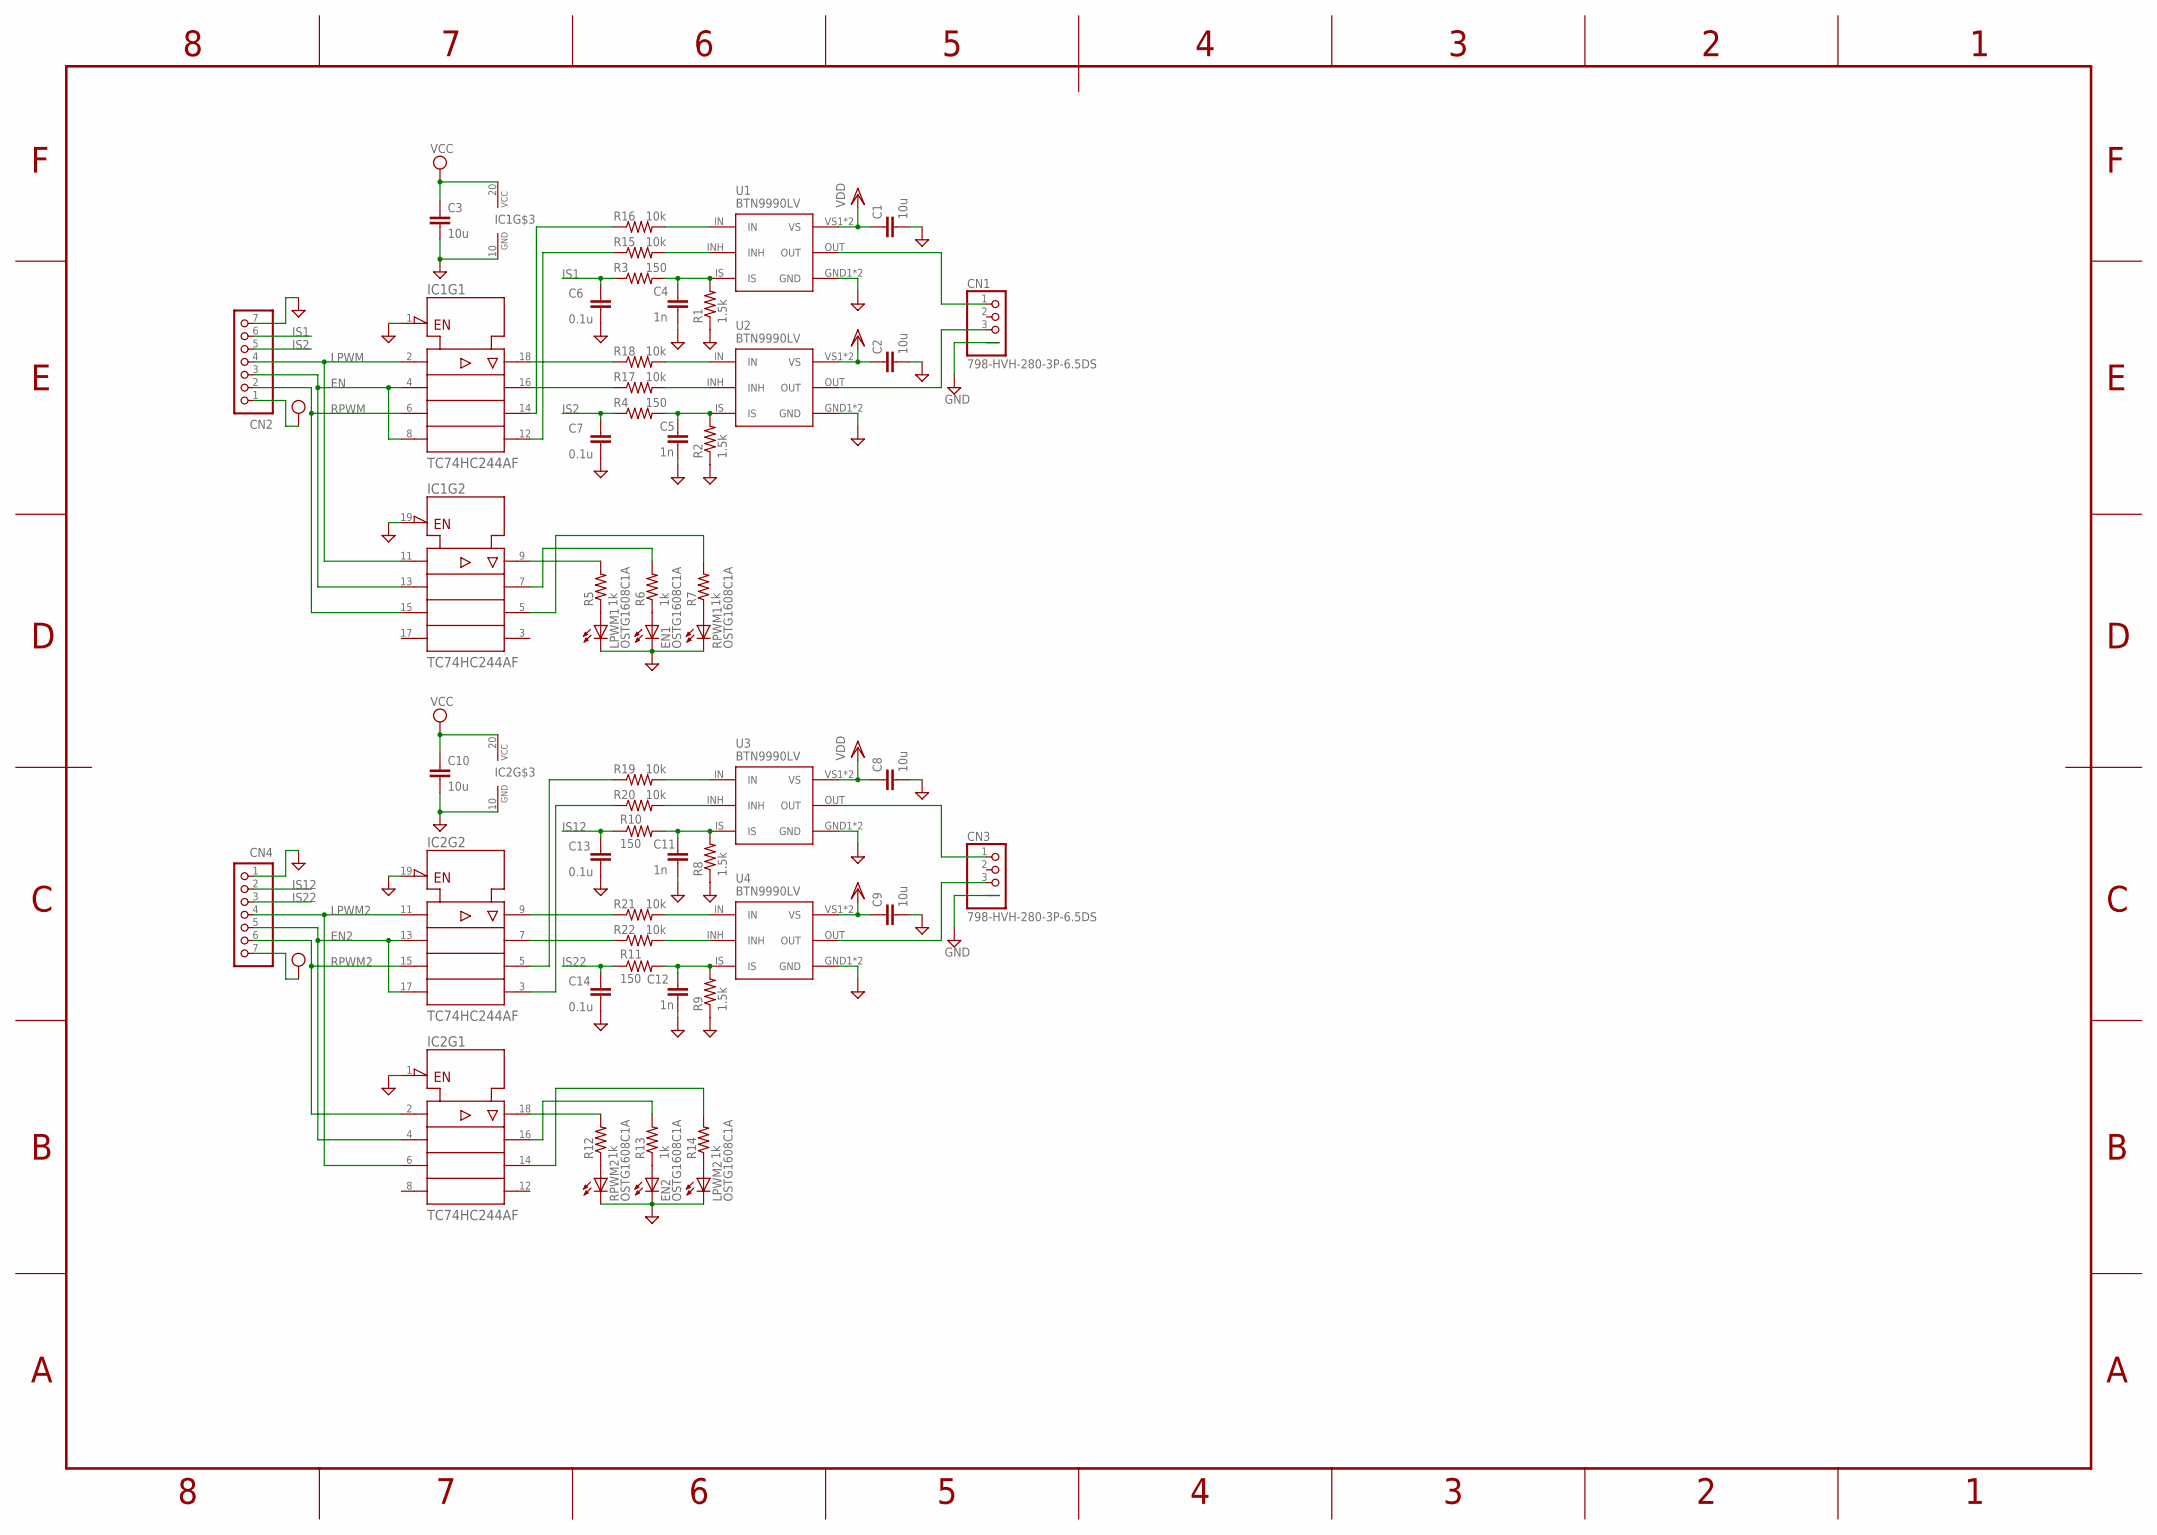
[picture p113: schematic 足駆動回路.sch]

Parts:
C1, C2, C3, C8, C9, C10: 10u; C3216
C4, C5, C11, C12: 1n; C1608
C6, C7, C13, C14: 0.1u; C1608
CN1, CN3: 798-HVH-280-3P-6.5DS
CN2, CN4: B7B-XH-A
EN1, EN2: OSTG1608C1A; LEDC1608X39N_G
IC1, IC2: TC74HC244AF; SOP20
LPWM1, LPWM2: OSTG1608C1A; LEDC1608X39N_G
R1, R2, R8, R9: 1.5k; R0603
R3, R4, R10, R11: 150; R0603
R5, R6, R7, R12, R13, R14: 1k; R0603
R15, R16, R17, R18, R19, R20, R21, R22: 10k; R1608
RPWM1, RPWM2: OSTG1608C1A; LEDC1608X39N_G
U1, U2, U3, U4: BTN9990LV

Connections:
EN: CN2.3, IC1.4 (A2), IC1.8 (A4), IC1.13 (A2)
EN2: CN4.5, IC2.4 (A2), IC2.13 (A2), IC2.17 (A4)
GND: C1.2, C2.2, C3.2, C4.2, C5.2, C6.2, C7.2, C8.2, C9.2, C10.2, C11.2, C12.2, C13.2, C14.2, CN1.P$1, CN1.P$2, CN1.P$3, CN1.P$4, CN2.7, CN3.P$1, CN3.P$2, CN3.P$3, CN3.P$4, CN4.1, EN1.K (C), EN2.K (C), IC1.1 (!G), IC1.10 (GND), IC1.19 (!G), IC2.1 (!G), IC2.10 (GND), IC2.19 (!G), LPWM1.K (C), LPWM2.K (C), R1.1, R2.1, R8.1, R9.1, RPWM1.K (C), RPWM2.K (C), U1.GND1 (GND), U1.GND2 (GND), U2.GND1 (GND), U2.GND2 (GND), U3.GND1 (GND), U3.GND2 (GND), U4.GND1 (GND), U4.GND2 (GND)
IS1: C6.1, CN2.6, R3.1
IS1_A: C4.1, R1.2, R3.2, U1.IS
IS1_A1: C11.1, R8.2, R10.2, U3.IS
IS2: C7.1, CN2.5, R4.1
IS2_1: C5.1, R2.2, R4.2, U2.IS
IS2_2: C12.1, R9.2, R11.2, U4.IS
IS12: C13.1, CN4.2, R10.1
IS22: C14.1, CN4.3, R11.1
LPWM: CN2.4, IC1.2 (A1), IC1.11 (A1)
LPWM2: CN4.4, IC2.6 (A3), IC2.11 (A1)
unnamed: IC1.18 (Y1), R18.1
unnamed: IC1.16 (Y2), R17.1
unnamed: IC1.14 (Y3), R16.1
unnamed: IC1.12 (Y4), R15.1
unnamed: LPWM1.A, R5.1
unnamed: EN1.A, R6.1
unnamed: R7.1, RPWM1.A
unnamed: IC1.9 (Y1), R5.2
unnamed: IC1.7 (Y2), R6.2
unnamed: IC1.5 (Y3), R7.2
unnamed: IC2.9 (Y1), R21.1
unnamed: IC2.7 (Y2), R22.1
unnamed: IC2.5 (Y3), R19.1
unnamed: IC2.3 (Y4), R20.1
unnamed: R12.1, RPWM2.A
unnamed: EN2.A, R13.1
unnamed: LPWM2.A, R14.1
unnamed: IC2.18 (Y1), R12.2
unnamed: IC2.16 (Y2), R13.2
unnamed: IC2.14 (Y3), R14.2
unnamed: R15.2, U1.INH
unnamed: R16.2, U1.IN
unnamed: R17.2, U2.INH
unnamed: R18.2, U2.IN
unnamed: R19.2, U3.IN
unnamed: R20.2, U3.INH
unnamed: R21.2, U4.IN
unnamed: R22.2, U4.INH
OUT1: CN1.1, U1.OUT
OUT2: CN1.3, U2.OUT
OUT3: CN3.1, U3.OUT
OUT4: CN3.3, U4.OUT
RPWM: CN2.2, IC1.6 (A3), IC1.15 (A3)
RPWM2: CN4.6, IC2.2 (A1), IC2.15 (A3)
VCC: C3.1, C10.1, CN2.1, CN4.7, IC1.20 (VCC), IC2.20 (VCC)
VDD: C1.1, C2.1, C8.1, C9.1, U1.VS1 (VS), U1.VS2 (VS), U2.VS1 (VS), U2.VS2 (VS), U3.VS1 (VS), U3.VS2 (VS), U4.VS1 (VS), U4.VS2 (VS)

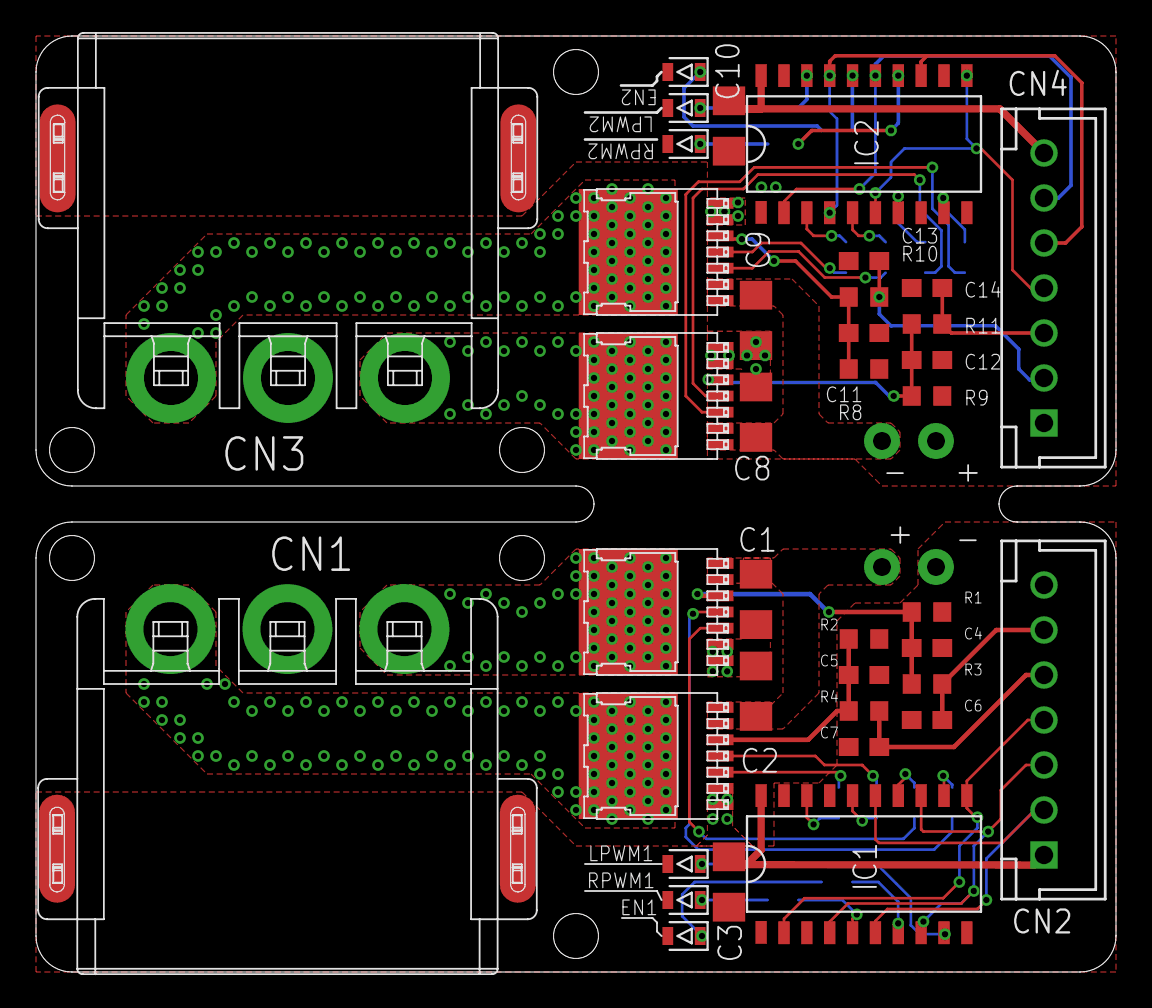
[picture p114: board 足駆動回路.brd from above]

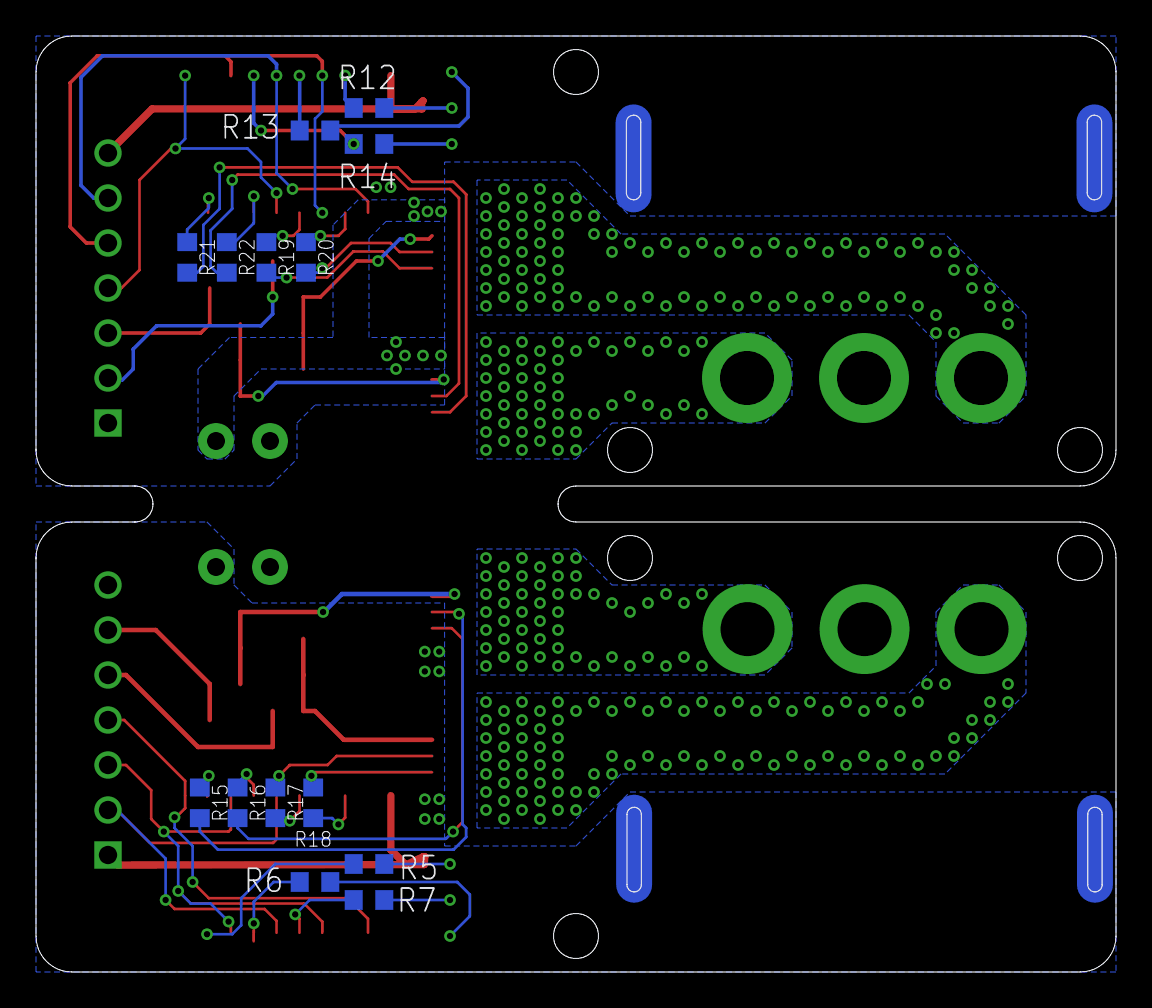
[picture p115: board 足駆動回路.brd from below]

Board: 2 copper layers, 60.0 x 52.0 mm, 52 parts (14 on the bottom side), 49 nets.
