KatsukiOishi/HikkiKomori/電子回路設計/電源基盤/電源基盤.brd

## EAGLE design 電子回路設計/電源基盤/電源基盤.brd (2023-07-12)

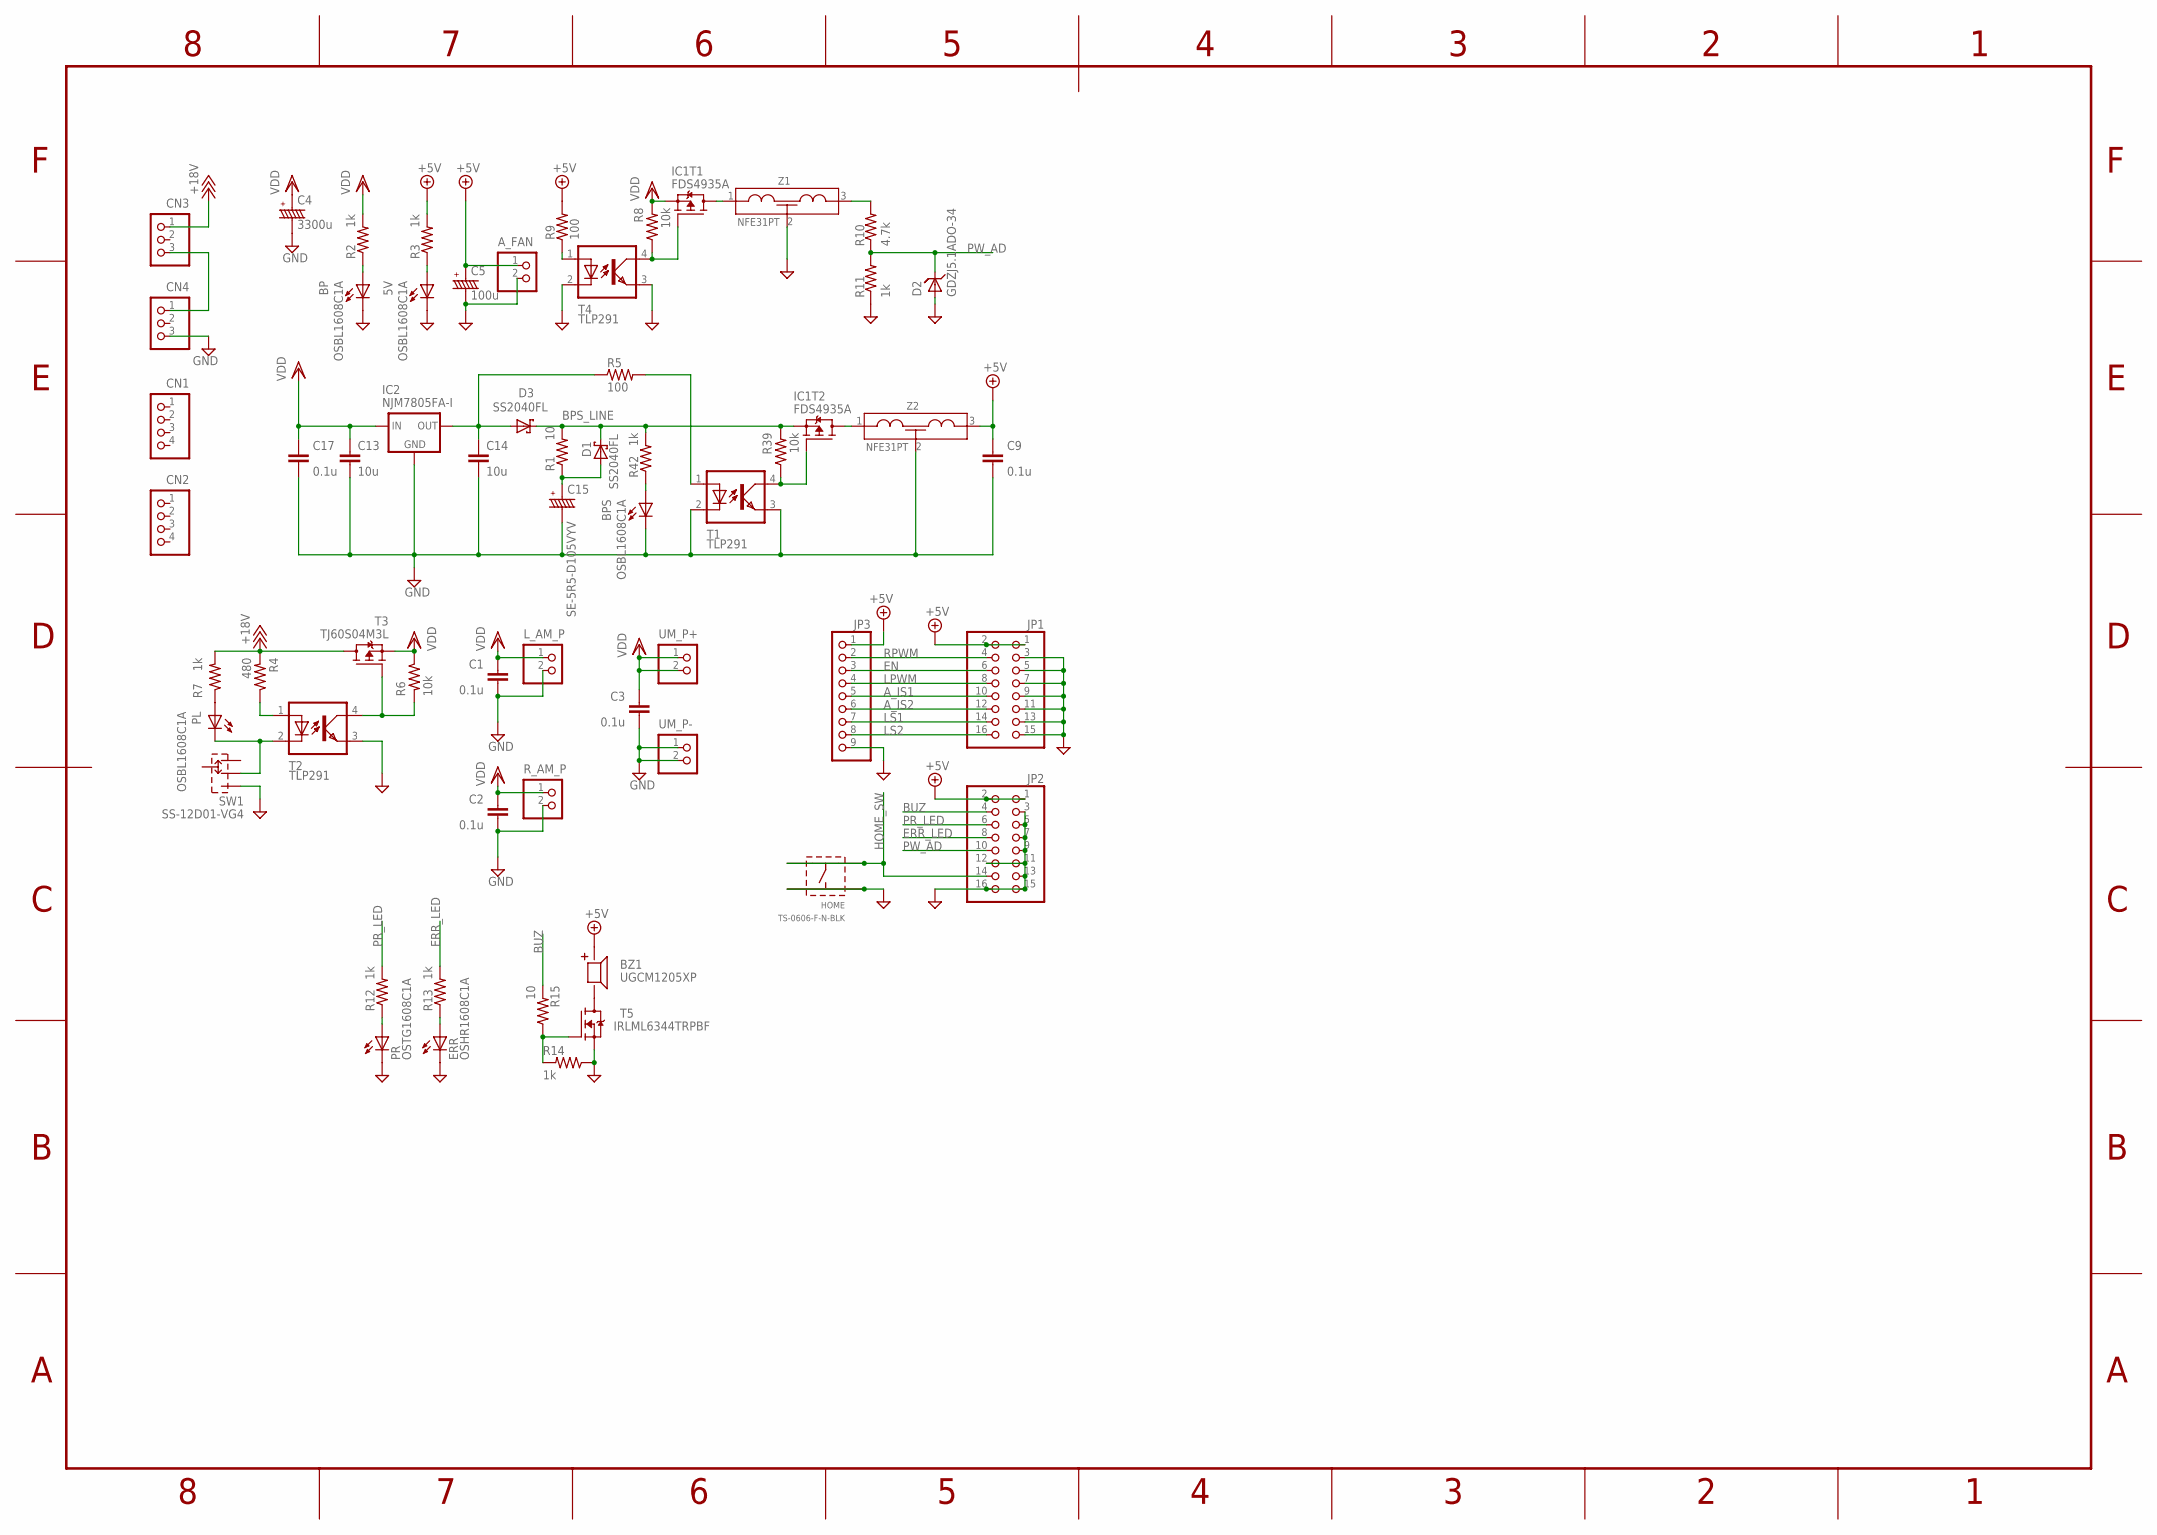
[picture p116: schematic 電源基盤.sch]

Parts:
5V: OSBL1608C1A; LEDC1608X39N_B
A_FAN: B2B-XH-A
BP: OSBL1608C1A; LEDC1608X39N_B
BPS: OSBL1608C1A; LEDC1608X39N_B
BZ1: UGCM1205XP
C1, C2, C3, C9, C17: 0.1u; C0603
C4: 3300u; D18_L25_P7.5_D1
C5: 100u; CPOL6.3-7_2.5
C13, C14: 10u; C0805
C15: SE-5R5-D105VYV
CN1, CN2: B4B-XH-A
CN3, CN4: B3P-VH
D1, D3: SS2040FL; SOD-123
D2: GDZJ5.1ADO-34; DIOAD590W50L290D210B
ERR: OSHR1608C1A; LEDC1608X39N_R
HOME: TS-0606-F-N-BLK; TS-0606-F-N
IC1: FDS4935A; SOIC127P600X250-8N
IC2: NJM7805FA-I; TO220
JP1, JP2: PINHD-2X8; 2X08
JP3: PINHD-1X9; 1X09
L_AM_P: B2P-VH
PL: OSBL1608C1A; LEDC1608X39N_B
PR: OSTG1608C1A; LEDC1608X39N_G
R1, R15: 10; R0603
R2, R3, R7, R11, R12, R13, R14, R42: 1k; R0603
R4: 480; R0603
R5, R9: 100; R0603
R6, R8, R39: 10k; R0603
R10: 4.7k; R0603
R_AM_P: B2P-VH
SW1: SS-12D01-VG4
T1, T2, T4: TLP291; SOIC127P700X210-4N
T3: TJ60S04M3L; DPACK
T5: IRLML6344TRPBF; SOT95P240X110-3N
UM_P+: B2P-VH
UM_P-: B2P-VH
Z1, Z2: NFE31PT; NFE31

Connections:
5V1: IC1.7 (D), IC1.8 (D), Z2.1
+5V: A_FAN.1, BZ1.+, C5.+, C9.1, JP1.1, JP1.2, JP2.1, JP2.2, JP3.1, R3.2, R9.2, Z2.3
+18V: CN3.1, R4.2, R7.2, T3.2 (D)
A_IS1: JP1.10, JP3.5
A_IS2: JP1.12, JP3.6
BLINE2: CN3.3, CN4.1
BPS_LINE: D1.1 (C), D3.1 (C), IC1.1 (S), R1.2, R39.2, R42.2
BPS_OR: C15.+, D1.2 (A), R1.1
BUZ: JP2.4, R15.2
EN: JP1.6, JP3.3
ERR_LED: JP2.6, R13.2
GND: 5V.2 (C), A_FAN.2, BP.2 (C), BPS.2 (C), C1.2, C2.2, C3.2, C4.-, C5.-, C9.2, C13.2, C14.2, C15.-, C17.2, CN4.3, D2.2 (A), ERR.2 (C), HOME.T3, HOME.T4, IC2.2 (GND), JP1.3, JP1.5, JP1.7, JP1.9, JP1.11, JP1.13, JP1.15, JP2.3, JP2.5, JP2.7, JP2.9, JP2.11, JP2.12, JP2.13, JP2.15, JP2.16, JP3.9, L_AM_P.2, PR.K (C), R11.1, R14.1, R_AM_P.2, SW1.NO, T1.2 (C), T1.3 (EMIT), T2.3 (EMIT), T4.2 (C), T4.3 (EMIT), T5.2 (S), UM_P-.1, UM_P-.2, Z1.2, Z2.2
HOME_SW: HOME.T1, HOME.T2, JP2.14
LPWM: JP1.8, JP3.4
LS1: JP1.14, JP3.7
LS2: JP1.16, JP3.8
unnamed: PL.1 (A), R7.1
unnamed: BP.1 (A), R2.1
unnamed: 5V.1 (A), R3.1
unnamed: IC1.5 (D), IC1.6 (D), Z1.1
unnamed: C14.1, D3.2 (A), IC2.3 (OUT), R5.1
unnamed: R4.1, T2.1 (A)
unnamed: PL.2 (C), SW1.COM, T2.2 (C)
unnamed: R6.2, T2.4 (COL), T3.1 (G)
unnamed: IC1.4 (G), R8.1, T4.4 (COL)
unnamed: PR.A, R12.1
unnamed: R9.1, T4.1 (A)
unnamed: R10.2, Z1.3
unnamed: IC1.2 (G), R39.1, T1.4 (COL)
unnamed: ERR.1 (A), R13.1
unnamed: BZ1.-, T5.3 (D)
unnamed: R14.2, R15.1, T5.1 (G)
unnamed: R5.2, T1.1 (A)
unnamed: BPS.1 (A), R42.1
PR_LED: JP2.8, R12.2
PW_AD: D2.1 (C), JP2.10, R10.1, R11.2
RPWM: JP1.4, JP3.2
VDD: C1.1, C2.1, C3.1, C4.+, C13.1, C17.1, IC1.3 (S), IC2.1 (IN), L_AM_P.1, R2.2, R6.1, R8.2, R_AM_P.1, T3.3 (S), UM_P+.1, UM_P+.2

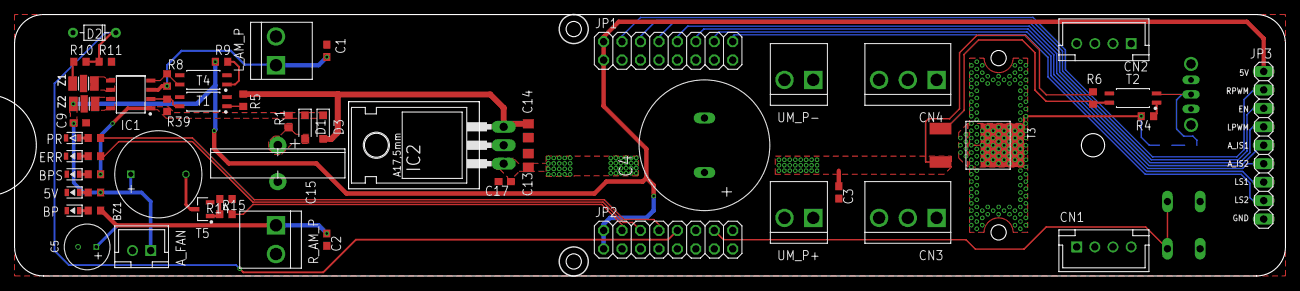
[picture p117: board 電源基盤.brd from above]

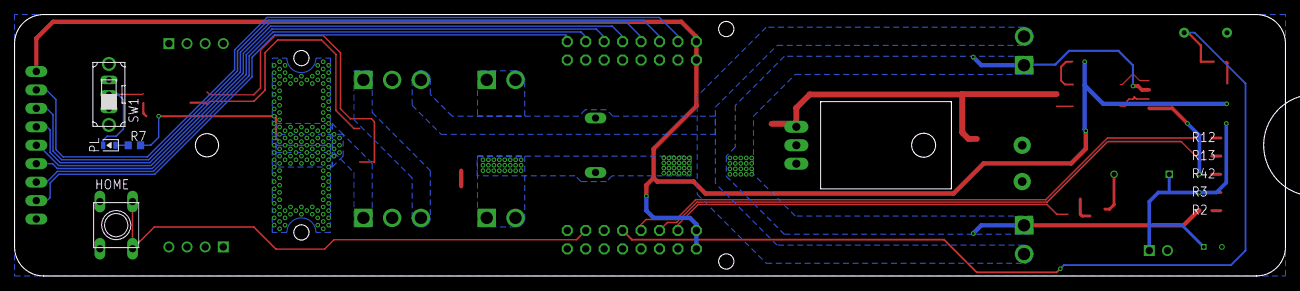
[picture p118: board 電源基盤.brd from below]

Board: 2 copper layers, 175.0 x 36.0 mm, 60 parts (4 on the bottom side), 38 nets.
