KatsukiOishi/HikkiKomori/電子回路設計/cam/Panel/cam.brd

## EAGLE design 電子回路設計/cam/Panel/cam.brd (2023-07-12)

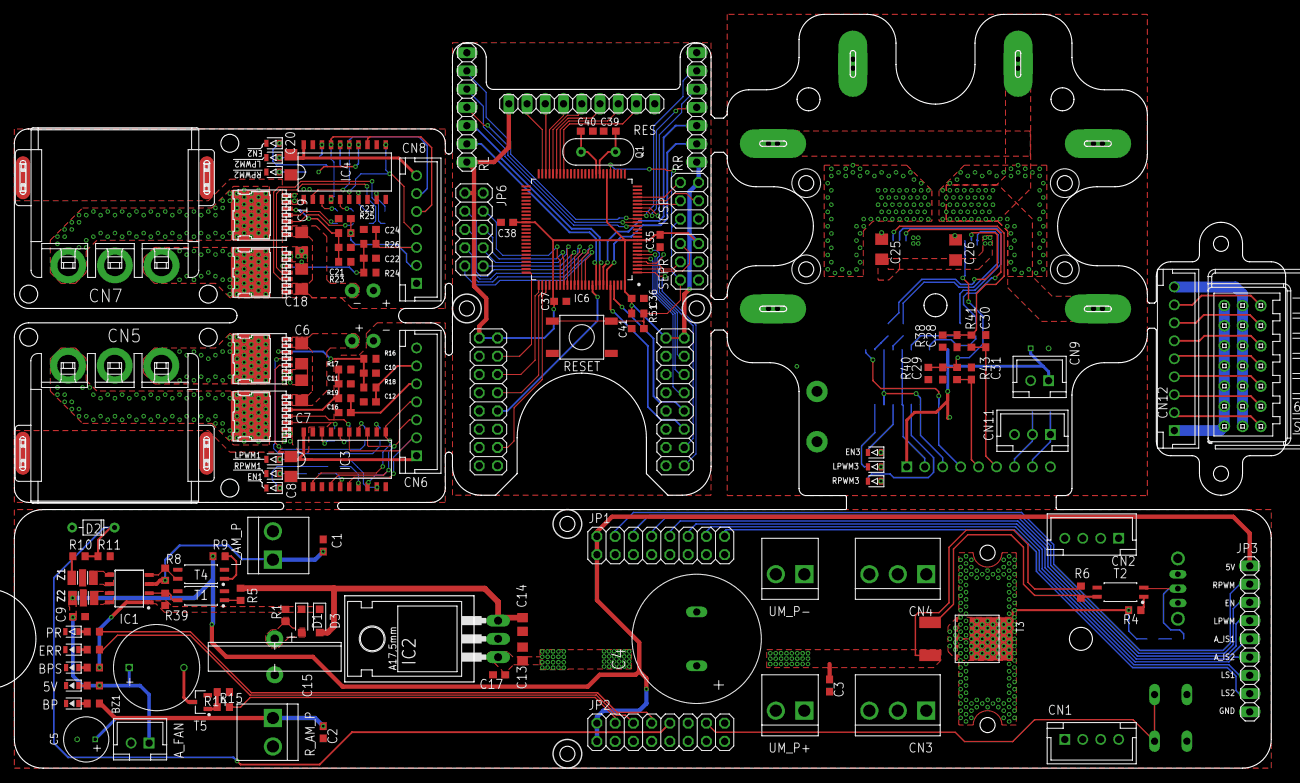
[picture p119: board cam.brd from above]

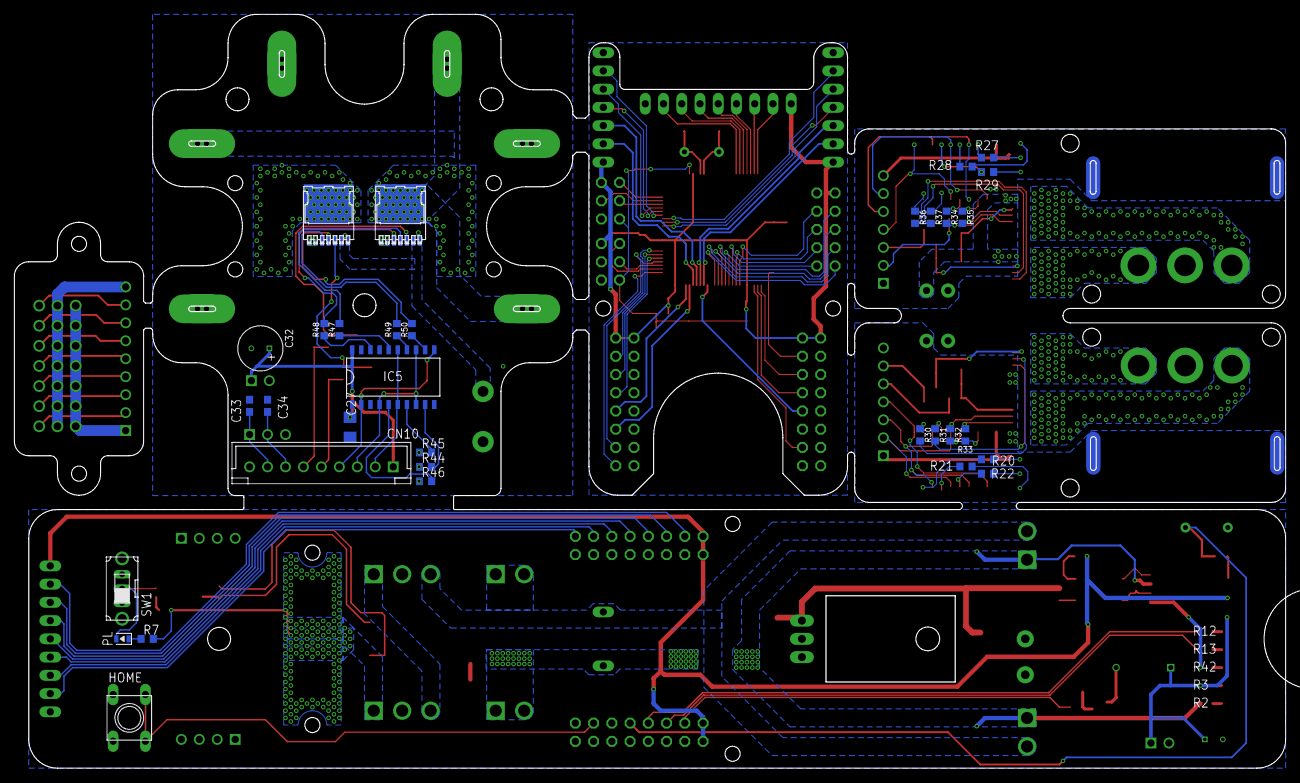
[picture p120: board cam.brd from below]

Board: 2 copper layers, 177.0 x 105.0 mm, 175 parts (33 on the bottom side), 171 nets.

Parts:
5V: OSBL1608C1A; LEDC1608X39N_B
A_FAN: B2B-XH-A
BP: OSBL1608C1A; LEDC1608X39N_B
BPS: OSBL1608C1A; LEDC1608X39N_B
BZ1: UGCM1205XP
C1, C2, C3, C9, C17, C35, C36, C37, C38: 0.1u; C0603
C4: 3300u; D18_L25_P7.5_D1
C5, C32: 100u; CPOL6.3-7_2.5
C6, C7, C8, C18, C19, C20, C25, C26, C27: 10u; C3216
C10, C11, C21, C22, C28, C29, C33, C34: 1n; C1608
C12, C16, C23, C24, C30, C31: 0.1u; C1608
C13, C14: 10u; C0805
C15: SE-5R5-D105VYV
C39, C40, C41: 22p; C0603
CN1, CN2: B4B-XH-A
CN3, CN4: B3P-VH
CN5, CN7: 798-HVH-280-3P-6.5DS
CN6, CN8: B7B-XH-A
CN9: B2B-XH-A
CN10, CN12: B9B-XH-A
CN11: B3B-XH-A
D1, D3: SS2040FL; SOD-123
D2: GDZJ5.1ADO-34; DIOAD590W50L290D210B
EN1, EN2, EN3: OSTG1608C1A; LEDC1608X39N_G
ERR: OSHR1608C1A; LEDC1608X39N_R
HOME: TS-0606-F-N-BLK; TS-0606-F-N
IC1: FDS4935A; SOIC127P600X250-8N
IC2: NJM7805FA-I; TO220
IC3, IC4, IC5: TC74HC244AF; SOP20
IC6: ATMEGA2560-16AU; QFP100
ICSP: 2X03
JP1, JP2, JP4, JP5: 2X08
JP3: 1X09
JP6: 2X05
LPWM1, LPWM2, LPWM3: OSTG1608C1A; LEDC1608X39N_G
L_AM_P: B2P-VH
OUT1: VIA_2.5X5.25_D0.75; VIA_2X5.25_D0.75
PL: OSBL1608C1A; LEDC1608X39N_B
PR: OSTG1608C1A; LEDC1608X39N_G
Q1: HUSG-16.000-20; XTALRR480W50L990T368H350B
R1, R15: 10; R0603
R2, R3, R7, R11, R12, R13, R14, R20, R21, R22, R27, R28, R29, R42, R44, R45, R46: 1k; R0603
R4: 480; R0603
R5, R9: 100; R0603
R6, R8, R39, R51: 10k; R0603
R10: 4.7k; R0603
R16, R17, R23, R24, R38, R40: 1.5k; R0603
R18, R19, R25, R26, R41, R43: 150; R0603
R30, R31, R32, R33, R34, R35, R36, R37, R47, R48, R49, R50: 10k; R1608
RES: 1X09
RESET: TS-06104
RL: 1X07
RPWM1, RPWM2, RPWM3: OSTG1608C1A; LEDC1608X39N_G
RR: 1X07
R_AM_P: B2P-VH
SEPR: 2X03
SW1: SS-12D01-VG4
T1, T2, T4: TLP291; SOIC127P700X210-4N
T3: TJ60S04M3L; DPACK
T5: IRLML6344TRPBF; SOT95P240X110-3N
U1, U2, U3, U4, U5, U6: BTN9990LV
U$1: R3006B
U$2, U$4, U$5, U$6, U$7, U$8, U$9, U$10, U$11, U$12, U$13: VIA_2.5X5.25_D0.75; VIA_2X5.25_D0.75
UM_P+: B2P-VH
UM_P-: B2P-VH
Z1, Z2: NFE31PT; NFE31

Connections:
5V: CN12.9, U$1.V1, U$1.V2, U$1.V3, U$1.V4, U$1.V5, U$1.V6, U$1.VB
5V1: IC1.7, IC1.8, Z2.1
+5V: A_FAN.1, BZ1.+, C5.+, C9.1, JP1.1, JP1.2, JP2.1, JP2.2, JP3.1, R3.2, R9.2, Z2.3
+5V1: C35.1, C36.1, C37.1, C38.1, IC6.10, IC6.31, IC6.61, IC6.80, IC6.100, ICSP.2, JP4.1, JP4.2, JP5.1, JP5.2, JP6.1, R51.2, RES.1, RL.1, RR.1, SEPR.2
+18V: CN3.1, R4.2, R7.2, T3.2
A_DIR: IC6.5, JP4.8
A_EN: IC6.6, JP4.6
A_IS1: JP1.10, JP3.5
A_IS2: JP1.12, JP3.6
A_IS3: IC6.97, JP4.10
A_IS4: IC6.96, JP4.12
A_PWM: IC6.7, JP4.4
BLINE2: CN3.3, CN4.1
BPS_LINE: D1.1, D3.1, IC1.1, R1.2, R39.2, R42.2
BPS_OR: C15.+, D1.2, R1.1
BUZ: JP2.4, R15.2
BUZ1: IC6.75, JP5.4
EN: JP1.6, JP3.3
EN1: CN6.3, IC3.4, IC3.8, IC3.13
EN2: CN8.5, IC4.4, IC4.13, IC4.17
EN3: CN10.3, IC5.4, IC5.8, IC5.13
ERR_LED: JP2.6, R13.2
ERR_LED1: IC6.76, JP5.6
GND: 5V.2, A_FAN.2, BP.2, BPS.2, C1.2, C2.2, C3.2, C4.-, C5.-, C9.2, C13.2, C14.2, C15.-, C17.2, CN4.3, D2.2, ERR.2, HOME.T3, HOME.T4, IC2.2, JP1.3, JP1.5, JP1.7, JP1.9, JP1.11, JP1.13, JP1.15, JP2.3, JP2.5, JP2.7, JP2.9, JP2.11, JP2.12, JP2.13, JP2.15, JP2.16, JP3.9, L_AM_P.2, PR.K, R11.1, R14.1, R_AM_P.2, SW1.NO, T1.2, T1.3, T2.3, T4.2, T4.3, T5.2, UM_P-.1, UM_P-.2, Z1.2, Z2.2
GND1: C6.2, C7.2, C8.2, C10.2, C11.2, C12.2, C16.2, C18.2, C19.2, C20.2, C21.2, C22.2, C23.2, C24.2, CN5.P$1, CN5.P$2, CN5.P$3, CN5.P$4, CN6.7, CN7.P$1, CN7.P$2, CN7.P$3, CN7.P$4, CN8.1, EN1.K, EN2.K, IC3.1, IC3.10, IC3.19, IC4.1, IC4.10, IC4.19, LPWM1.K, LPWM2.K, R16.1, R17.1, R23.1, R24.1, RPWM1.K, RPWM2.K, U1.GND1, U1.GND2, U2.GND1, U2.GND2, U3.GND1, U3.GND2, U4.GND1, U4.GND2
GND2: C25.2, C26.2, C27.2, C28.2, C29.2, C30.2, C31.2, C32.-, C33.2, C34.2, CN9.2, CN10.9, CN11.3, EN3.K, IC5.1, IC5.10, IC5.19, LPWM3.K, R38.1, R40.1, RPWM3.K, U5.GND1, U5.GND2, U6.GND1, U6.GND2
GND3: C35.2, C36.2, C37.2, C38.2, C39.1, C40.1, C41.2, IC6.11, IC6.32, IC6.62, IC6.81, IC6.99, ICSP.6, JP4.3, JP4.5, JP4.7, JP4.9, JP4.11, JP4.13, JP4.15, JP5.3, JP5.5, JP5.7, JP5.9, JP5.11, JP5.12, JP5.13, JP5.15, JP5.16, JP6.2, RES.9, RESET.B1, RESET.B2, RL.7, RR.7, SEPR.6
GND4: CN12.1, U$1.0B, U$1.01, U$1.02, U$1.03, U$1.04, U$1.05, U$1.06
HOME_SW: HOME.T1, HOME.T2, JP2.14
HOME_SW1: IC6.78, JP5.14
IS1: C12.1, CN6.6, R18.1
IS1_A: C10.1, R16.2, R18.2, U1.IS
IS1_A1: C21.1, R23.2, R25.2, U3.IS
IS1_A2: C28.1, R38.2, R41.2, U5.IS
IS2: C16.1, CN6.5, R19.1
IS2_1: C11.1, R17.2, R19.2, U2.IS
IS2_2: C22.1, R24.2, R26.2, U4.IS
IS2_3: C29.1, R40.2, R43.2, U6.IS
IS3: C30.1, CN10.6, R41.1
IS4: C31.1, CN10.5, R43.1
IS12: C23.1, CN8.2, R25.1
IS22: C24.1, CN8.3, R26.1
LPWM: JP1.8, JP3.4
LPWM1: CN6.4, IC3.2, IC3.11
LPWM2: CN8.4, IC4.6, IC4.11
LPWM3: CN10.4, IC5.2, IC5.11
LS1: JP1.14, JP3.7
LS2: JP1.16, JP3.8
LS3: C33.1, CN10.8, CN11.1
LS4: C34.1, CN10.7, CN11.2
LS5: IC6.4, JP4.14
LS6: IC6.1, JP4.16
MISO: IC6.22, ICSP.1
MOSI: IC6.21, ICSP.4
unnamed: PL.1, R7.1
unnamed: BP.1, R2.1
unnamed: 5V.1, R3.1
unnamed: IC1.5, IC1.6, Z1.1
unnamed: C14.1, D3.2, IC2.3, R5.1
unnamed: R4.1, T2.1
unnamed: PL.2, SW1.COM, T2.2
unnamed: R6.2, T2.4, T3.1
unnamed: IC1.4, R8.1, T4.4
unnamed: PR.A, R12.1
unnamed: R9.1, T4.1
unnamed: R10.2, Z1.3
unnamed: IC1.2, R39.1, T1.4
unnamed: ERR.1, R13.1
unnamed: BZ1.-, T5.3
unnamed: R14.2, R15.1, T5.1
unnamed: R5.2, T1.1
unnamed: IC3.18, R33.1
unnamed: IC3.16, R32.1
unnamed: IC3.14, R31.1
unnamed: IC3.12, R30.1
unnamed: LPWM1.A, R20.1
unnamed: EN1.A, R21.1
unnamed: R22.1, RPWM1.A
unnamed: IC3.9, R20.2
unnamed: IC3.7, R21.2
unnamed: IC3.5, R22.2
unnamed: IC4.9, R36.1
unnamed: IC4.7, R37.1
unnamed: IC4.5, R34.1
unnamed: IC4.3, R35.1
unnamed: R27.1, RPWM2.A
unnamed: EN2.A, R28.1
unnamed: LPWM2.A, R29.1
unnamed: IC4.18, R27.2
unnamed: IC4.16, R28.2
unnamed: IC4.14, R29.2
unnamed: R30.2, U1.INH
unnamed: R31.2, U1.IN
unnamed: R32.2, U2.INH
unnamed: R33.2, U2.IN
unnamed: R34.2, U3.IN
unnamed: R35.2, U3.INH
unnamed: R36.2, U4.IN
unnamed: R37.2, U4.INH
unnamed: IC5.18, R48.1
unnamed: BPS.1, R42.1
unnamed: IC5.16, R47.1
unnamed: LPWM3.A, R44.1
unnamed: EN3.A, R45.1
unnamed: R46.1, RPWM3.A
unnamed: IC5.9, R44.2
unnamed: IC5.7, R45.2
unnamed: IC5.5, R46.2
unnamed: IC5.14, R49.1
unnamed: IC5.12, R50.1
unnamed: R47.2, U5.INH
unnamed: R48.2, U5.IN
unnamed: R49.2, U6.IN
unnamed: R50.2, U6.INH
unnamed: C40.2, IC6.34, Q1.1
unnamed: C39.2, IC6.33, Q1.2
unnamed: IC6.43, RES.8
unnamed: IC6.44, RES.7
unnamed: IC6.45, RES.6
unnamed: IC6.46, RES.5
unnamed: IC6.47, RES.4
unnamed: IC6.48, RES.3
unnamed: IC6.49, RES.2
unnamed: IC6.89, JP6.9
unnamed: IC6.88, JP6.7
unnamed: IC6.87, JP6.5
unnamed: IC6.86, JP6.3
unnamed: IC6.85, JP6.10
unnamed: IC6.84, JP6.8
unnamed: IC6.83, JP6.6
unnamed: IC6.82, JP6.4
unnamed: CN12.8, U$1.1
unnamed: CN12.7, U$1.2
unnamed: CN12.6, U$1.3
unnamed: CN12.5, U$1.4
unnamed: CN12.4, U$1.5
unnamed: CN12.3, U$1.6
unnamed: CN12.2, U$1.B
OUT1: CN5.1, U1.OUT
OUT2: CN5.3, U2.OUT
OUT3: CN7.1, U3.OUT
OUT4: CN7.3, U4.OUT
OUT5: OUT1.P$1, U5.OUT, U$2.P$1, U$4.P$1, U$5.P$1, U$6.P$1, U$7.P$1
OUT6: U6.OUT, U$8.P$1, U$9.P$1, U$10.P$1, U$11.P$1, U$12.P$1, U$13.P$1
PR_LED: JP2.8, R12.2
PR_LED1: IC6.77, JP5.8
PW_AD: D2.1, JP2.10, R10.1, R11.2
PW_AD1: IC6.91, JP5.10
RESET: C41.1, IC6.30, ICSP.5, R51.1, RESET.A1, RESET.A2, SEPR.5
RL_DIR: IC6.16, RL.6
RL_EN: IC6.14, RL.5
RL_IS1: IC6.92, RL.2
RL_IS2: IC6.93, RL.3
RL_PWM: IC6.15, RL.4
RPWM: JP1.4, JP3.2
RPWM1: CN6.2, IC3.6, IC3.15
RPWM2: CN8.6, IC4.2, IC4.15
RPWM3: CN10.2, IC5.6, IC5.15
RR_DIR: IC6.17, RR.6
RR_EN: IC6.19, RR.5
RR_IS1: IC6.95, RR.2
RR_IS2: IC6.94, RR.3
RR_PWM: IC6.18, RR.4
RX1: IC6.2, SEPR.1
SCK: IC6.20, ICSP.3
TX1: IC6.3, SEPR.3
VCC: C8.1, C20.1, CN6.1, CN8.7, IC3.20, IC4.20
VCC1: C27.1, C32.+, CN9.1, CN10.1, IC5.20
VDD: C1.1, C2.1, C3.1, C4.+, C13.1, C17.1, IC1.3, IC2.1, L_AM_P.1, R2.2, R6.1, R8.2, R_AM_P.1, T3.3, UM_P+.1, UM_P+.2
VDD1: C6.1, C7.1, C18.1, C19.1, U1.VS1, U1.VS2, U2.VS1, U2.VS2, U3.VS1, U3.VS2, U4.VS1, U4.VS2
VDD2: C25.1, C26.1, U5.VS1, U5.VS2, U6.VS1, U6.VS2
