KatsukiOishi/HikkiKomori/制御/KawaroboMain/pindefine.h

#ifndef _PINDEFINE_H_
#define _PINDEFINE_H_

#define A_EN    2
#define A_RPWM   3
#define A_LPWM   5
#define A_IS1   A0
#define A_IS2   A1
#define LS1     70
#define LS2     4

#define RL_EN   73
#define RL_RPWM  7
#define RL_LPWM  6
#define RL_IS1  A5
#define RL_IS2  A4
#define RR_EN   53
#define RR_RPWM  8
#define RR_LPWM  9
#define RR_IS1  A2
#define RR_IS2  A3

#define BUZ     25
#define PR_LED  23
#define ERR_LED 24
#define PW_AD   A6
#define HOME_SW 22

#define DLS LS1
#define ULS LS2
#endif
