KatsukiOishi/HikkiKomori/(commit log)

2022-05-22 gitignore追加
2022-05-22 2017年用参考データ追加
2022-05-23 左半身側ヘッケンリンク作成
    [ARB-340CE.SLDPRT, B6700ZZ.SLDPRT, CBSS3-6.SLDPRT, CBSTBR3-10.SLDPRT, CBSTBR3-4.SLDPRT, CLJW6-8-15.5.SLDPRT, FL678ZZ.SLDPRT, FWSJW-D8-V6-T5.5.SLDPRT]
2022-05-23 右半身側単体足作成
    [ヘッケンリンク.SLDASM, 前足底.SLDPRT, 右側足単体.SLDASM, 左側足単体.SLDASM, 左半身機構.SLDASM, 足プーリーフランジ.SLDPRT, 足単体.SLDASM]
2022-05-23 不要データ削除
    [ベルト設計Excel.xlsx]
2022-05-24 左半身完成
    [ARL-340BE.SLDPRT, B6700ZZ.SLDPRT, Bucha12V.SLDPRT, CB2.6-5.SLDPRT, CBSTBR3-4.SLDPRT, CBSTBR3-5.SLDPRT, CBSTBR3-6.SLDPRT, CBSTBR3-8.SLDPRT]
2022-05-25 左半身詳細設計
    [CLJW6-8-38.0.SLDPRT, CLJW6-8-40.0.SLDPRT, Flange_MPTZ10-30.SLDPRT, MPFZ10-8.SLDPRT, MPTZ10-30.SLDASM, Nezi_MPTZ10-30.SLDPRT, ヘッケンリンク.SLDASM, 工程表.xlsx]
2022-05-31 中央ユニット作成
    [ヘッケンリンク.SLDASM, 中央ユニット.SLDASM, 右半身機構.SLDASM, 右足機構側面充填樹脂.sldprt, 左半身機構.SLDASM, 左足機構側面充填樹脂.sldprt, 足単体.SLDASM, 足機構上面カバー.sldprt]
2022-06-01 アームリンク各種作図完了
    [B676ZZ.SLDPRT, B6800ZZ.SLDPRT, B6802ZZ.SLDPRT, B6805ZZ.SLDPRT, B6809ZZ.SLDPRT, BFLB6-5.SLDPRT, Bucha12V.SLDPRT, Eixo12V.SLDPRT]
2022-06-01 アームリンク作成
    [ヘッケンリンク.SLDASM, 中央ユニット.SLDASM, 右半身機構.SLDASM, 左半身機構.SLDASM, 腕機構.SLDASM]
2022-06-01 腕機構仮決定
    [ABETP6-75.0-F5.0-G5.0-M3-N3.SLDPRT, ABETTF6-75.0-M3-N3.SLDPRT, ABETTF6-90.0-M3-N3.SLDPRT, ABETTF6-95.0-M3-N3.SLDPRT, B676ZZ.SLDPRT, B6800ZZ.SLDPRT, B6802ZZ.SLDPRT, B6809ZZ.SLDPRT]
2022-06-01 全体像策定完了
    [ABETP6-75.0-F5.0-G5.0-M3-N3.SLDPRT, ABETTF6-95.0-M3-N3.SLDPRT, ASL-315E.SLDPRT, CBSS3-6.SLDPRT, CBSTBR3-5.SLDPRT, CBSTBR3-8.SLDPRT, FAASC-V6-D8-L40.5.SLDPRT, FAASC-V6-D9-L40.5.SLDPRT]
2022-06-04 ワイヤ長さ決定 ワイヤブロック作成
    [FAASC-V6-D9-L40.5.SLDPRT, GEFHBB0.5-80-3-15-W0.SLDASM, GEFHBB0.5-80-5-15-W0-LFC27-M6.SLDASM, Rotary Shaft_SFHRW6-103.0-M3-N3.SLDPRT, Rotary Shaft_SFRHH6-109.0-F2.5-P5-T2.5-M3.SLDPRT, Set Screw-1_GEFHBB0.5-80-3-15-W0.SLDPRT, Set Screw-1_GEFHBB0.5-80-5-15-W0-LFC27-M6.SLDPRT, Set Screw-2_GEFHBB0.5-80-3-15-W0.SLDPRT]
2022-06-04 これからどうかっしゃにするよー（絶望）
    [ARL-360BE.SLDPRT, MPBZ6-15.SLDPRT, MPBZ6-20.SLDPRT, WSJK8-3-2.SLDPRT, 内接歯車機構躯体.sldprt, 展開機構ブロック.sldprt, 抑制鍵.SLDPRT]
2022-06-04 定荷重バネ追加・展開バネ決定
    [CFS0.1.SLDASM, CFS0.2.SLDASM, CFS0.4.SLDASM, DRUM_CFS0.1.SLDPRT, DRUM_CFS0.2.SLDPRT, DRUM_CFS0.4.SLDPRT, MAIN BODY_CFS0.1.SLDPRT, MAIN BODY_CFS0.2.SLDPRT]
2022-06-10 バネ展開機構構想設計済
    [ABETTF8-30.0-M3-N3.SLDPRT, BFLB4-5.SLDPRT, CBSTSR4-5.SLDPRT, R3006SB.SLDPRT, VUR16-55.SLDPRT, VUY10-55.SLDPRT, YDH3007C05F.SLDPRT, 中央フレーム.SLDPRT]
2022-06-12 足駆動回路仮決定完了
    [ARL-400BE.SLDPRT, 入力減速機.SLDASM, 入力減速機構基盤.sldprt, 腕機構.SLDASM, 腕機構減速機.SLDASM, 足駆動回路.brd, 足駆動回路.sch]
2022-06-12 足駆動回路ヒートシンク仮設計
    [798-HVH-280-3P-6.5DS.sldprt, B7B-XH-A.sldprt, BTN9990LV.sldprt, C0603.sldprt, C0805.sldprt, HVH-280-3S-HUR.SLDPRT, LEDC1608X39N_G.sldprt, Packages.sldasm]
2022-06-13 ・足駆動回路設計完 ・足駆動回路ミラーバージョン作成
    [足駆動回路.brd, 足駆動回路.sch]
2022-06-14 腕機構リミットスイッチ配置完了 close #5
    [798-HVH-280-3P-6.5DS.sldprt, B7B-XH-A.sldprt, BTN9990LV.sldprt, Board.sldprt, C0603.sldprt, C0805.sldprt, LEDC1608X39N_G.sldprt, Packages.sldasm]
2022-06-14 腕駆動回路設計開始
    [中央フレーム.SLDPRT, 中央ユニット後方カバー.sldprt, 中央躯体.sldasm, 腕機構減速機.SLDASM, 腕駆動回路.brd, 腕駆動回路.sch]
2022-06-16 腕駆動回路設計完
    [B2B-XH-A.sldprt, B3B-XH-A.sldprt, B9B-XH-A.sldprt, BTN9990LV.sldprt, BaseModel20220615135045.SLDASM, Board.sldprt, C0603.sldprt, C0805.sldprt]
2023-07-12 point : circuit desgine comp
    [ABETJ8-15.0-M3-N3.SLDPRT, ABETTF6-75.0-M3-N3.SLDPRT, ABETTF6-90.0-M3-N3.SLDPRT, ARB-340CE.SLDPRT, ARL-340BE.SLDPRT, ARL-360BE.SLDPRT, ARL-400BE.SLDPRT, ASL-315E.SLDPRT]
2023-07-12 add : AMD add res
    [腕駆動回路.brd, 腕駆動回路.sch]
2023-07-12 fix : RMD cap
    [足駆動回路.brd, 足駆動回路.sch]
2023-07-12 fix : RMD res / add : RMD cam
    [足駆動回路.brd, 足駆動回路.sch]
2023-07-12 add : boards asm
    [1X09.SLDPRT, 2X03.SLDPRT, 2X08.SLDPRT, B2B-XH-A.SLDPRT, B2P-VH.SLDPRT, B3P-VH.SLDPRT, B4B-XH-A.SLDPRT, Board.SLDPRT]
2023-07-12 fix : CB fix error
    [制御基板.brd, 電子回路ユニット.SLDASM]
2023-07-12 add : CBv4 3dCAD
    [2X03.SLDPRT.SLDPRT, Board.SLDPRT.SLDPRT, C0603.SLDPRT.SLDPRT, Packages.SLDASM.SLDASM, QFP100.SLDPRT.SLDPRT, R0603.SLDPRT.SLDPRT, TS-06104.SLDPRT.SLDPRT, XTALRR480W50L990T368H350B.SLDPRT.SLDPRT]
2023-07-12 upd : circuit board unit update
    [電子回路ユニット.SLDASM]
2023-07-12 fix : CB cam
    [Rotary Shaft_SFRMGH8-15.0-F2.8-P6-T4.9-M3.SLDPRT, 電源基盤v1.SLDPRT]
2023-07-12 fix : cam data
    [cam.brd, レシーバ.brd, 制御基板.brd, 腕駆動回路.brd, 足駆動回路.brd, 電源基盤.brd]
2023-07-12 fix : link sus parts screw shape
    [SFRMGH8-15.0-F2.8-P6-T4.9-M3.SLDASM, びしゃもん.SLDASM, リンクサス節軸.SLDPRT, リンクサス足側軸部.SLDPRT]
2023-07-12 add : RR001 drawing
    [CBSTBR3-6.SLDPRT, HTBN474S3M-60.sldprt, MPFZ10-8.SLDPRT, RS380.SLDASM, ヘッケンリンク.SLDASM, 右足機構側面充填樹脂.sldprt, 足中間歯車.sldasm, 足側板.sldprt]
2023-07-12 fix : RR pinion gear
    [CB2.6-5.SLDPRT]
2023-07-12 point : RR BOM ready comp
    [ARL-340BE.SLDPRT, CB2.6-5.SLDPRT, CLJW6-8-38.0.SLDPRT, CLJW6-8-40.0.SLDPRT, リンクサス足側軸部.SLDPRT, 足機構主柱.SLDPRT]
2023-07-12 add : R-SA001.1 drawing
    [ARL-340BE.SLDPRT, CBSTBR3-6.SLDPRT, FWSJW-D8-V6-T5.5.SLDPRT, MPBRU6-8.SLDPRT, R-SA001.1_足中間歯車1.SLDDRW, R-SA001_足中間歯車.SLDDRW, SCCN6-6.SLDASM, Shaft Collar_SCCN6-6.SLDPRT]
2023-07-12 point : RR-HL001 BOM ready comp
    [ARB-340CE.SLDPRT, CBSTBR3-10.SLDPRT, CLJW6-8-15.5.SLDPRT, FL678ZZ.SLDPRT, FWSJW-D8-V6-T6.0.SLDPRT, RR-HL001_ヘッケンリンク.SLDDRW, SFB3-10.SLDPRT, ヘッケンリンク.SLDASM]
2023-07-12 point : RR-HL-RAS001 BOM ready comp
    [B6700ZZ.SLDPRT, CBSTBR3-4.SLDPRT, RR-HL-RAS001_足単体.SLDDRW, RR-HL001_ヘッケンリンク.SLDDRW, SFB3-5.SLDPRT, WSSB5-3-2.SLDPRT, ヘッケンリンク.SLDASM, ヘッケンリンク駆動プーリー.SLDPRT]
2023-07-12 point : RR-HL-RAS002 BOM ready comp
    [RR-HL001_ヘッケンリンク.SLDDRW, RR-HL001_ヘッケンリンク右半身後方.SLDDRW, RR-HL002_ヘッケンリンク右半身前方.SLDDRW, ヘッケンリンク.SLDASM, 制御基板 v4.SLDASM, 足プーリーフランジ.SLDPRT, 足曲軸長偏心体.SLDPRT]
2023-07-12 point : Export RR BOMs
    [FWSJW-D8-V6-T5.5.SLDPRT, R-SA-GAS001.xlsx, R-SA-GAS001_足中間歯車1.SLDDRW, R-SA001.1_足中間歯車1.SLDDRW, R-SA001.xlsx, RR-HL-RAS001.xlsx, RR-HL-RAS001_足単体.SLDDRW, RR-HL001.xlsx]
2023-07-13 fix : CU fix
    [CLJW6-8-12.0.SLDPRT, ロングロッド.sldasm]
2023-07-13 fix : RL001 pinion gear
2023-07-13 fix : RR001 parts PartNo fix
    [RR001.xlsx, びしゃもん.SLDASM, ヘッケンリンク.SLDASM, ロングロッド.sldasm, 右足機構側面充填樹脂.sldprt, 足機構上面カバー.sldprt, 足機構主柱.SLDPRT, 足機構固定板.sldprt]
2023-07-13 add : RL001 subasm and parts profile fix
    [RR001.xlsx, ヘッケンリンク.SLDASM, 左足機構側面充填樹脂.sldprt]
2023-07-13 add : RL-HL002 drawing
    [RL-HL002.xlsx, RL-HL002_ヘッケンリンク左半身前方.SLDDRW, RL001.xlsx, RR-HL001.xlsx, RR-HL002.xlsx, RR-HL002_ヘッケンリンク右半身前方.SLDDRW, ヘッケンリンク.SLDASM, 足単体.SLDASM]
2023-07-13 fix : RR-HR-RAS001 bom fix
    [RL-HL-RAS001_足単体左半身.SLDDRW, RL-HL001.xlsx, RL-HL001_ヘッケンリンク左半身後方.SLDDRW, RR-HL-RAS001.xlsx, RR-HL-RAS001_足単体.SLDDRW, RR-HL-RAS001_足単体右半身.SLDDRW, ヘッケンリンク.SLDASM, 前足底.SLDPRT]
2023-07-13 add : RL-HL-RAS001 bom
    [RL-HL-RAS001.xlsx, RL-HL-RAS001_足単体左半身.SLDDRW, 前足底.SLDPRT, 足ゴム.SLDPRT, 足単体.SLDASM]
2023-07-13 point : RL001 BOM comp (close #16)
    [びしゃもん.SLDASM, ヘッケンリンク.SLDASM]
2023-07-13 add : CU001 profiles add
    [F3-2100.SLDPRT, びしゃもん.SLDASM, 中央フレーム.SLDPRT, 中央躯体.sldasm, 右足駆動回路v2.SLDPRT, 小型ファン.SLDPRT, 展開機構.sldasm, 左足駆動回路v2.SLDPRT]
2023-07-13 add : CU001 BOM
    [CU001.xlsx, びしゃもん.SLDASM, レシーバ v1.SLDPRT, 中央ユニット後方カバー.sldprt, 中央躯体.sldasm, 足駆動回路放熱板.SLDPRT]
2023-07-13 add : CU-SAS003 drawing
    [CU-SAS003_展開機構.SLDDRW]
2023-07-13 point : CU-SAS003 asem fix
    [ARL-360BE.SLDPRT, MPBZ6-15.SLDPRT, WSJK8-3-2.SLDPRT, 展開機構.sldasm, 展開機構ブロック.sldprt, 抑制鍵.SLDPRT]
2023-07-13 add : CU-SAS003 BOM
    [CU-SAS003.xlsx, CU-SAS003_展開機構.SLDDRW]
2023-07-13 fix : CU-SAS001 parts fix
    [CFS0.4.SLDASM, VUR16-55.SLDPRT, VUY10-55.SLDPRT, 中央フレーム.SLDPRT, 中央ユニット主軸.SLDPRT, 中央躯体.sldasm, 横展開抜止め.SLDPRT]
2023-07-13 add : CU-SAS001 drawing
    [CU-SAS001_中央躯体.SLDDRW]
2023-07-13 add : CU-SAS001 BOM (close #20)
    [CU-SAS001.xlsx, 中央躯体.sldasm, 展開機構.sldasm]
2023-07-13 point : CU-SAS002 parts profile fix (other arm parts)
    [B6805ZZ.SLDPRT, Rotary Shaft_SFRMGH8-15.0-F2.8-P6-T4.9-M3.SLDPRT, SFRMGH8-15.0-F2.8-P6-T4.9-M3.SLDASM, SS_10GL13.SLDASM, YDH3007C05F.SLDPRT, 最集段ピニオン.SLDPRT, 腕機構内壁.sldprt]
2023-07-13 point : CU-SAS002 arm parts profile fix
    [SFHRW6-103.0-M3-N3.SLDASM, SFRHH6-109.0-F2.5-P5-T2.5-M3.SLDASM, アームリンク中関節.sldasm, アームリンク駆動節.sldasm, ロングロッド.sldasm]
2023-07-13 add : CU-SAS002 drawing
    [SFRMGH8-15.0-F2.8-P6-T4.9-M3.SLDASM]
2023-07-13 add : CU-SAS002 BOM (close #22)
    [CU-SAS002.xlsx]
2023-07-13 add : CU-SAS002 BOM
    [CU-SAS002.xlsx]
2023-07-13 fix : CU-SAS002 BOM
    [CU-SAS002.xlsx, SFRHH6-109.0-F2.5-P5-T2.5-M3.SLDASM]
2023-07-13 add : CU-AAS001 drawing
    [ABETTF6-75.0-M3-N3.SLDPRT, BFLB6-5.SLDPRT, CU-AAS001_アームリンク中関節.SLDDRW, アームリンク中関節.sldasm, 中関節.SLDPRT]
2023-07-13 add : CU-AAS001 bom
    [CU-AAS001.xlsx, CU-AAS001_アームリンク中関節.SLDDRW, アームリンク中関節.sldasm]
2023-07-13 point : CU-AAS002 profile add
    [ABETTF6-90.0-M3-N3.SLDPRT, アームリンク駆動節.sldasm, 従動節根本軸.SLDPRT, 駆動節.SLDPRT, 駆動節歯車付き.SLDPRT]
2023-07-13 add : CU-AAS002 bom
    [CU-AAS002.xlsx, CU-AAS002_アームリンク駆動節.SLDDRW, アームリンク駆動節.sldasm]
2023-07-13 add : CU-AAS003L drawingm
    [CL-306E.SLDPRT, CU-AAS003L_ロングロッド.SLDDRW, ロッド先端.SLDPRT, ロングロッド.sldasm, 従動節.SLDPRT]
2023-07-13 add : CU-AAS003L bom
    [CU-AAS003L.xlsx]
2023-07-13 add : CU-AAS003R bom (close #26)
    [CU-AAS003R.xlsx, CU-AAS003R_ロングロッド.SLDDRW, ロングロッド.sldasm, 従動節.SLDPRT]
2023-07-13 point : CGA75-RS380-4 parts profile fix
    [CB2.6-5.SLDPRT, 内接減速機構.SLDASM, 腕機構回路放熱板.SLDPRT, 腕電動機取付板.SLDPRT, 腕駆動回路v2.SLDPRT]
2023-07-13 fix : CGA75 parts profiles
    [B676ZZ.SLDPRT, B6800ZZ.SLDPRT, B6802ZZ.SLDPRT, BFLB4-5.SLDPRT, CBSTSR4-5.SLDPRT, CGA75-RS380-4.xlsx, GEFHBB0.5-80-5-15-W0-LFC27-M6.SLDASM, Spur Gears_GEFHBB0.5-80-5-15-W0-LFC27-M6.SLDPRT]
2023-07-13 add : CGA75 drawing
    [CGA75_内接減速機構.SLDDRW, 内接減速機構.SLDASM]
2023-07-13 add : CGA75 bom
    [B6809ZZ.SLDPRT, CGA75.xlsx, CGA75_内接減速機構.SLDDRW, ロングロッド.sldasm, 内接減速機構.SLDASM, 曲軸.SLDPRT]
2023-07-15 fix : CU-P002 screw hole
    [4T-30204.sldasm, 4T_30204_3.sldprt, 4T_30204_5.sldprt, 4T_30204_7.sldprt, ABETJ8-15.0-M3-N3.SLDPRT, ABETTF8-30.0-M3-N3.SLDPRT, ARB-340CE.SLDPRT, ASL-315E.SLDPRT]
2023-07-15 add : circuit spacer (close #23)
    [BRL-2011SBE.SLDPRT, BRL-311SBE.SLDPRT, CBSTBR2-10.SLDPRT, CBSTBR2-5.SLDPRT, CBSTSR4-8.SLDPRT, MBIS2-3-2.SLDPRT, アームリンク駆動節.sldasm, 中央フレーム.SLDPRT]
2023-07-15 fix : AAS002-P002/3 shape fix
    [PJLS10-5.SLDPRT, Rotary Shaft_SFRHH6-109.0-F2.5-P5-T2.5-M3.SLDPRT, SFRHH6-109.0-F2.5-P5-T2.5-M3.SLDASM, 腕機構内壁.sldprt, 駆動節.SLDPRT, 駆動節歯車付き.SLDPRT]
2023-07-15 add : plunger add
    [アームリンク駆動節.sldasm]
2023-07-16 add : counter arm
    [DPS-C6X20.SLDPRT, アームリンク駆動節.sldasm, ロッド先端.SLDPRT, ロングロッド.sldasm, 従動節.SLDPRT, 腕機構内壁.sldprt, 駆動節歯車付き.SLDPRT]
2023-07-16 point : counter arm desgine comp.(close #2)
    [Rotary Shaft_SFRMGH8-15.0-F2.8-P6-T4.9-M3.SLDPRT, SFRMGH8-15.0-F2.8-P6-T4.9-M3.SLDASM, びしゃもん.SLDASM, カウンターアーム.SLDPRT, カウンターアームロック.SLDPRT, ヘッケンリンク.SLDASM, 中央フレーム.SLDPRT, 中央ユニット後方カバー.sldprt]
2023-07-16 point : desgine comp.
    [びしゃもん.SLDASM, カウンターアーム.SLDPRT, ﾐﾗｰカウンターアーム.SLDPRT]
2023-07-16 point : desgine comp (close #10)
    [001.xlsx, CBSTBR2-10.SLDPRT, CGA75-RS380-4.xlsx, CGA75.xlsx, CGA75_内接減速機構.SLDDRW, CU-AAS001.xlsx, CU-AAS001_アームリンク中関節.SLDDRW, CU-AAS002.xlsx]
2023-07-16 add : CGA75-RS380-4 BOM
    [BOM.xlsx, CGA75-RS380-4.xlsx]
2023-07-16 point : bom asem comp.
    [BOM.xlsx]
2023-07-18 add : BOM add manuBOM
    [ARL-340BE.SLDPRT, BOM.xlsx]
2023-07-18 add : CGA75-P001 CAM
    [BOM.xlsx]
2023-07-18 add : CAM files
    [BOM.xlsx, CAM.SLDASM, CAM_CU-AAS002-P001.SLDASM, CAM_CU-SAS002-P001.SLDASM, CAM_T10_1.SLDASM, CAM_T12_1.SLDASM, CAM_T2_1.SLDASM, CAM_T2_2.SLDASM]
2023-07-27 point : CAM_T3_2 cam comp
    [CAM_T3_2.SLDASM]
2023-07-28 point : CAM_T2_1 cam comp
    [BOM.xlsx, CAM_T2_1.SLDASM, CAM_T3_2.SLDASM, 足レバー.SLDPRT, 足機構曲軸結合部.SLDPRT]
2023-07-28 point : CAM_T2_2 cam comp
    [CAM_T2_1.SLDASM, CAM_T2_2.SLDASM]
2023-07-29 point : CAM_T12_1 cam comp
    [CAM_T12_1.SLDASM, 足曲軸短偏心体.SLDPRT, 足曲軸長偏心体.SLDPRT]
2023-07-29 point : CAM_T2_3 cam comp
    [CAM_T2_2.SLDASM, CAM_T2_3.SLDASM]
2023-07-30 add : CAM_t3_3
    [CAM.SLDASM, CAM_T10_1.SLDASM, CAM_T12_1.SLDASM, CAM_T2_2.SLDASM, CAM_T2_3.SLDASM, CAM_T3_3.SLDASM, CAM_T5_1.SLDASM, CAM_T8_1.SLDASM]
2023-08-18 point : make comp
    [BOM.xlsx, CAM_CU-AAS002-P001.SLDASM, CAM_CU-SAS002-P001.SLDASM, CAM_T12_1.SLDASM, CAM_T2_3.SLDASM, CAM_T3_3.SLDASM, CAM_T5_1.SLDASM, CU-SAS0002-P001_腕機構内壁.SLDDRW]
2023-08-18 add : Arduino work space
    [制御基板.sch]
2023-08-18 add : motordrive.hpp
2023-08-19 point : add read res
    [制御基板.brd, 前足底2.SLDPRT]
2023-08-26 point : 本番前
    [ヘッケンリンク.SLDASM, ヘッケンリンク駆動プーリー.SLDPRT, リンクサス短辺.SLDPRT, リンクサス短辺2.SLDPRT, リンクサス長辺.SLDPRT, リンクサス長辺2.SLDPRT, 内歯車.SLDPRT, 前足底.SLDPRT]
2024-06-11 fix : file broken
    [びしゃもん.SLDASM, ヘッケンリンク.SLDASM, 足ゴム.SLDPRT, 足単体.SLDASM]
2025-05-29 add : 第30回用設計基本書
2025-05-29 add : 長ねじ挿入
2025-05-29 point : CAD修正終了
